lgc-robotics/end_effector_project/英红九号-郑晓鑫/工程图/新刀架2.tif

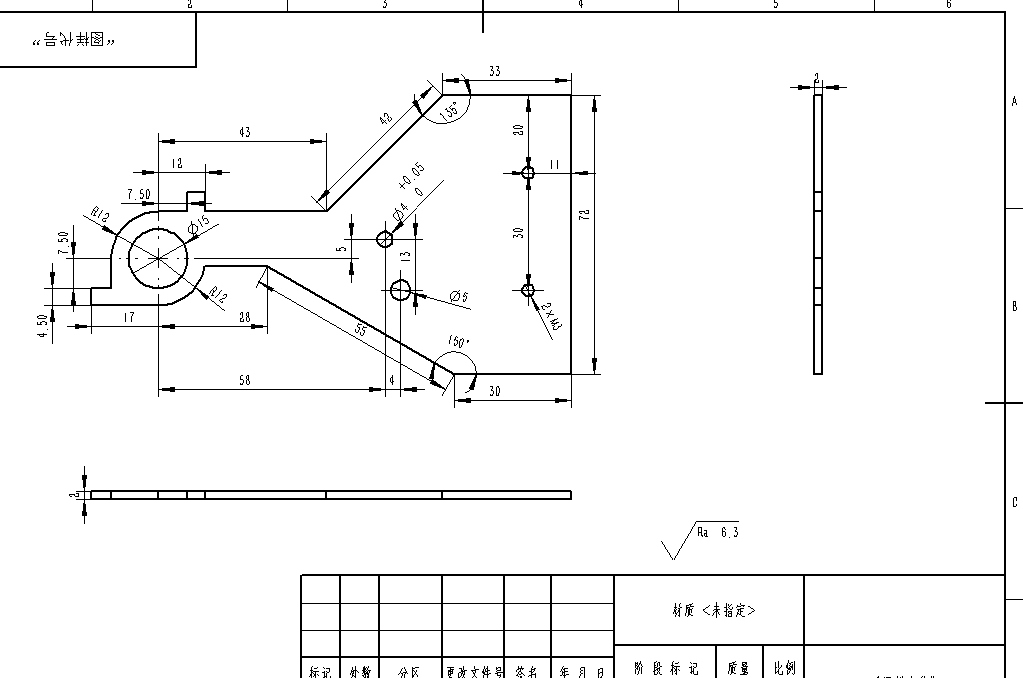
英红九号-郑晓鑫/工程图/新刀架2.tif
