lgc-robotics/end_effector_project/英红九号-郑晓鑫/末端装配6.16.SLDASM

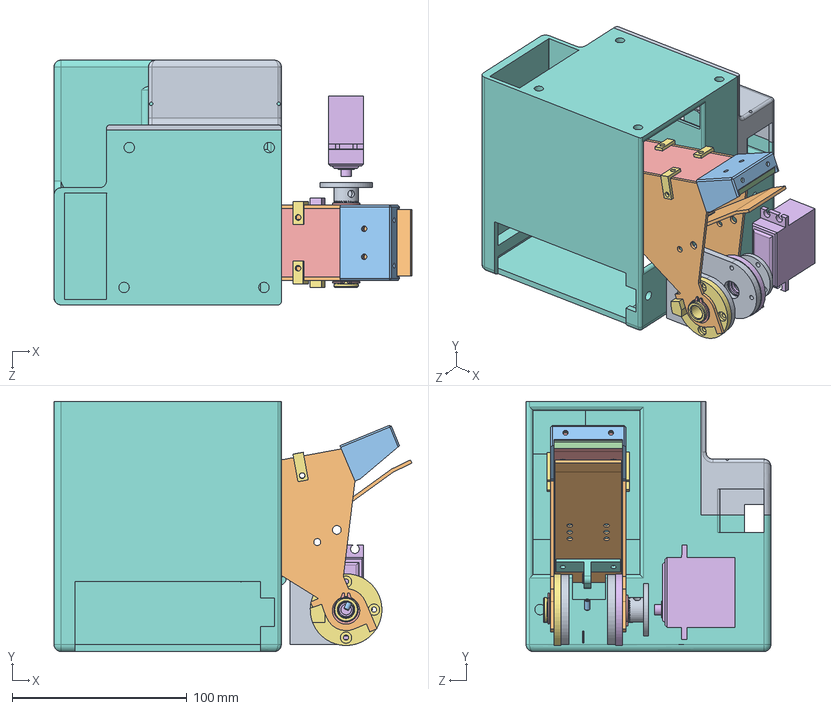
[picture p29: CAD file, 2026-08-05]
英红九号-郑晓鑫/末端装配6.16.SLDASM
204.7 x 143.1 x 140.0 mm
底座零件 x 2
T型块1
上刀轴套
上刀轴套右
卡簧 x 2
卡簧φ3 x 2
紧固螺钉m3-6
下刀板
轴盘
新刀架2 x 2
上刀座
上刀片
上刀架
舵机主体
上刀板L型块 x 4
零件3
封盖
