lgc-robotics/end_effector_project/夹剪复合末端执行器-谭键聪/图纸/链接板.SLDPRT.SLDPRT

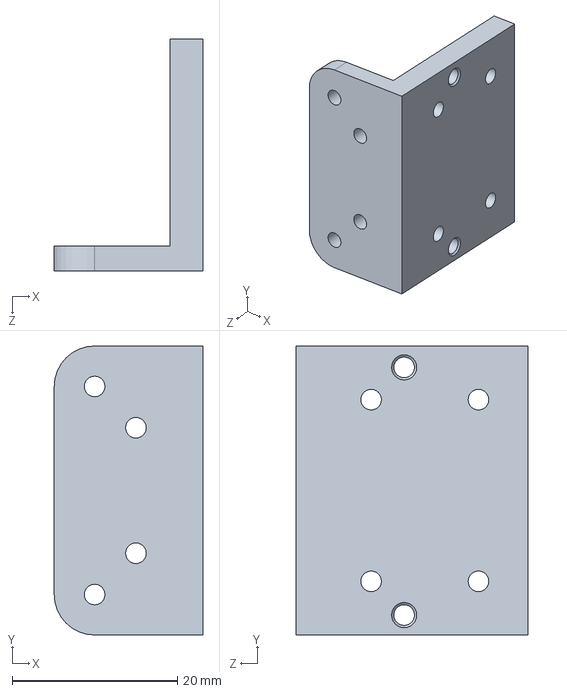
[picture p30: CAD file, 2026-08-05]
夹剪复合末端执行器-谭键聪/图纸/链接板.SLDPRT.SLDPRT
18.0 x 35.0 x 28.1 mm
