lgc-robotics/end_effector_project/夹剪复合末端执行器-谭键聪/装配体.STEP

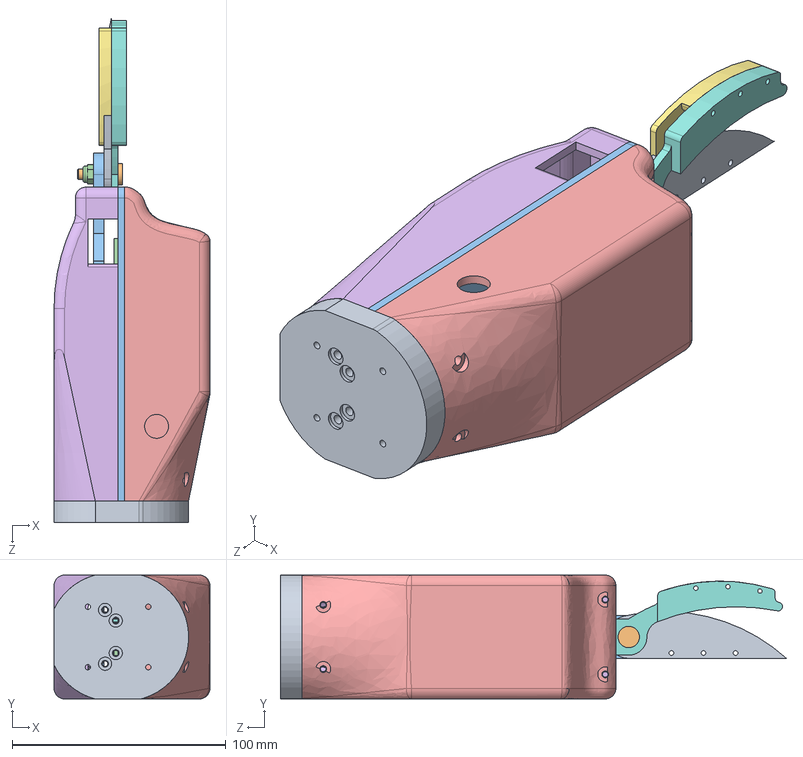
[picture p31: CAD file, 2026-08-05]
夹剪复合末端执行器-谭键聪/装配体.STEP
73.0 x 58.0 x 236.8 mm
后法兰
链接板
底板(5.29)
舵机
舵盘
主动齿轮_GB - Spur gear 0.8M 30T 20PA 5FW ---S30A75H50L6.0N
静刀上
静刀
20度刀
轴
从动齿轮
m5防松螺母
零件2_剪切部分装配体
零件4_剪切部分装配体
