lgc-robotics/end_effector_project/夹剪复合末端执行器-谭键聪/零件/step/零件3.STEP

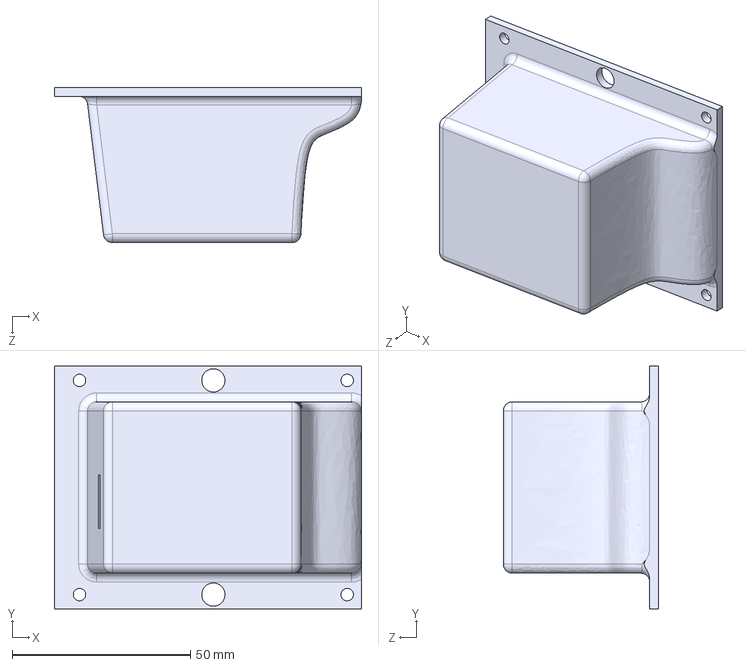
[picture p32: CAD file, 2026-08-05]
夹剪复合末端执行器-谭键聪/零件/step/零件3.STEP
86.0 x 68.0 x 43.5 mm
