lgc-robotics/end_effector_project/夹剪复合末端执行器-谭键聪/零件/静刀.SLDPRT

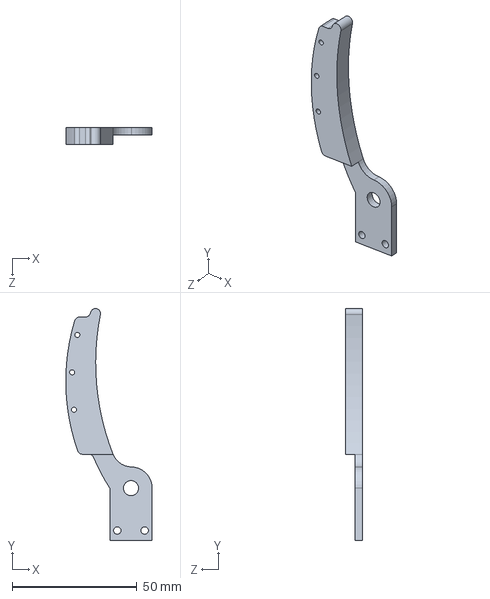
[picture p33: CAD file, 2026-08-05]
夹剪复合末端执行器-谭键聪/零件/静刀.SLDPRT
34.6 x 93.0 x 7.00 mm
