lgc-robotics/end_effector_project/潭江茶-谭键聪/第一代谭江茶/加工件/step/小轴长.STEP

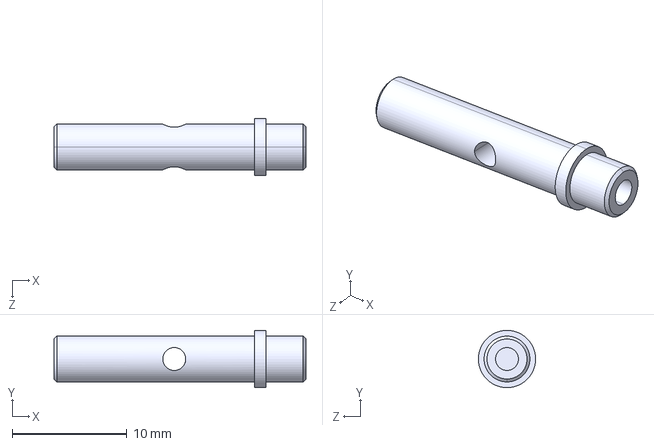
[picture p34: CAD file, 2026-08-05]
潭江茶-谭键聪/第一代谭江茶/加工件/step/小轴长.STEP
22.0 x 5.00 x 5.00 mm
