lgc-robotics/end_effector_project/潭江茶-谭键聪/第一代谭江茶/加工件/新收集盒1.step.SLDPRT

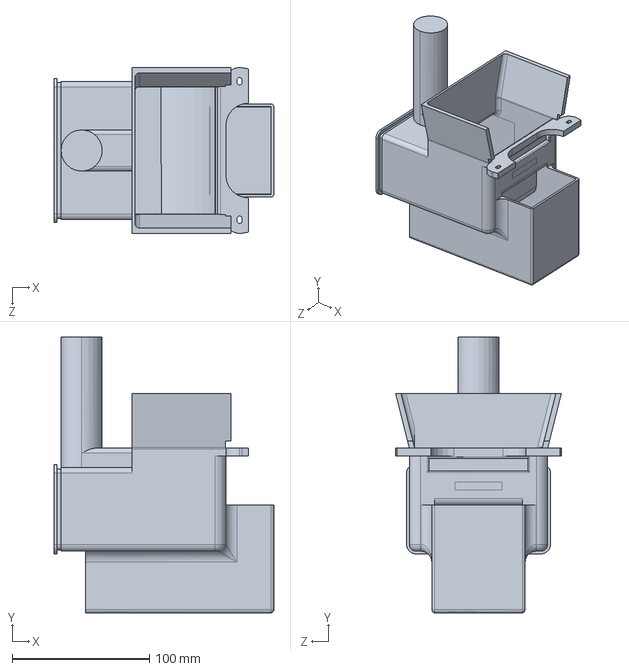
[picture p35: CAD file, 2026-08-05]
潭江茶-谭键聪/第一代谭江茶/加工件/新收集盒1.step.SLDPRT
160.0 x 201.0 x 120.8 mm
