lgc-robotics/end_effector_project/潭江茶-谭键聪/第一代谭江茶/打印件/上盖挡边2.SLDPRT

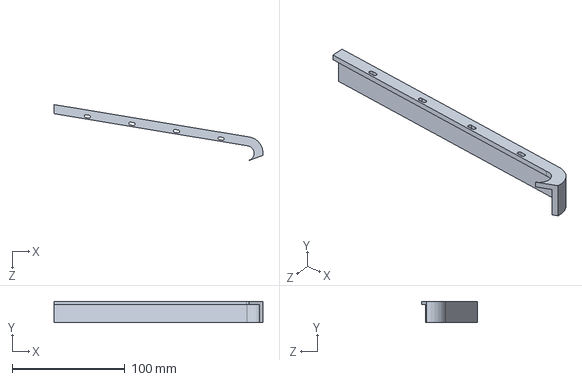
[picture p36: CAD file, 2026-08-05]
潭江茶-谭键聪/第一代谭江茶/打印件/上盖挡边2.SLDPRT
185.2 x 19.0 x 49.5 mm
