lgc-robotics/end_effector_project/潭江茶-谭键聪/第一代谭江茶/打印件/新建文件夹/盖板.STEP

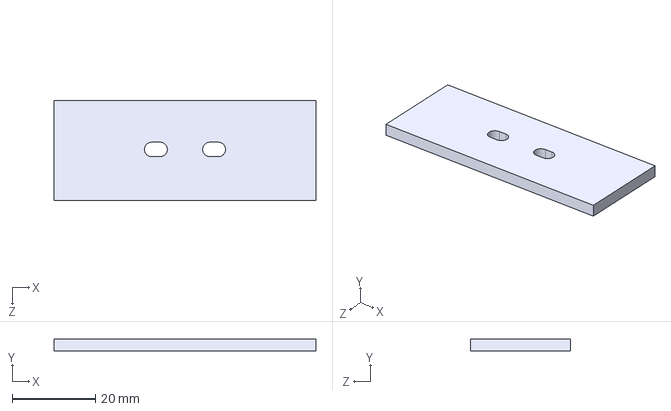
[picture p37: CAD file, 2026-08-05]
潭江茶-谭键聪/第一代谭江茶/打印件/新建文件夹/盖板.STEP
63.0 x 3.00 x 24.0 mm
