lgc-robotics/end_effector_project/潭江茶-谭键聪/第一代谭江茶/装配体1.STEP

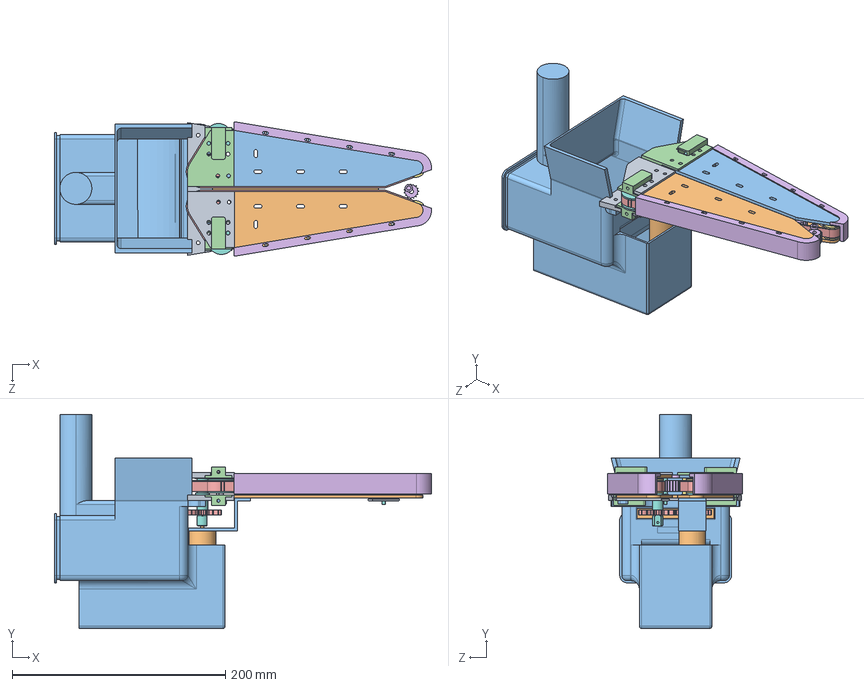
[picture p38: CAD file, 2026-08-05]
潭江茶-谭键聪/第一代谭江茶/装配体1.STEP
353.4 x 201.0 x 126.2 mm
底座后
底座前
电机架
大轴承 x 3
30齿 x 2
15齿无挡边 x 2
15齿有挡边 x 2
22齿有挡边 x 2
22齿轴 x 2
电机
滑块 x 4
滑块底座 x 4
皮带 x 2
小轴承 x 10
小轴短 x 3
主动轴 x 2
上盖1后
上盖1前
上盖2
上盖2后
spur gear_gb_GB - Spur gear 2M 16T 20PA 5FW ---S16A75H50L10.0N x 2
上盖挡边1
上盖挡边2
8mm轴承 x 2
小轴长改
刀片新
新收集盒1.step
