lgc-robotics/end_effector_project/潭江茶-谭键聪/第一代谭江茶/购买件/30齿.SLDPRT

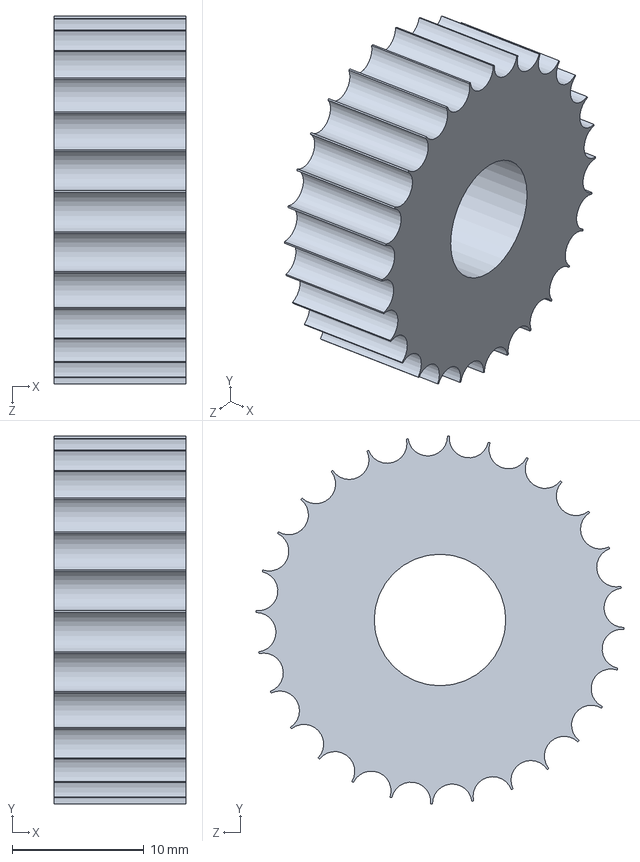
[picture p39: CAD file, 2026-08-05]
潭江茶-谭键聪/第一代谭江茶/购买件/30齿.SLDPRT
10.0 x 28.0 x 28.0 mm
