lgc-robotics/end_effector_project/潭江茶-谭键聪/第二代潭江茶/文件整合/step/上板右后.STEP

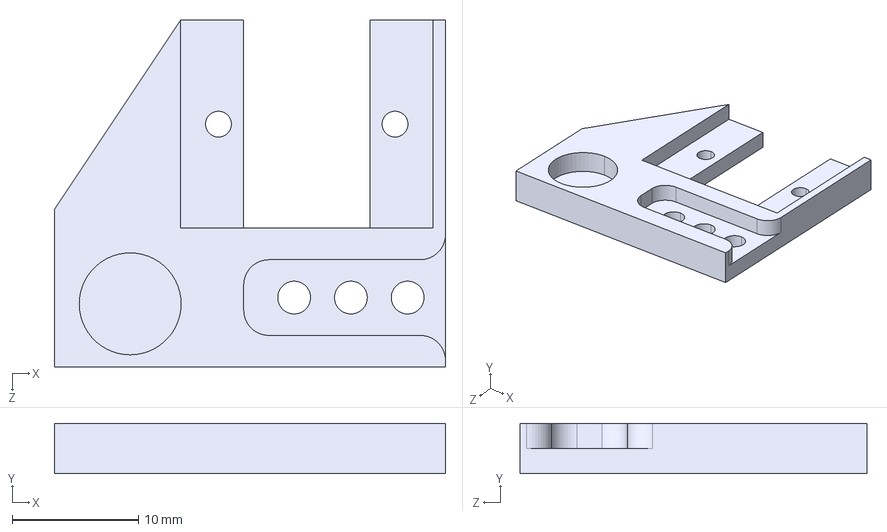
[picture p40: CAD file, 2026-08-05]
潭江茶-谭键聪/第二代潭江茶/文件整合/step/上板右后.STEP
31.0 x 4.00 x 27.5 mm
