lgc-robotics/end_effector_project/潭江茶-谭键聪/第二代潭江茶/文件整合/伞齿轮.SLDPRT

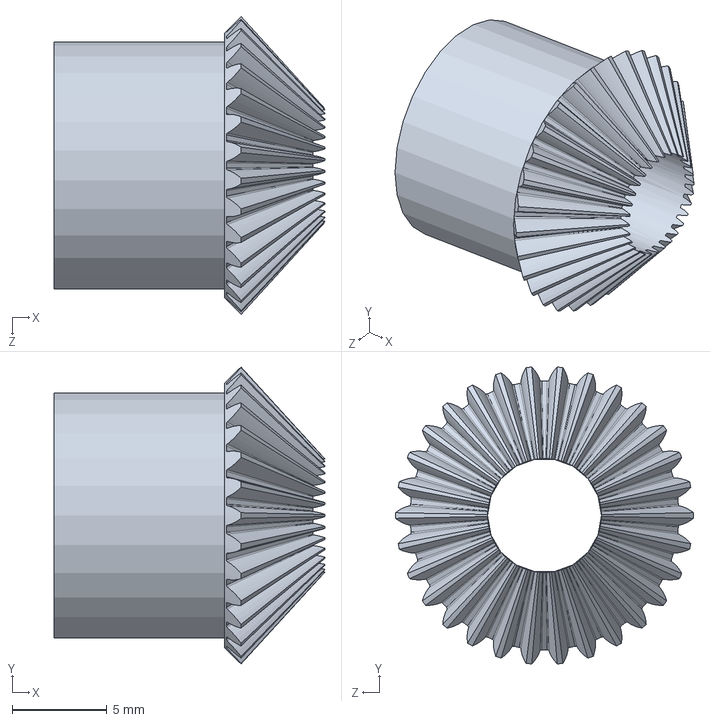
[picture p41: CAD file, 2026-08-05]
潭江茶-谭键聪/第二代潭江茶/文件整合/伞齿轮.SLDPRT
14.3 x 15.6 x 15.7 mm
