lgc-robotics/end_effector_project/潭江茶-谭键聪/第二代潭江茶/装配体.STEP

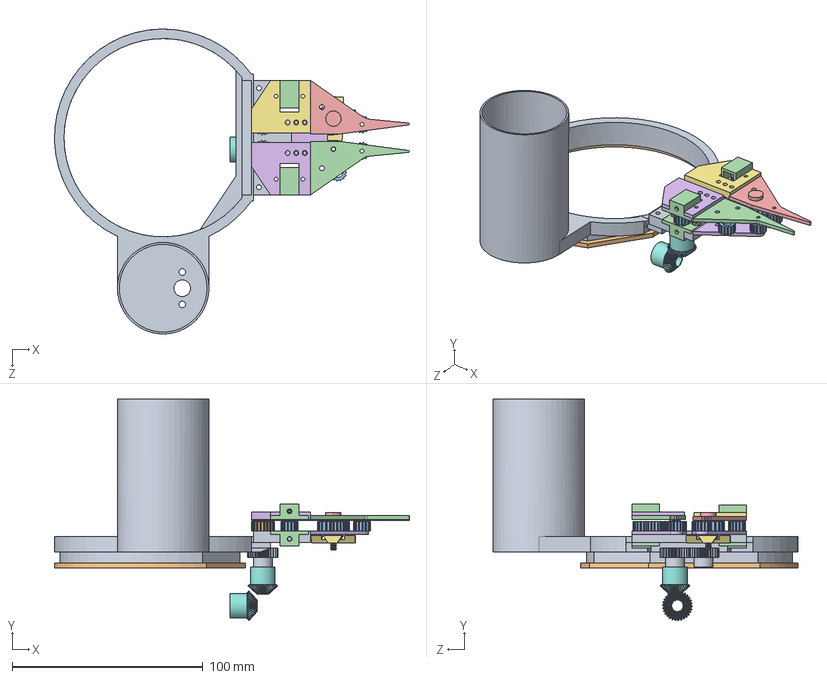
[picture p42: CAD file, 2026-08-05]
潭江茶-谭键聪/第二代潭江茶/装配体.STEP
186.2 x 116.2 x 159.9 mm
底板后
大带轮（20齿）22 x 2
带轮15齿.step x 5
滑块槽 x 4
绷紧块 x 4
上板右后
上板左后
轴
收集盒2
刀轮
上板右前1
上板左前1
底板前.step
刀片改
straight bevel pinion_gb_GB - Straight bevel pinion 0.5M30PT 30GT 20PA 12FW ---30O13H17MD6.0N x 2
spur gear_gb_GB - Spur gear 0.5M 30T 20PA 5FW ---S30B10H10L5.0N x 2
