lgc-robotics/end_effector_project/番石榴-丘圳中/番石榴装配体.STEP

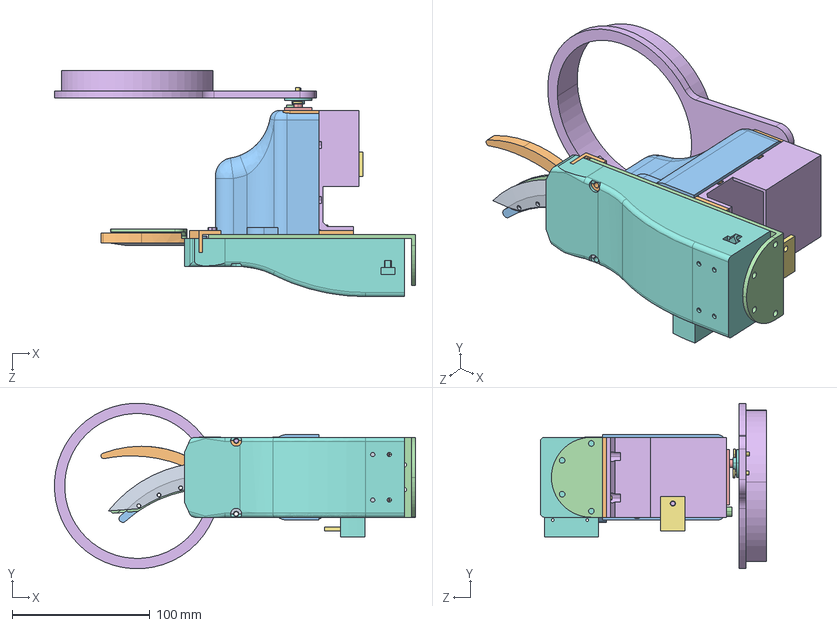
[picture p43: CAD file, 2026-08-05]
番石榴-丘圳中/番石榴装配体.STEP
261.7 x 119.8 x 164.0 mm
m5防松螺母
静刀5.10
轴
底板(5.29)
舵机 x 2
管口
M3螺斯 x 7
舵盘 x 2
电路板
L型连接板
下壳
螺丝 x 2
m4螺母 x 3
m3螺母 x 3
主动齿轮5.10_GB - Spur gear 0.8M 30T 20PA 5FW ---S30A75H50L6.0N
从动齿轮5.10_GB - Spur gear 0.8M 70T 20PA 5FW ---S70A75H50L6.0N
动刀5.10
挡板
泡棉挡块
泡棉挡块2
绝缘板
电池支架
电池锁定扣
外壳（6.30）(2)
