lgc-robotics/end_effector_project/番石榴_傅文平/末端执行器.STEP

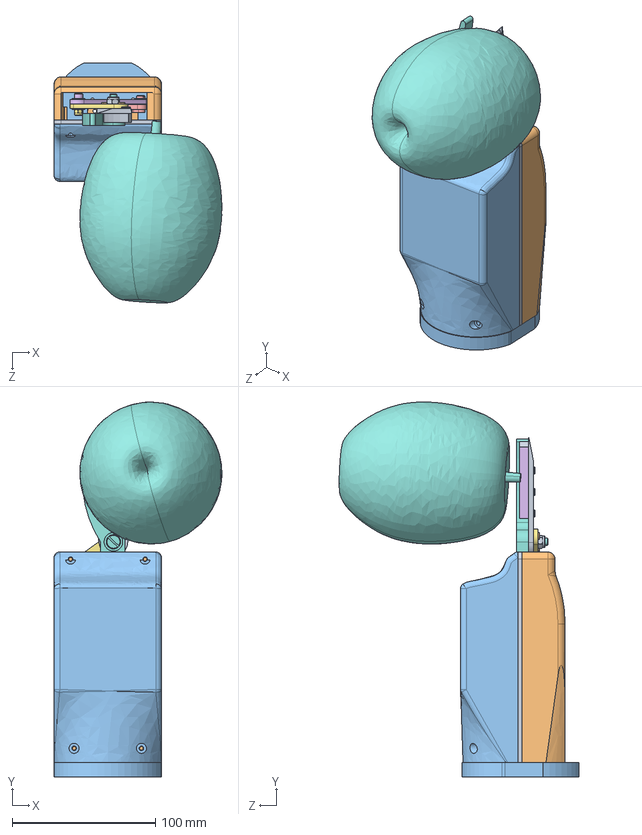
[picture p44: CAD file, 2026-08-05]
番石榴_傅文平/末端执行器.STEP
117.2 x 261.7 x 167.3 mm
底板5.25
lianijie
falan
舵机
LV-DUOBAN_1
连杆
摇杆
静刀
20度刀23
上
下
轴承 x 3
LC-TBH84-d4-L6
EMLC-S1-N-M3_EMLC-C2-N~EMLC-S1-N
EDDG-S3W-d6-L10
EMLC-S1-N-M5_EMLC-C2-N~EMLC-S1-N
ELSV-S1W-M3-L5-S5 x 2
GB╱T 29.1-2013[六角头带槽螺栓M3×10]_M3×10 x 2
GB╱T 29.2-1988[十字槽凹穴六角头螺栓M4×14]_M4×14 x 4
零件
复件 零件12^5.25
ELSV-S1W-M2-L8-S5 x 3
果实
零件1^5.25
