lgc-robotics/end_effector_project/英红九号-何子健/第二代末端执行器20261014/加工件/收集舵机固定架.SLDPRT

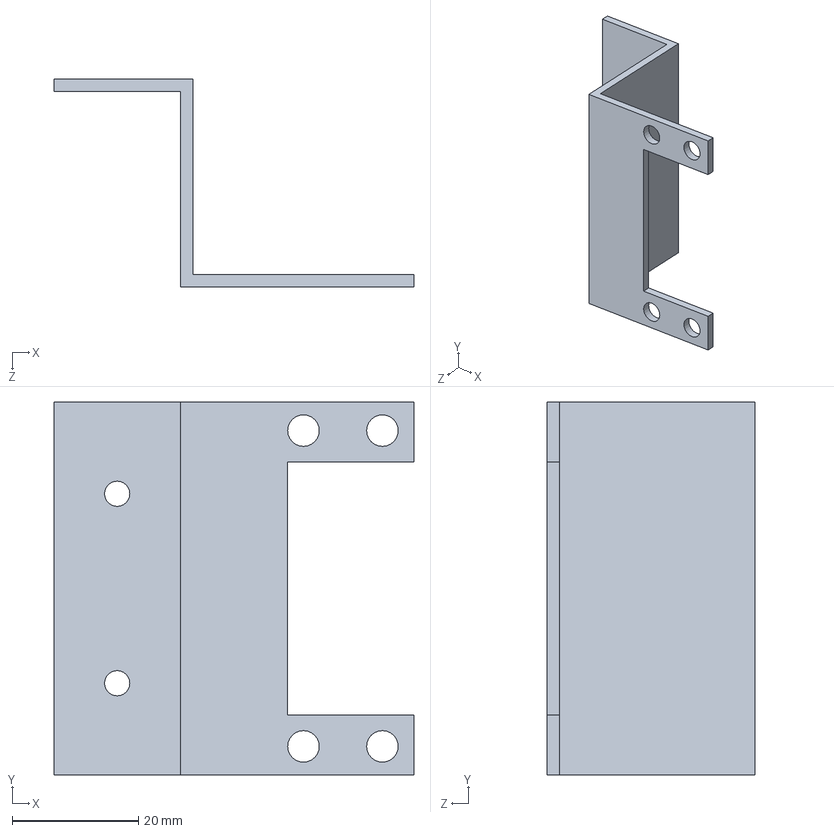
[picture p45: CAD file, 2026-10-14]
英红九号-何子健/第二代末端执行器20261014/加工件/收集舵机固定架.SLDPRT
57.0 x 59.0 x 33.0 mm
