lgc-robotics/end_effector_project/英红九号-何子健/第二代末端执行器20261014/打印件/收集轴盘.SLDPRT

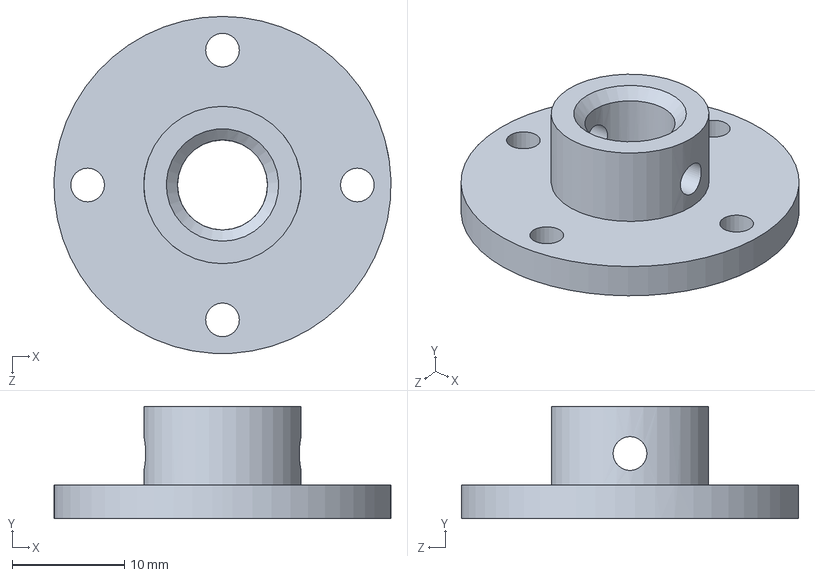
[picture p46: CAD file, 2026-10-14]
英红九号-何子健/第二代末端执行器20261014/打印件/收集轴盘.SLDPRT
30.0 x 10.0 x 30.0 mm
