lgc-robotics/end_effector_project/英红九号-何子健/第二代末端执行器20261014/提拉式末端执行器.STEP

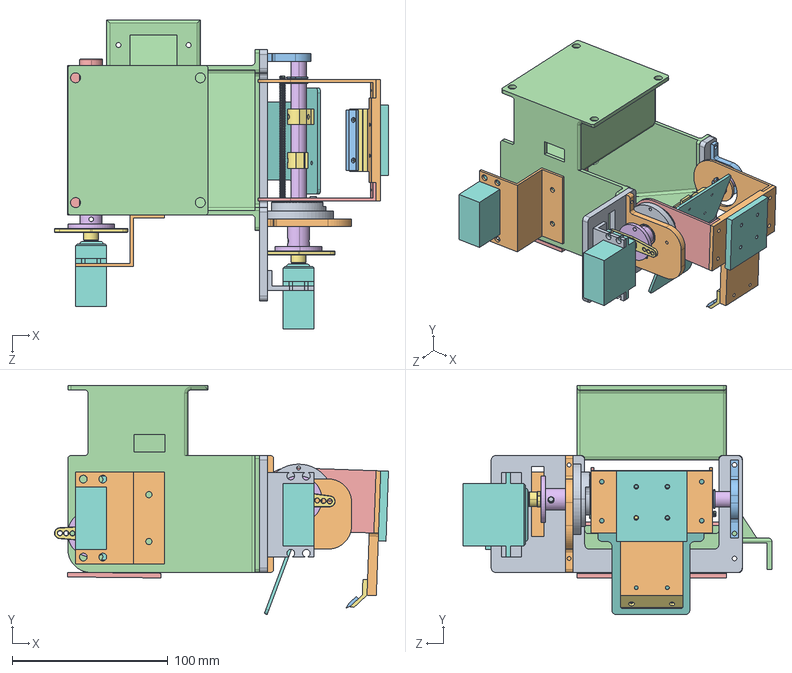
[picture p47: CAD file, 2026-10-14]
英红九号-何子健/第二代末端执行器20261014/提拉式末端执行器.STEP
214.2 x 147.0 x 198.0 mm
基准板
右轴承座
左轴承座
轴承（6x10x3）
轴承（8x16x4）
转轴
固定夹 x 2
下鄂
限位凸台
上颚
C型弹性挡圈-轴用 DQA[DQA-10] x 2
新m3-50
右侧板
轴盘
十字臂 x 2
舵机主体 x 2
新缓冲垫 x 2
左侧板
新刀片
外壳_hzj
收集下板
收集轴盘
刀片连接件
重物
执行舵机固定板
收集舵机固定架
