lgc-robotics/end_effector_project/英红九号-何子健/第二代末端执行器20261014/购买件/新缓冲垫.SLDPRT

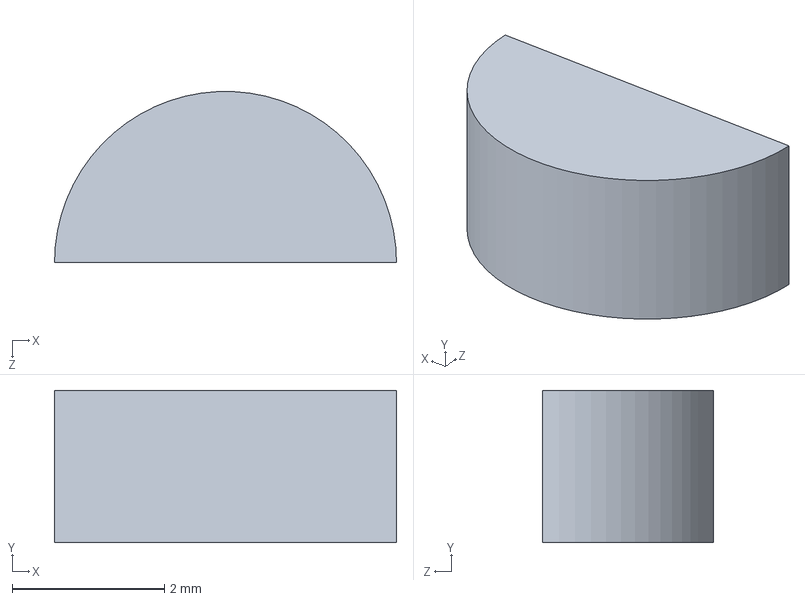
[picture p48: CAD file, 2026-10-14]
英红九号-何子健/第二代末端执行器20261014/购买件/新缓冲垫.SLDPRT
4.50 x 2.00 x 2.25 mm
