lgc-robotics/end_effector_project/英红九号-何子健/第二代末端执行器20261014/零件STEP/限位凸台.STEP

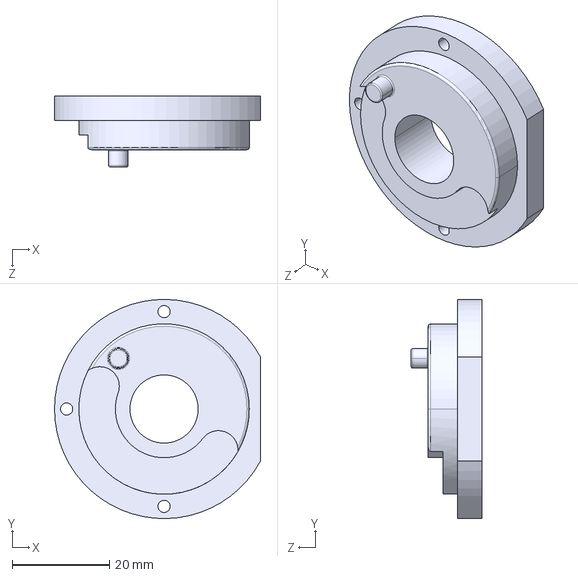
[picture p49: CAD file, 2026-10-14]
英红九号-何子健/第二代末端执行器20261014/零件STEP/限位凸台.STEP
42.3 x 45.0 x 14.5 mm
