lgc-robotics/end_effector_project/英红九号-郑晓鑫/step/45钢/主体轴.STEP

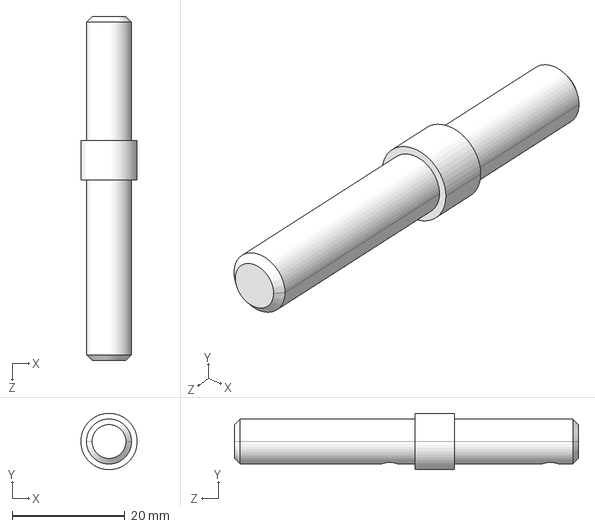
[picture p50: CAD file, 2026-08-05]
英红九号-郑晓鑫/step/45钢/主体轴.STEP
10.0 x 10.0 x 61.0 mm
