lgc-robotics/end_effector_project/英红九号-郑晓鑫/step/铝合金/新刀架2.STEP

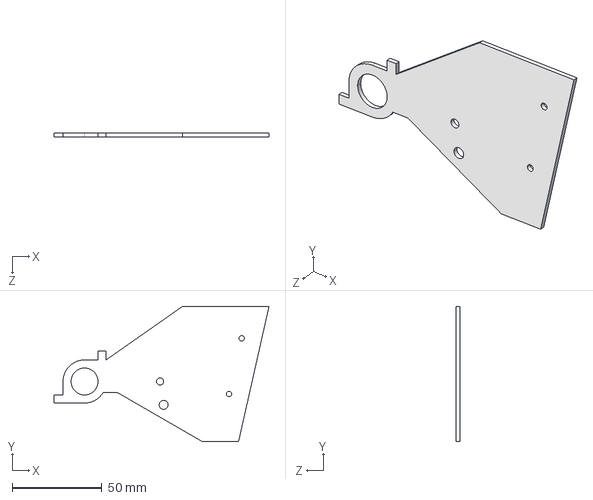
[picture p51: CAD file, 2026-08-05]
英红九号-郑晓鑫/step/铝合金/新刀架2.STEP
119.6 x 75.3 x 2.00 mm
