lgc-robotics/end_effector_project/英红九号-郑晓鑫/step/高速钢/上刀片.STEP

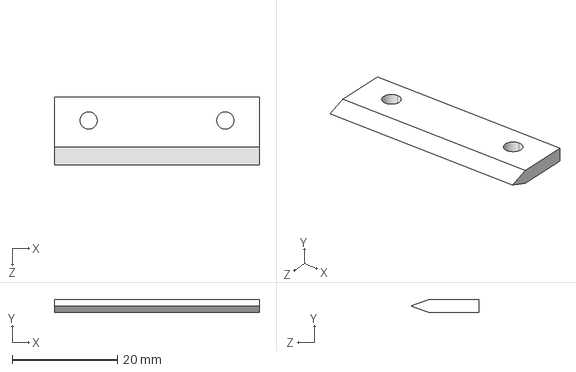
[picture p52: CAD file, 2026-08-05]
英红九号-郑晓鑫/step/高速钢/上刀片.STEP
39.0 x 2.50 x 13.0 mm
