lgc-robotics/end_effector_project/英红九号-郑晓鑫/底座零件.SLDPRT

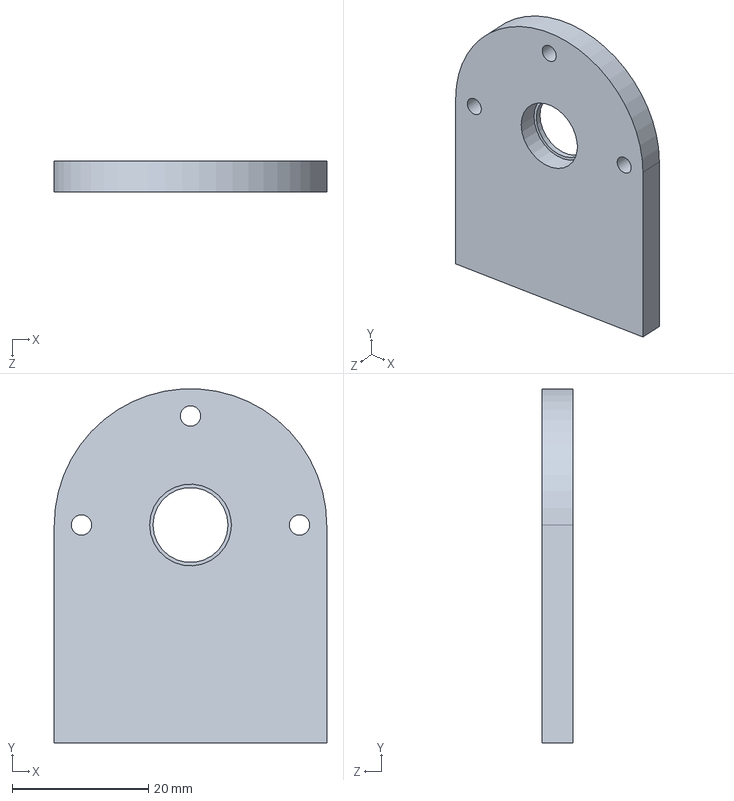
[picture p53: CAD file, 2026-08-05]
英红九号-郑晓鑫/底座零件.SLDPRT
40.0 x 52.0 x 4.50 mm
