lgc-robotics/end_effector_project/英红九号-郑晓鑫/打印/封盖.SLDPRT

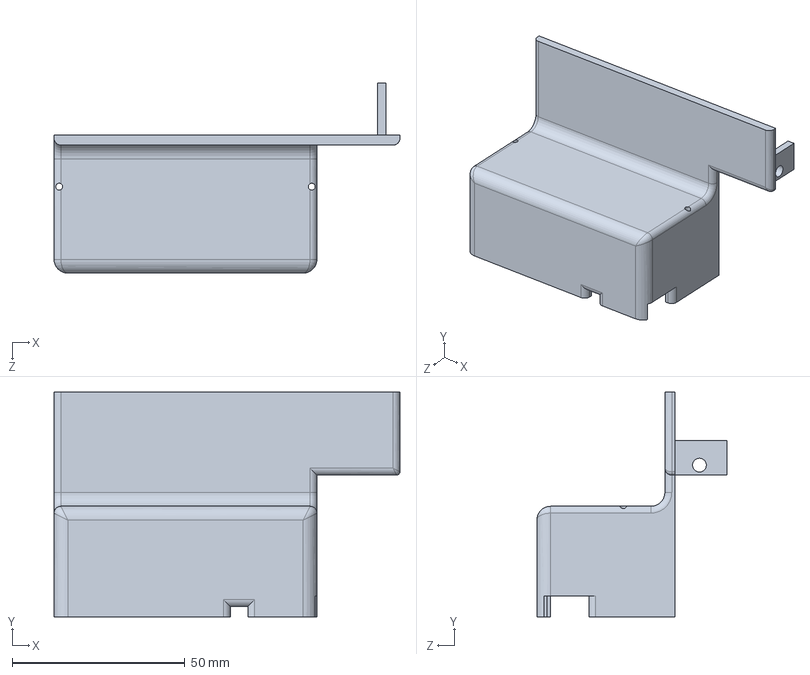
[picture p54: CAD file, 2026-08-05]
英红九号-郑晓鑫/打印/封盖.SLDPRT
100.0 x 65.0 x 55.0 mm
