lgc-robotics/end_effector_project/英红九号-郑晓鑫/打印/最新版/新抽屉.STL

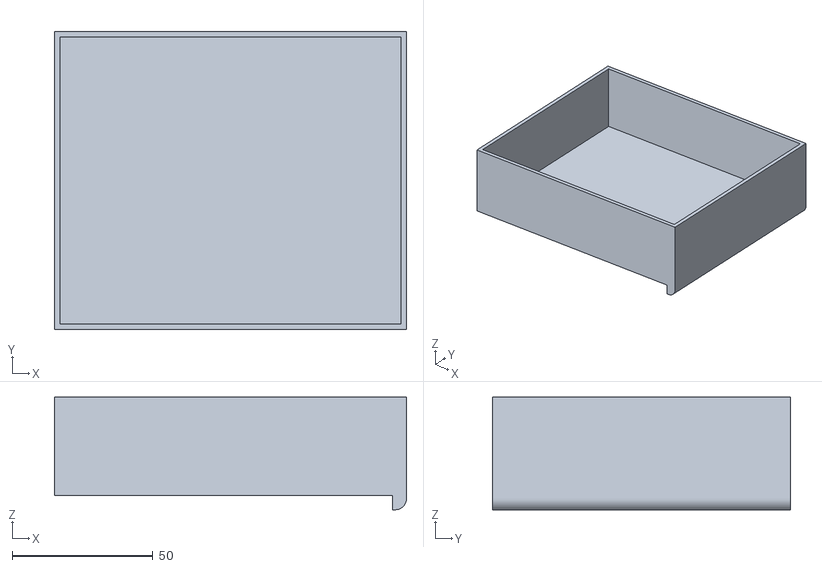
[picture p55: CAD file, 2026-08-05]
英红九号-郑晓鑫/打印/最新版/新抽屉.STL
125.0 x 105.8 x 40.0
