lgc-robotics/end_effector_project/英红九号-郑晓鑫/购买件/紧固螺钉m3-6.SLDPRT

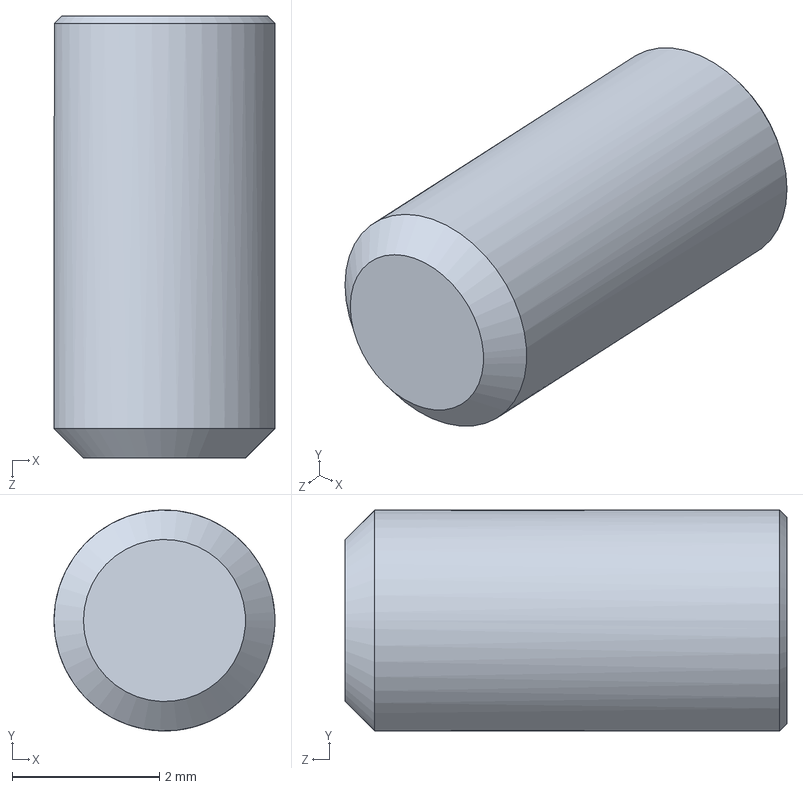
[picture p56: CAD file, 2026-08-05]
英红九号-郑晓鑫/购买件/紧固螺钉m3-6.SLDPRT
3.00 x 3.00 x 6.00 mm
