lgc-robotics/end_effector_project/蘑菇-姚上泉/蘑菇step格式.STEP

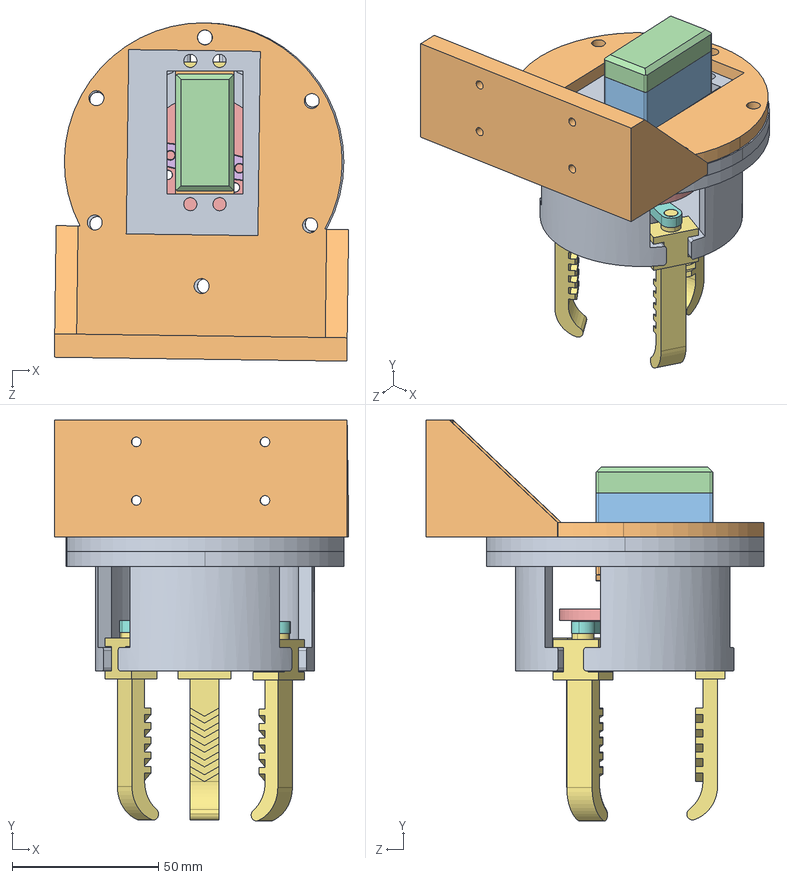
[picture p57: CAD file, 2026-08-05]
蘑菇-姚上泉/蘑菇step格式.STEP
100.6 x 137.1 x 115.7 mm
新蘑菇
舵机
舵机连接板
十字臂
零件2 x 3
零件4 x 3
零件1^蘑212
l型板
