lgc-robotics/end_effector_project/夹剪复合末端执行器-谭键聪/文件混合/底板(5.29).STEP

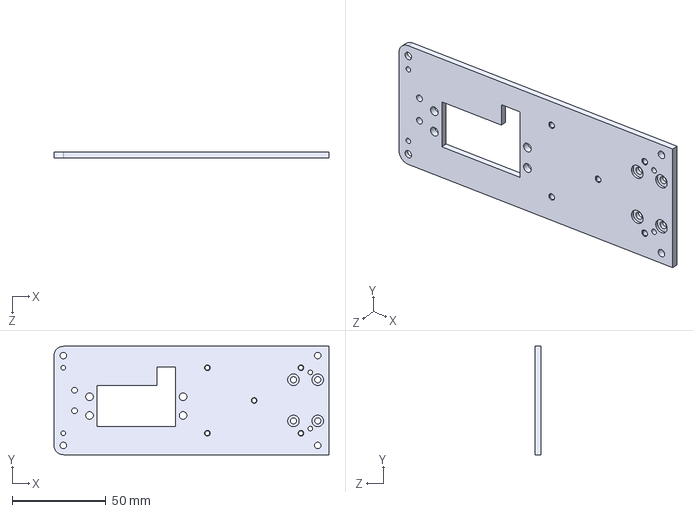
[picture p58: CAD file, 2026-08-05]
夹剪复合末端执行器-谭键聪/文件混合/底板(5.29).STEP
147.0 x 58.0 x 3.00 mm
