lgc-robotics/end_effector_project/夹剪复合末端执行器-谭键聪/零件/step/零件1.STEP

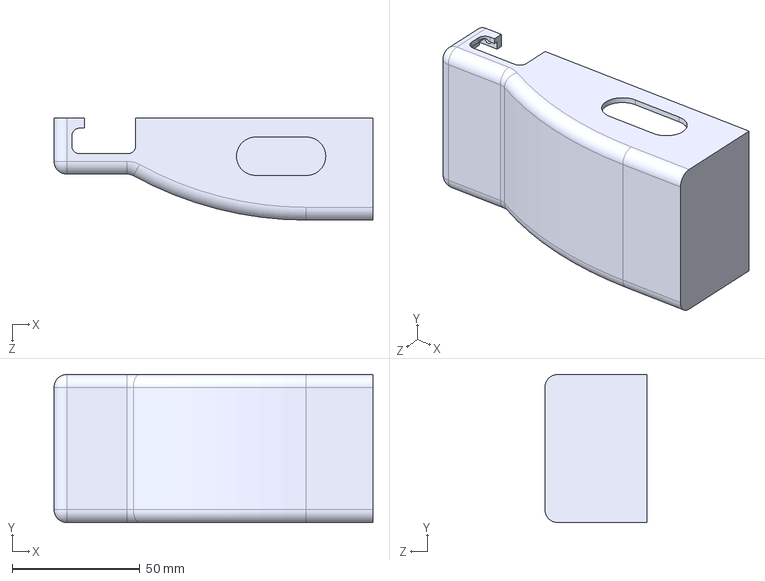
[picture p59: CAD file, 2026-08-05]
夹剪复合末端执行器-谭键聪/零件/step/零件1.STEP
125.0 x 58.0 x 40.0 mm
