lgc-robotics/end_effector_project/夹剪复合末端执行器-谭键聪/零件/静刀上.SLDPRT

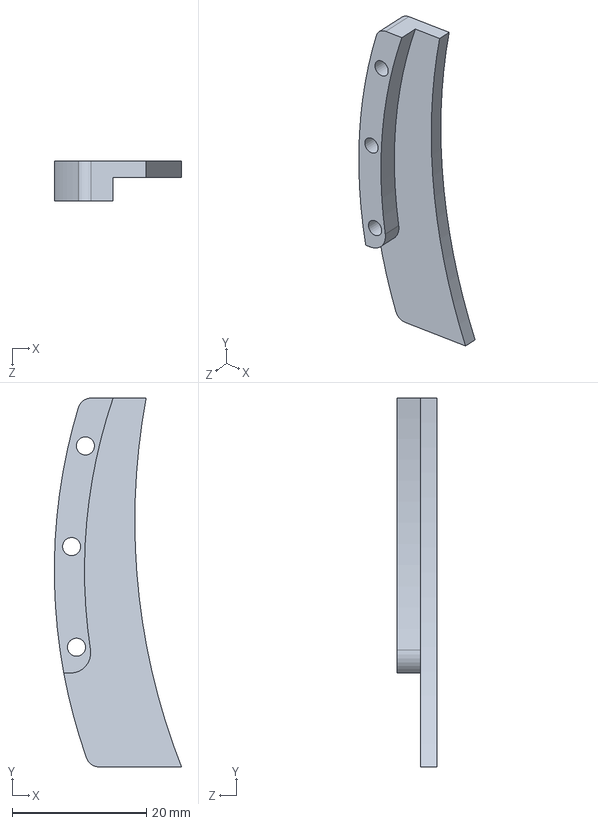
[picture p60: CAD file, 2026-08-05]
夹剪复合末端执行器-谭键聪/零件/静刀上.SLDPRT
19.0 x 55.0 x 6.00 mm
