lgc-robotics/end_effector_project/潭江茶-谭键聪/第一代谭江茶/加工件/step/上盖1后.STEP

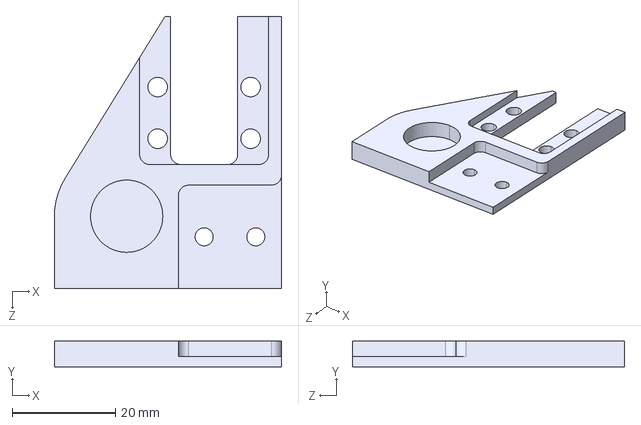
[picture p61: CAD file, 2026-08-05]
潭江茶-谭键聪/第一代谭江茶/加工件/step/上盖1后.STEP
44.0 x 5.00 x 52.7 mm
