lgc-robotics/end_effector_project/潭江茶-谭键聪/第一代谭江茶/购买件/15齿有挡边.SLDPRT

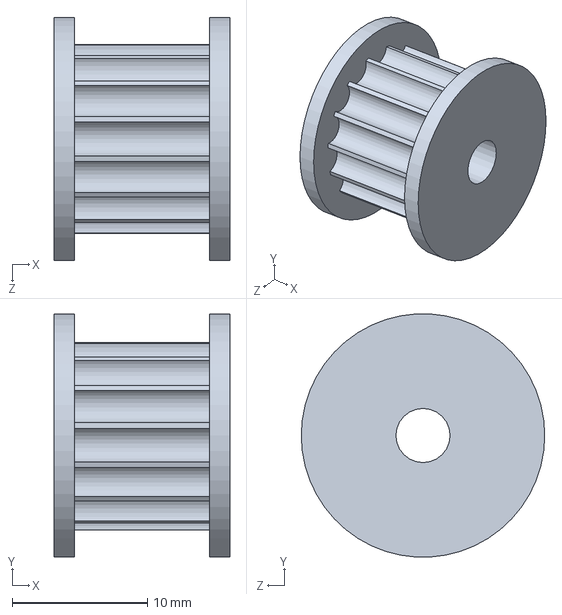
[picture p62: CAD file, 2026-08-05]
潭江茶-谭键聪/第一代谭江茶/购买件/15齿有挡边.SLDPRT
13.0 x 18.0 x 18.0 mm
