lgc-robotics/end_effector_project/潭江茶-谭键聪/第二代潭江茶/文件整合/step/上板左前1.STEP

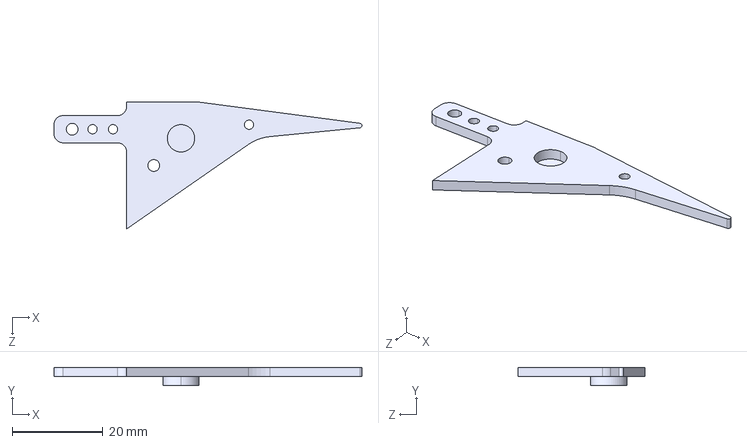
[picture p63: CAD file, 2026-08-05]
潭江茶-谭键聪/第二代潭江茶/文件整合/step/上板左前1.STEP
67.9 x 4.00 x 28.0 mm
