lgc-robotics/end_effector_project/潭江茶-谭键聪/第二代潭江茶/文件整合/皮带.STEP

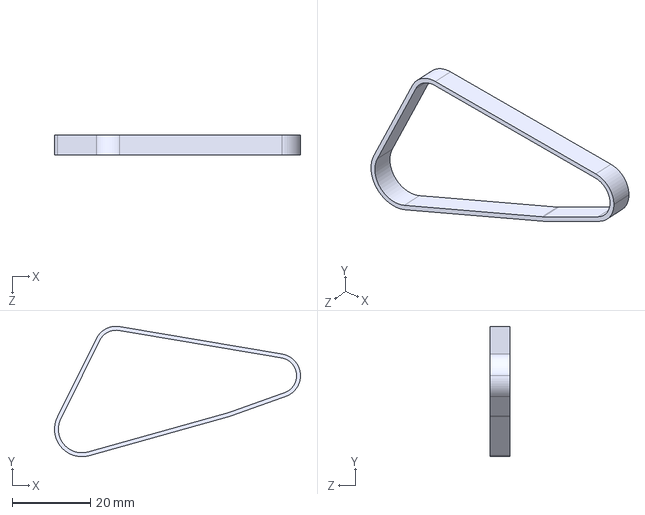
[picture p64: CAD file, 2026-08-05]
潭江茶-谭键聪/第二代潭江茶/文件整合/皮带.STEP
62.8 x 33.3 x 5.00 mm
