lgc-robotics/end_effector_project/英红九号-何子健/第二代末端执行器20261014/加工件/左侧板.SLDPRT

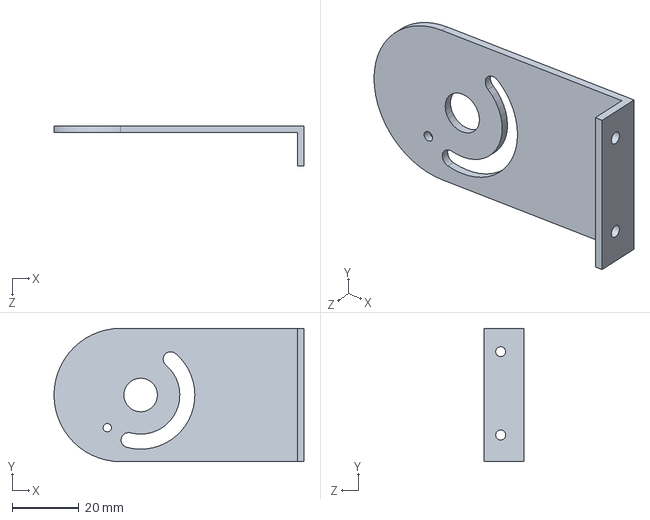
[picture p65: CAD file, 2026-10-14]
英红九号-何子健/第二代末端执行器20261014/加工件/左侧板.SLDPRT
75.0 x 40.0 x 12.0 mm
