lgc-robotics/end_effector_project/英红九号-何子健/第二代末端执行器20261014/打印件/刀片连接件.SLDPRT

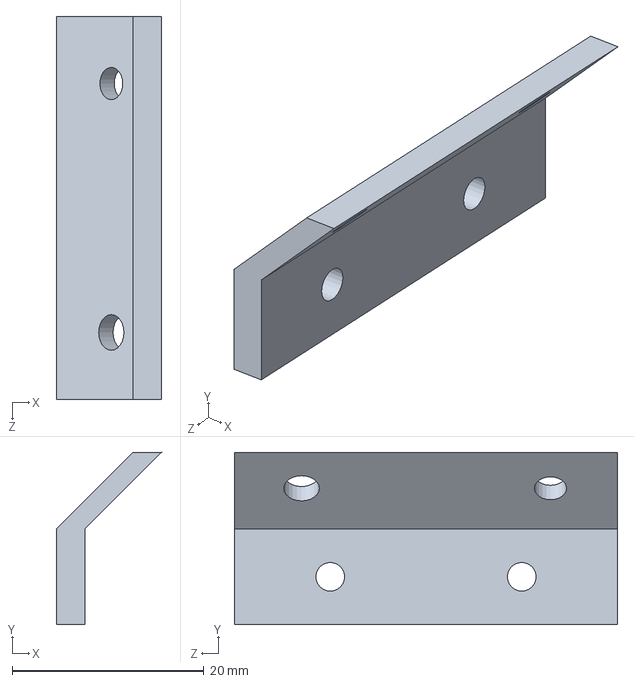
[picture p66: CAD file, 2026-10-14]
英红九号-何子健/第二代末端执行器20261014/打印件/刀片连接件.SLDPRT
11.0 x 18.0 x 40.0 mm
