lgc-robotics/end_effector_project/英红九号-何子健/第二代末端执行器20261014/购买件/新m3-50.SLDPRT

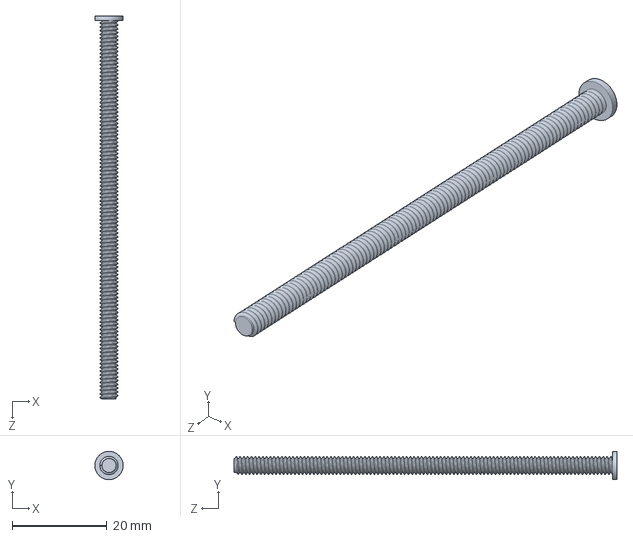
[picture p67: CAD file, 2026-10-14]
英红九号-何子健/第二代末端执行器20261014/购买件/新m3-50.SLDPRT
6.00 x 5.99 x 81.0 mm
