lgc-robotics/end_effector_project/英红九号-何子健/第二代末端执行器20261014/零件STEP/右轴承座.STEP

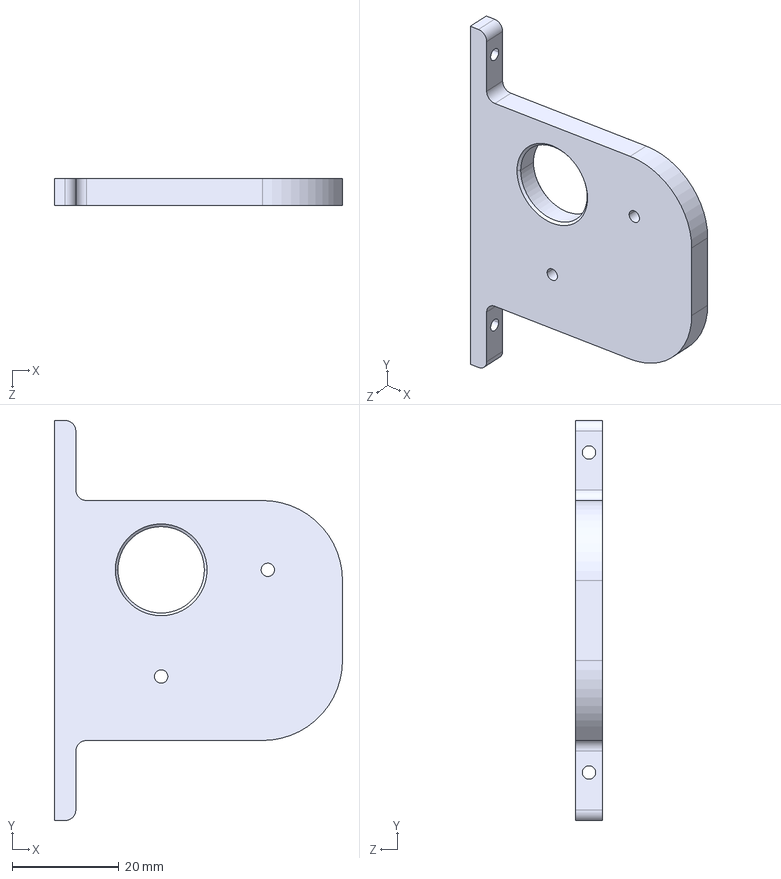
[picture p68: CAD file, 2026-10-14]
英红九号-何子健/第二代末端执行器20261014/零件STEP/右轴承座.STEP
54.0 x 75.0 x 5.00 mm
