lgc-robotics/end_effector_project/英红九号-郑晓鑫/step/铝合金/传动件1.STEP

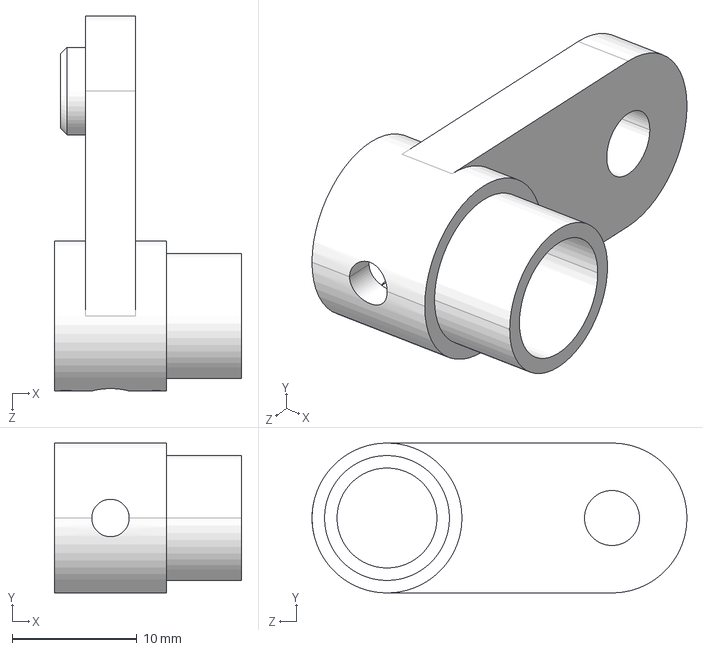
[picture p69: CAD file, 2026-08-05]
英红九号-郑晓鑫/step/铝合金/传动件1.STEP
15.0 x 12.0 x 30.0 mm
