lgc-robotics/end_effector_project/英红九号-郑晓鑫/T型块1.SLDPRT

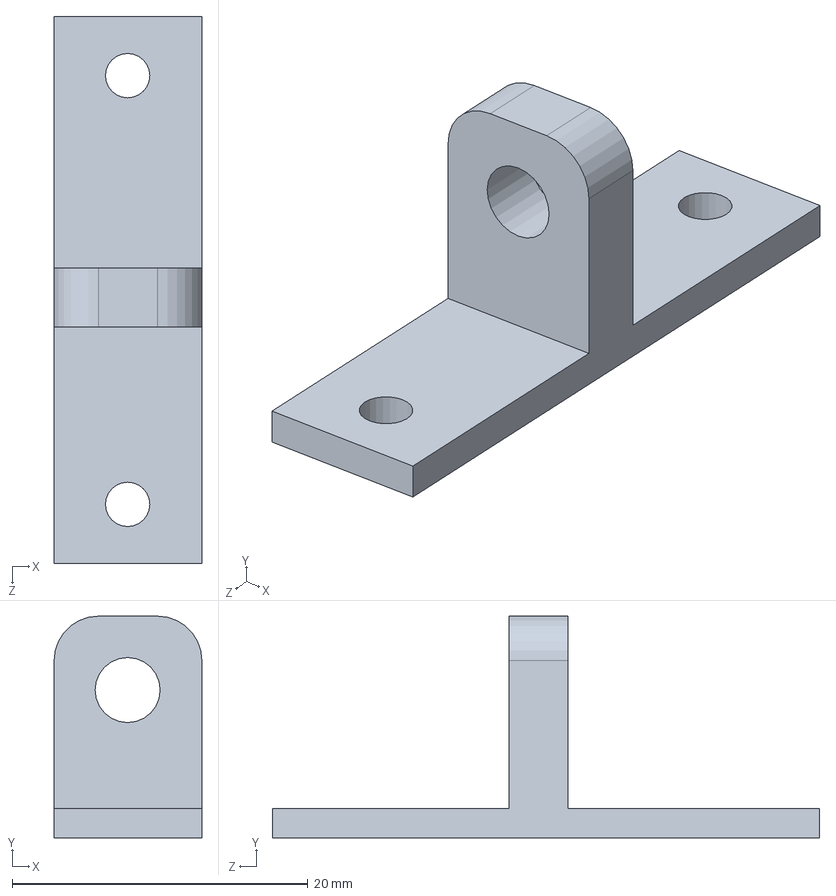
[picture p70: CAD file, 2026-08-05]
英红九号-郑晓鑫/T型块1.SLDPRT
10.0 x 15.0 x 37.0 mm
