lgc-robotics/end_effector_project/英红九号-郑晓鑫/打印/上刀轴套右.SLDPRT

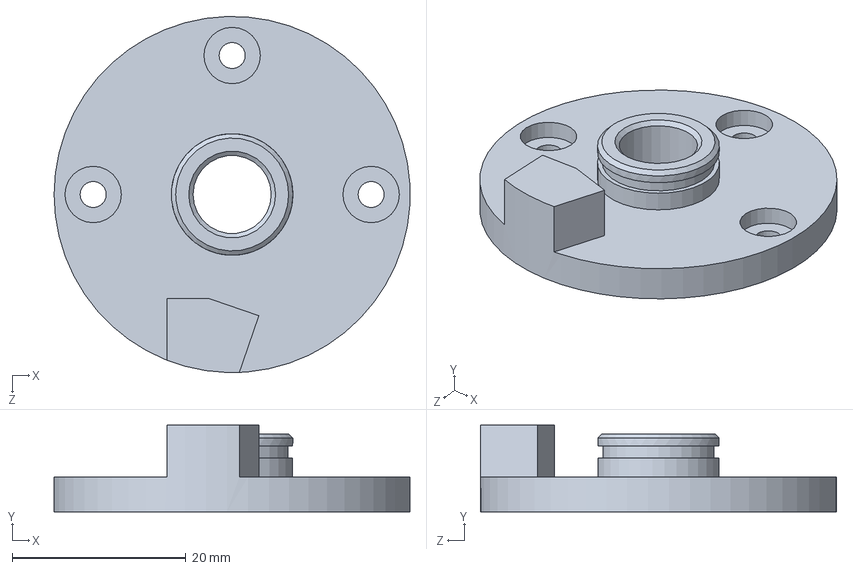
[picture p71: CAD file, 2026-08-05]
英红九号-郑晓鑫/打印/上刀轴套右.SLDPRT
41.0 x 10.0 x 41.0 mm
