lgc-robotics/end_effector_project/英红九号-郑晓鑫/打印/最新版/舵机封盖.STL

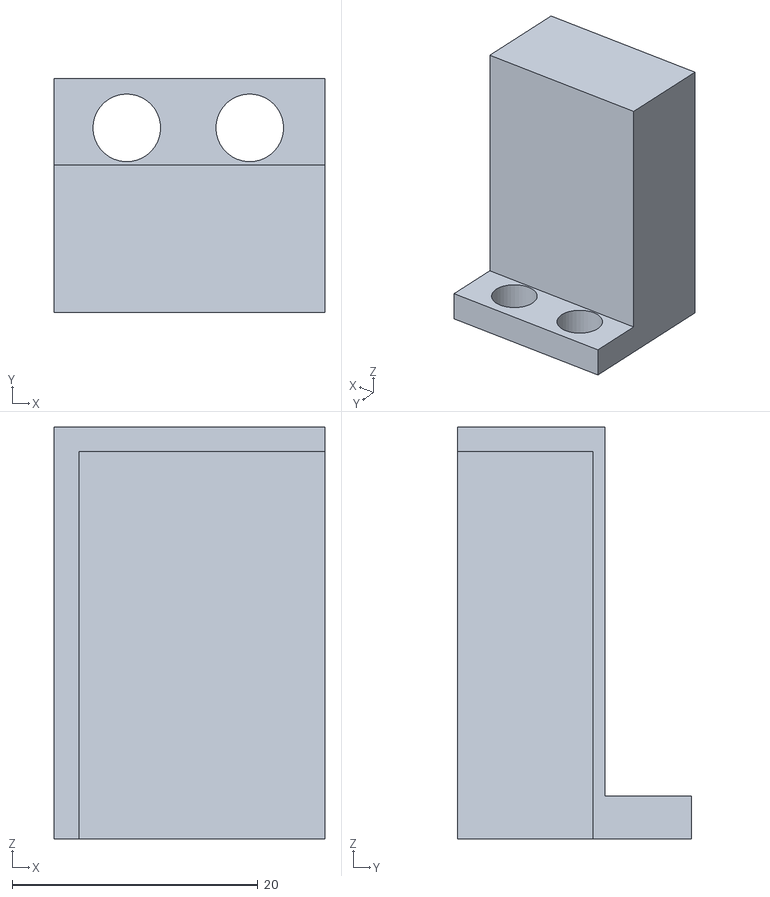
[picture p72: CAD file, 2026-08-05]
英红九号-郑晓鑫/打印/最新版/舵机封盖.STL
22.0 x 19.0 x 33.5
