lgc-robotics/end_effector_project/英红九号-郑晓鑫/购买件/卡簧φ3.SLDPRT

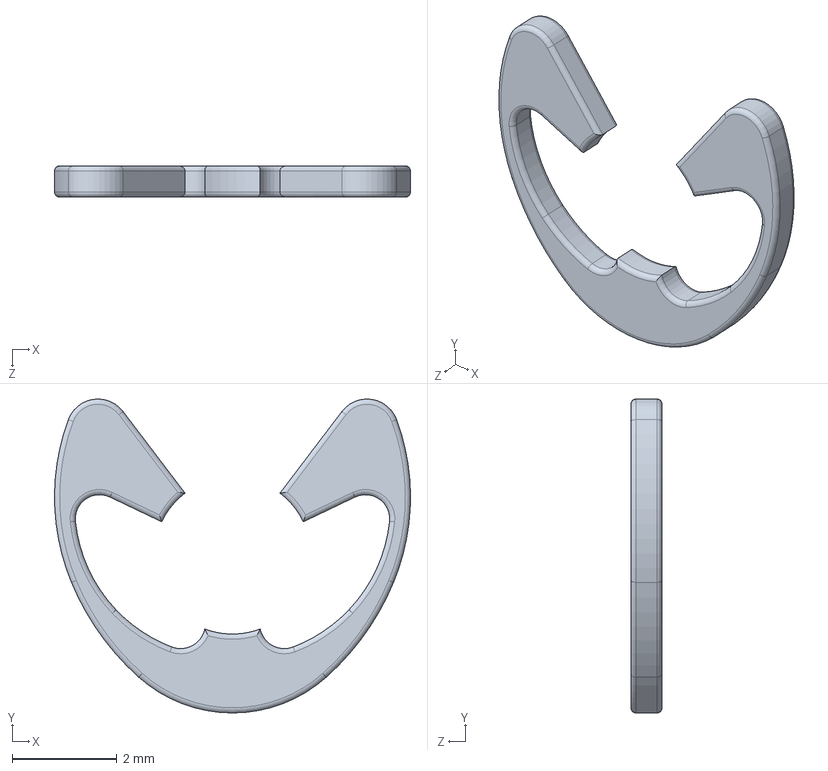
[picture p73: CAD file, 2026-08-05]
英红九号-郑晓鑫/购买件/卡簧φ3.SLDPRT
6.81 x 6.00 x 0.6 mm
