lgc-robotics/end_effector_project/夹剪复合末端执行器-谭键聪/文件混合/后法兰.STEP

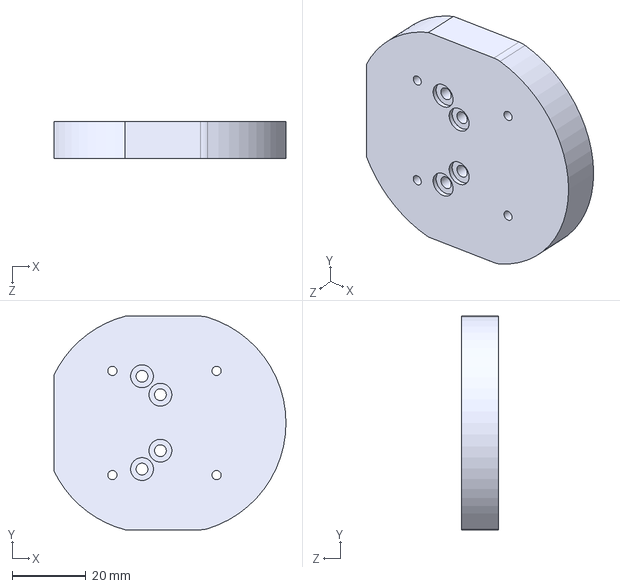
[picture p74: CAD file, 2026-08-05]
夹剪复合末端执行器-谭键聪/文件混合/后法兰.STEP
63.0 x 58.0 x 10.0 mm
