lgc-robotics/end_effector_project/潭江茶-谭键聪/第一代谭江茶/加工件/step/底座后.STEP

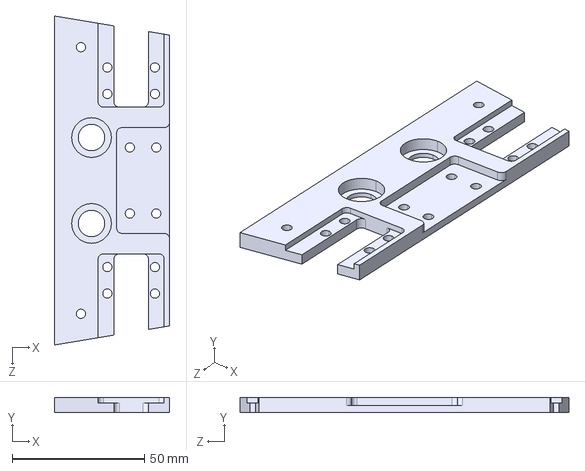
[picture p75: CAD file, 2026-08-05]
潭江茶-谭键聪/第一代谭江茶/加工件/step/底座后.STEP
43.5 x 5.50 x 124.4 mm
