lgc-robotics/end_effector_project/潭江茶-谭键聪/第一代谭江茶/购买件/刀片.SLDPRT

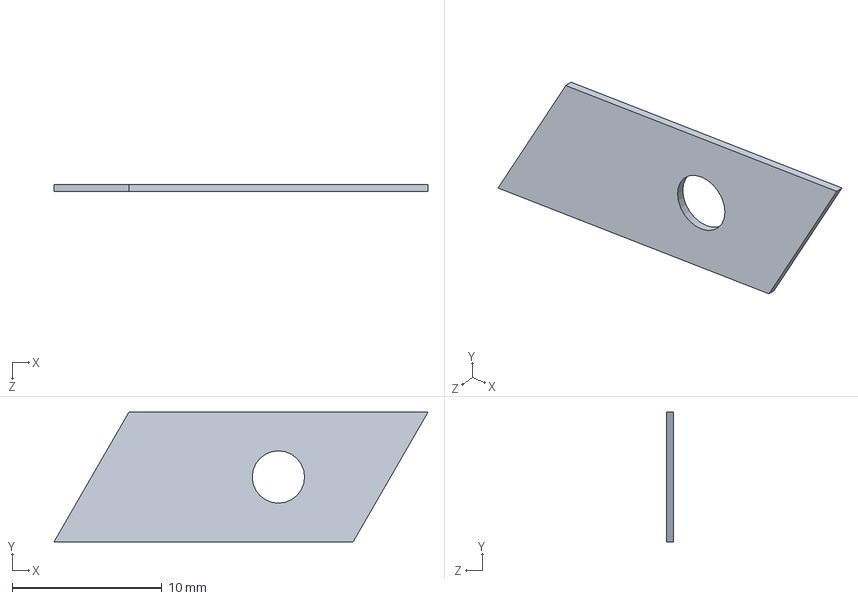
[picture p76: CAD file, 2026-08-05]
潭江茶-谭键聪/第一代谭江茶/购买件/刀片.SLDPRT
25.0 x 8.66 x 0.5 mm
