lgc-robotics/end_effector_project/潭江茶-谭键聪/第二代潭江茶/文件整合/step/滑块槽.STEP

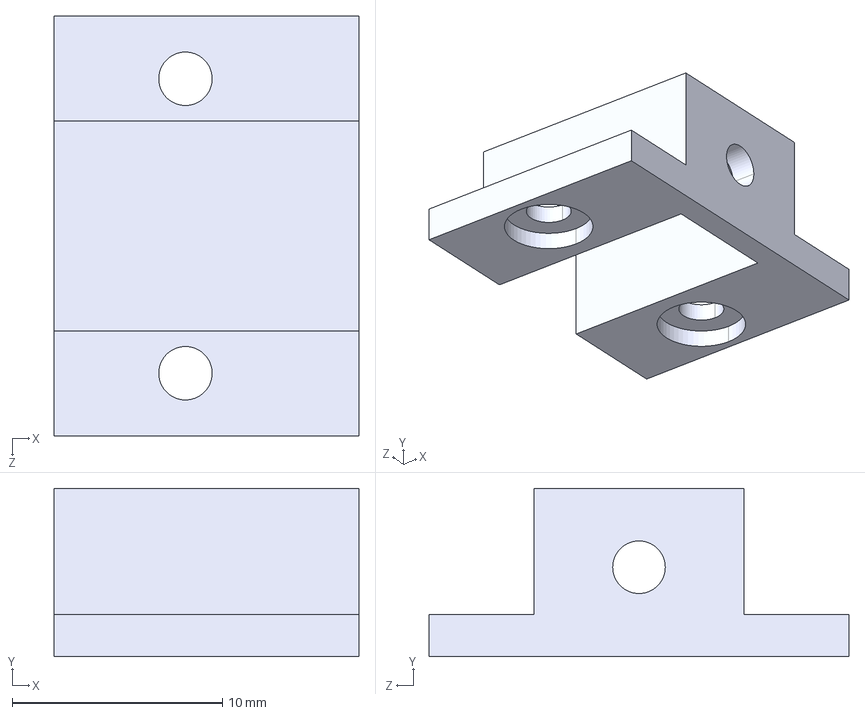
[picture p77: CAD file, 2026-08-05]
潭江茶-谭键聪/第二代潭江茶/文件整合/step/滑块槽.STEP
14.5 x 8.00 x 20.0 mm
