lgc-robotics/end_effector_project/潭江茶-谭键聪/第二代潭江茶/文件整合/大带轮（20齿）22.SLDPRT

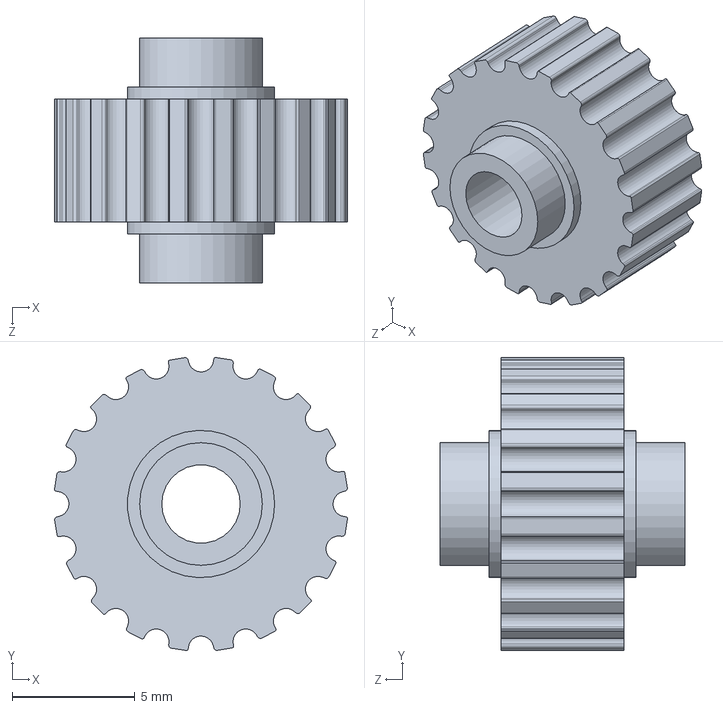
[picture p78: CAD file, 2026-08-05]
潭江茶-谭键聪/第二代潭江茶/文件整合/大带轮（20齿）22.SLDPRT
11.9 x 11.9 x 10.0 mm
