lgc-robotics/end_effector_project/英红九号-何子健/第二代末端执行器20261014/打印件/固定夹.SLDPRT

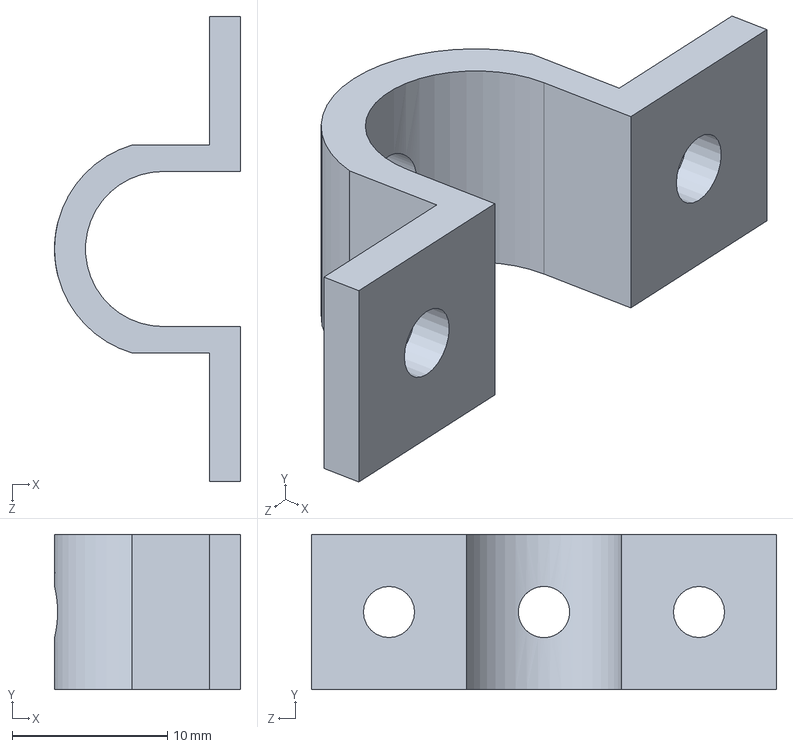
[picture p79: CAD file, 2026-10-14]
英红九号-何子健/第二代末端执行器20261014/打印件/固定夹.SLDPRT
12.0 x 10.0 x 30.0 mm
