lgc-robotics/end_effector_project/英红九号-何子健/第二代末端执行器20261014/购买件/C型弹性挡圈-轴用 DQA[DQA-10].STEP

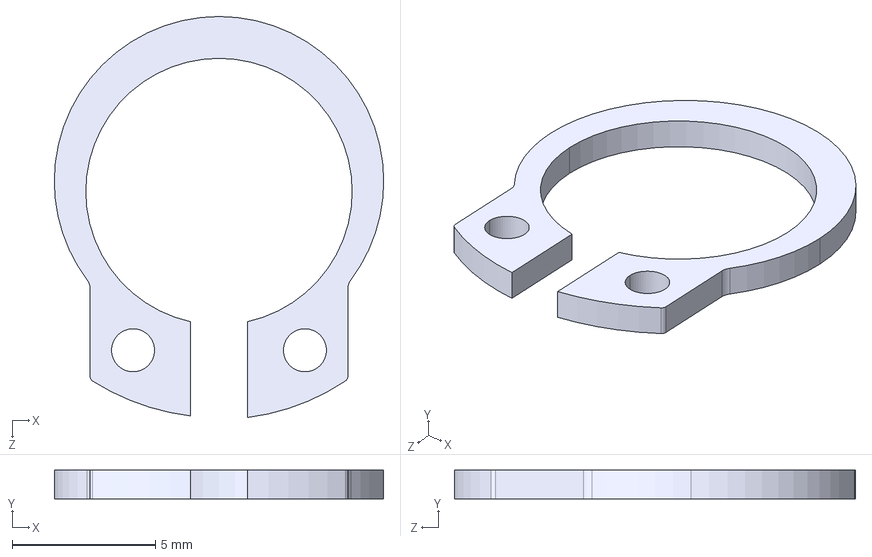
[picture p80: CAD file, 2026-10-14]
英红九号-何子健/第二代末端执行器20261014/购买件/C型弹性挡圈-轴用 DQA[DQA-10].STEP
11.5 x 1.00 x 14.0 mm
