lgc-robotics/end_effector_project/英红九号-何子健/第二代末端执行器20261014/零件STEP/轴承（8x16x4）.STEP

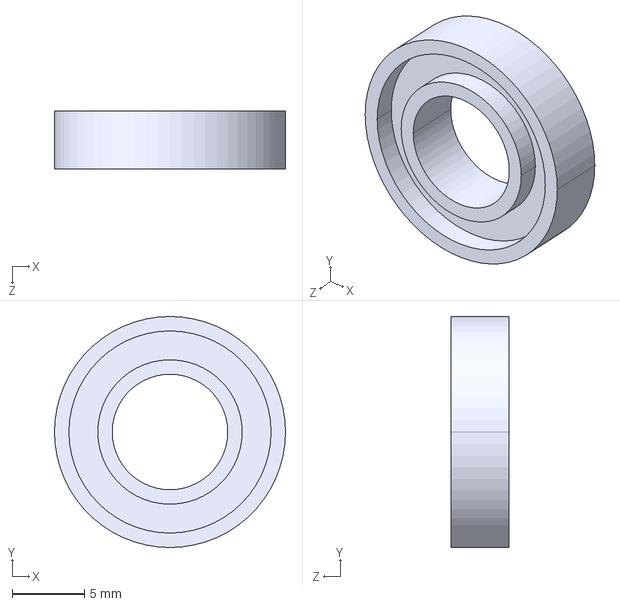
[picture p81: CAD file, 2026-10-14]
英红九号-何子健/第二代末端执行器20261014/零件STEP/轴承（8x16x4）.STEP
16.0 x 16.0 x 4.00 mm
