lgc-robotics/end_effector_project/英红九号-郑晓鑫/打印/最新版/外壳.STL

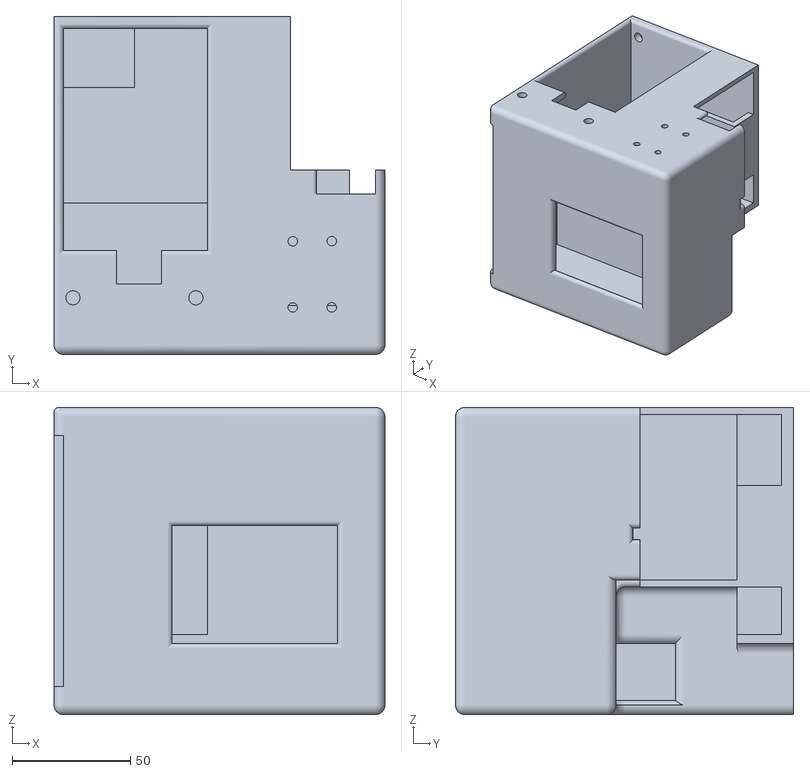
[picture p82: CAD file, 2026-08-05]
英红九号-郑晓鑫/打印/最新版/外壳.STL
140.0 x 143.0 x 130.0
