lgc-robotics/end_effector_project/夹剪复合末端执行器-谭键聪/零件/舵盘.SLDPRT

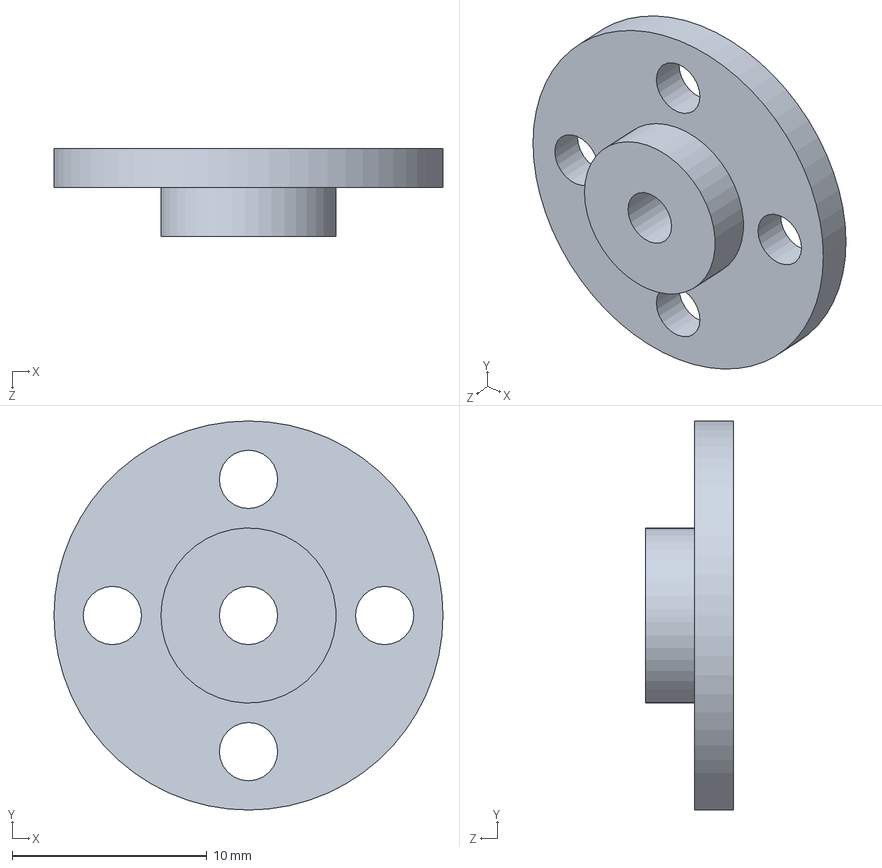
[picture p84: CAD file, 2026-08-05]
夹剪复合末端执行器-谭键聪/零件/舵盘.SLDPRT
20.0 x 20.0 x 4.50 mm
