lgc-robotics/end_effector_project/潭江茶-谭键聪/第一代谭江茶/加工件/step/滑块底座.STEP

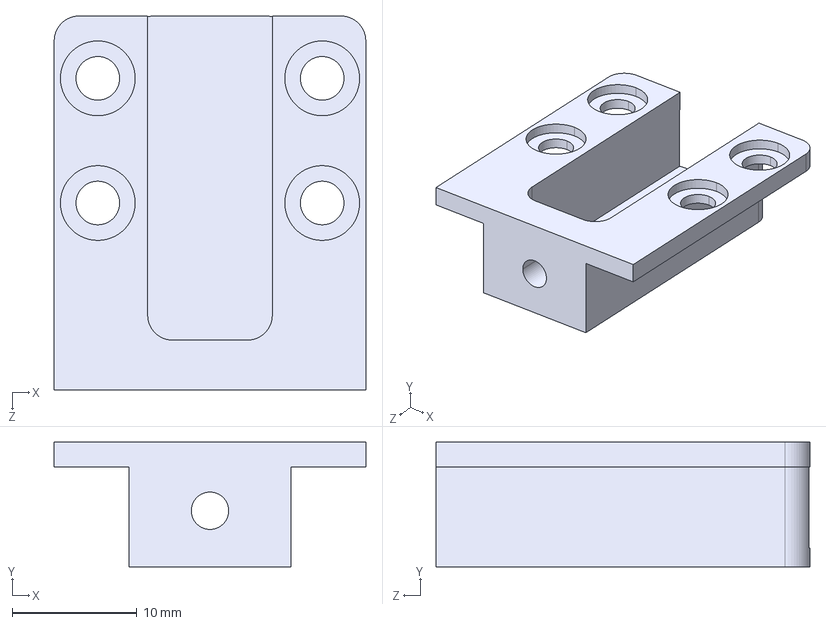
[picture p85: CAD file, 2026-08-05]
潭江茶-谭键聪/第一代谭江茶/加工件/step/滑块底座.STEP
25.0 x 10.0 x 30.0 mm
