lgc-robotics/end_effector_project/潭江茶-谭键聪/第一代谭江茶/打印件/收集盒1.SLDPRT

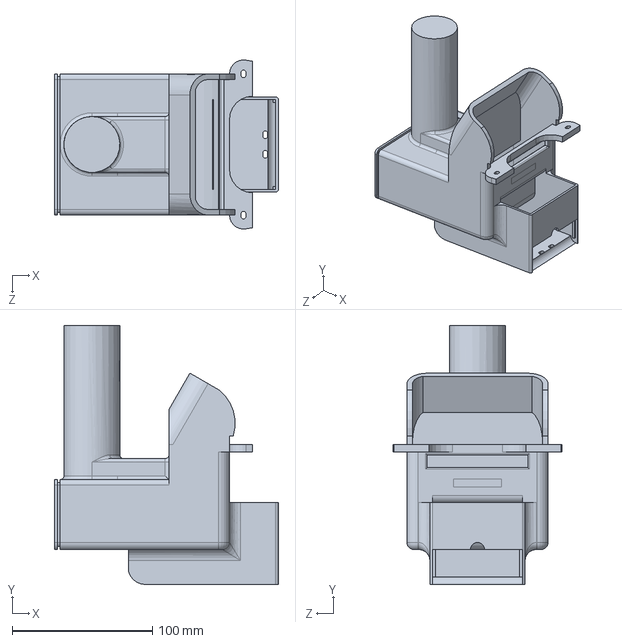
[picture p86: CAD file, 2026-08-05]
潭江茶-谭键聪/第一代谭江茶/打印件/收集盒1.SLDPRT
160.0 x 185.0 x 120.8 mm
