lgc-robotics/end_effector_project/潭江茶-谭键聪/第一代谭江茶/打印件/新建文件夹/收集盒1.STEP

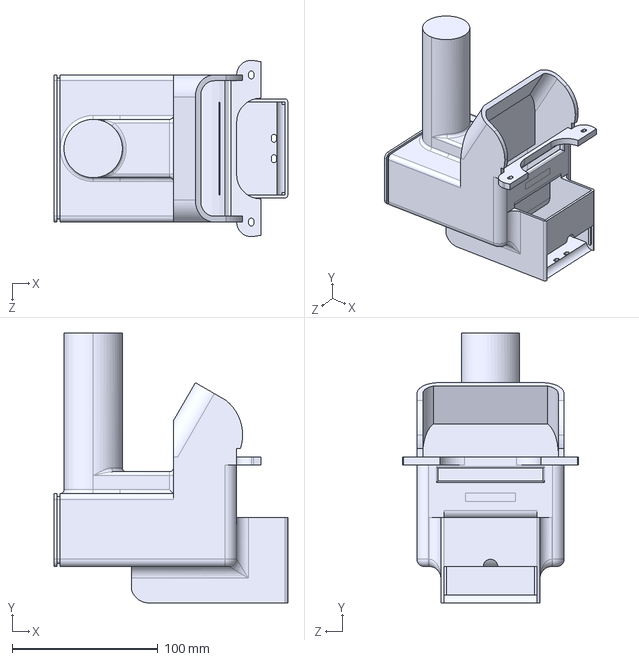
[picture p87: CAD file, 2026-08-05]
潭江茶-谭键聪/第一代谭江茶/打印件/新建文件夹/收集盒1.STEP
160.0 x 185.0 x 120.8 mm
