lgc-robotics/end_effector_project/潭江茶-谭键聪/第一代谭江茶/购买件/大轴承.SLDPRT

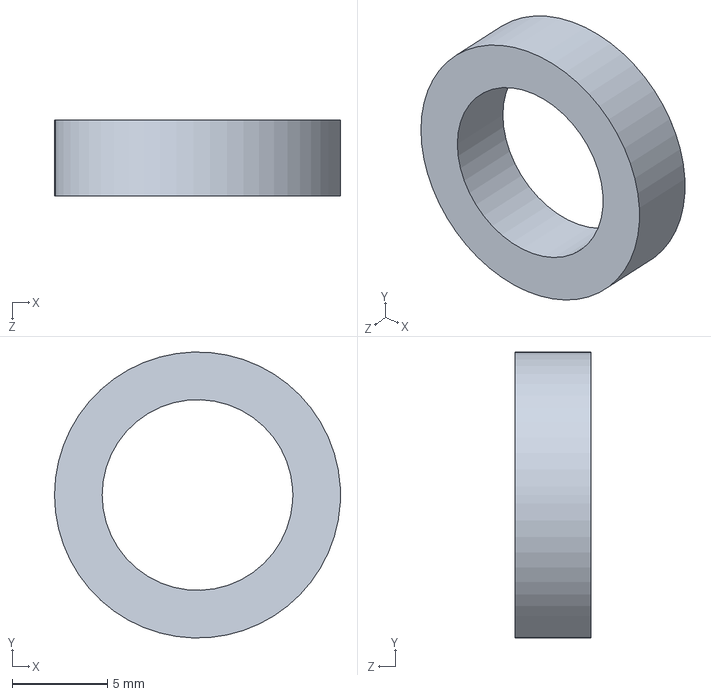
[picture p88: CAD file, 2026-08-05]
潭江茶-谭键聪/第一代谭江茶/购买件/大轴承.SLDPRT
15.0 x 15.0 x 4.00 mm
