lgc-robotics/end_effector_project/潭江茶-谭键聪/第二代潭江茶/文件整合/step/底板后.STEP

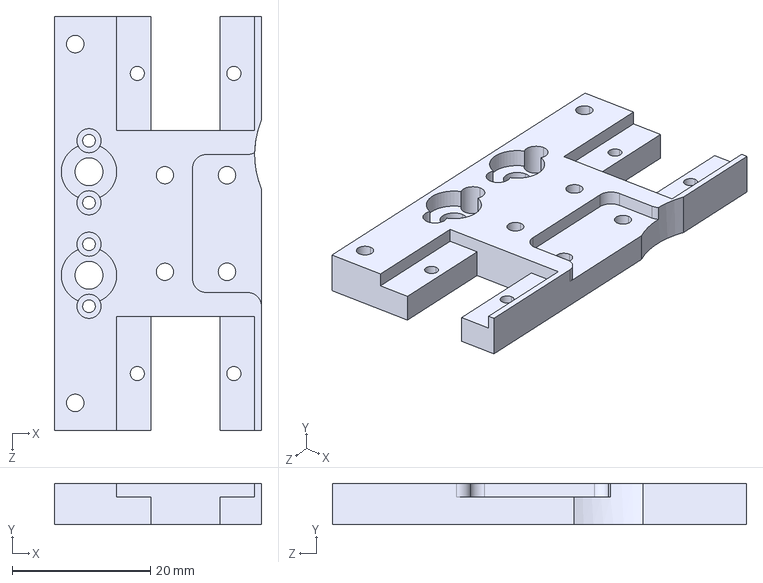
[picture p89: CAD file, 2026-08-05]
潭江茶-谭键聪/第二代潭江茶/文件整合/step/底板后.STEP
30.0 x 6.00 x 60.0 mm
