lgc-robotics/end_effector_project/潭江茶-谭键聪/第二代潭江茶/文件整合/齿轮.SLDPRT

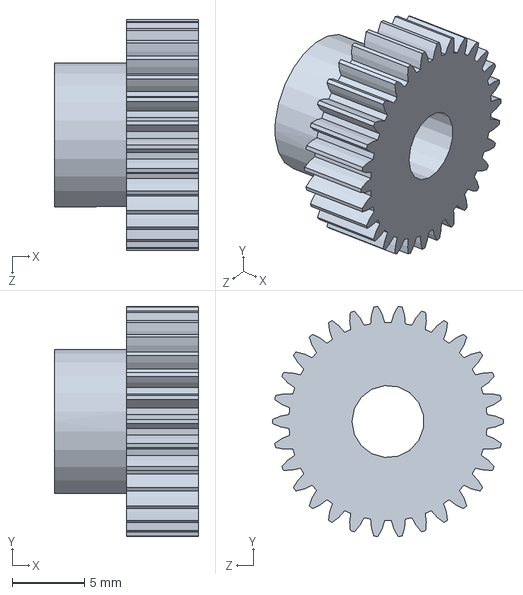
[picture p90: CAD file, 2026-08-05]
潭江茶-谭键聪/第二代潭江茶/文件整合/齿轮.SLDPRT
10.0 x 15.9 x 16.0 mm
