lgc-robotics/end_effector_project/英红九号-何子健/第二代末端执行器20261014/加工件/新刀片.SLDPRT

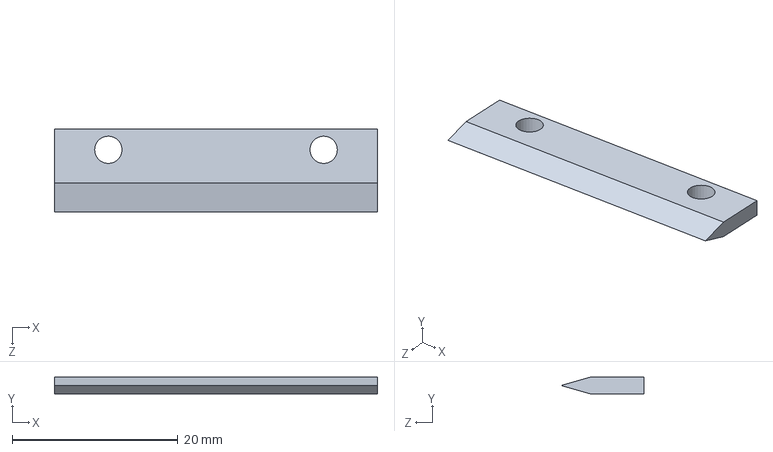
[picture p91: CAD file, 2026-10-14]
英红九号-何子健/第二代末端执行器20261014/加工件/新刀片.SLDPRT
39.0 x 2.00 x 10.0 mm
