lgc-robotics/end_effector_project/英红九号-何子健/第二代末端执行器20261014/打印件/轴盘.SLDPRT

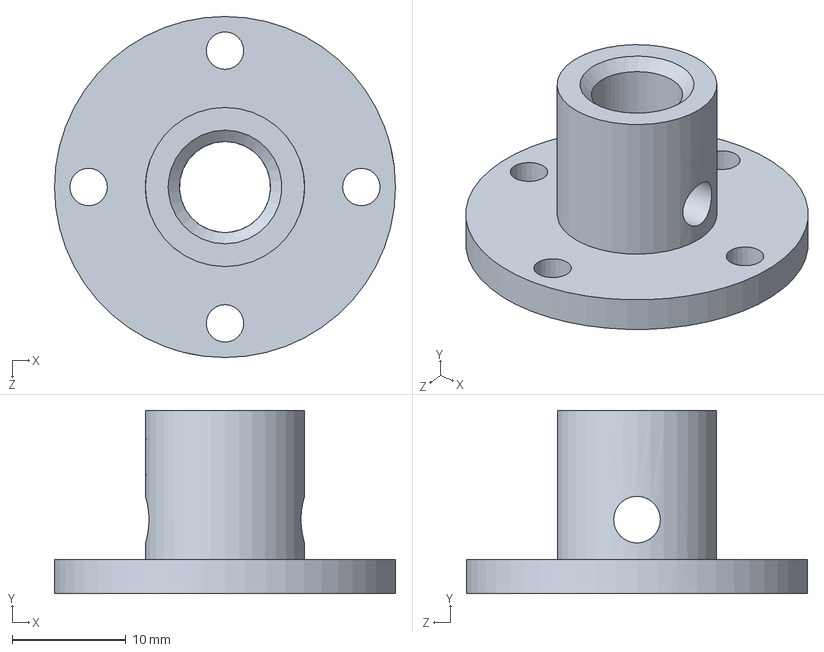
[picture p92: CAD file, 2026-10-14]
英红九号-何子健/第二代末端执行器20261014/打印件/轴盘.SLDPRT
30.0 x 16.1 x 30.0 mm
