lgc-robotics/end_effector_project/英红九号-郑晓鑫/step/铝合金/底座（T）.STEP

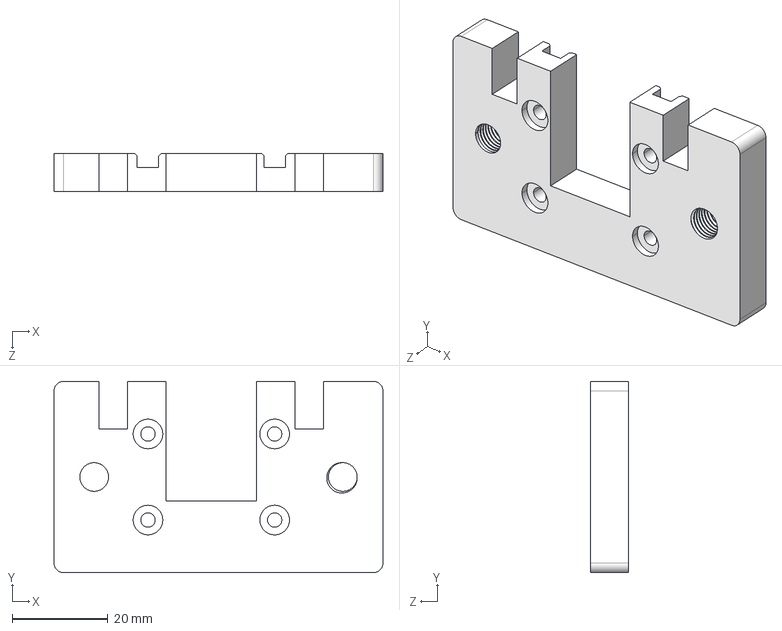
[picture p93: CAD file, 2026-08-05]
英红九号-郑晓鑫/step/铝合金/底座（T）.STEP
68.8 x 40.0 x 8.00 mm
