lgc-robotics/end_effector_project/英红九号-郑晓鑫/下刀板.SLDPRT

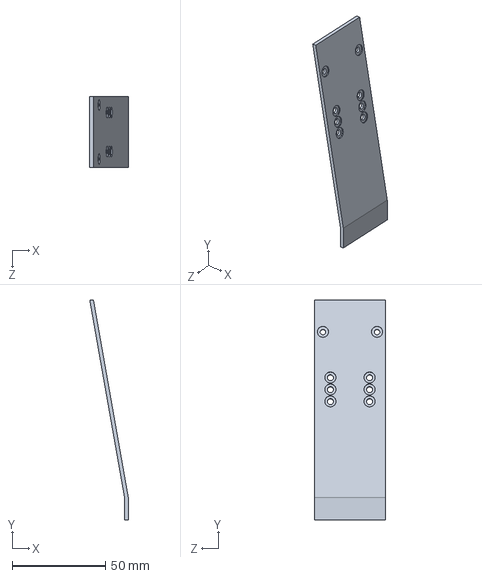
[picture p94: CAD file, 2026-08-05]
英红九号-郑晓鑫/下刀板.SLDPRT
20.7 x 117.9 x 38.0 mm
