lgc-robotics/end_effector_project/英红九号-郑晓鑫/购买件/卡簧.SLDPRT

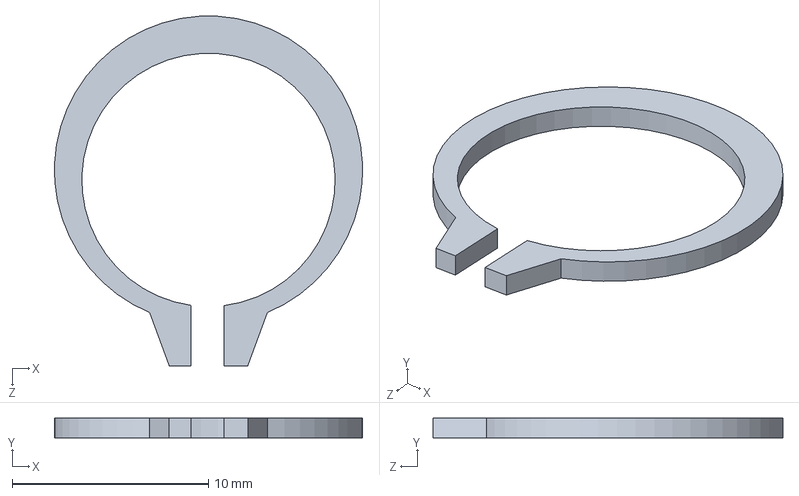
[picture p95: CAD file, 2026-08-05]
英红九号-郑晓鑫/购买件/卡簧.SLDPRT
15.7 x 1.00 x 17.8 mm
