lgc-robotics/end_effector_project/夹剪复合末端执行器-谭键聪/零件/舵机.SLDPRT

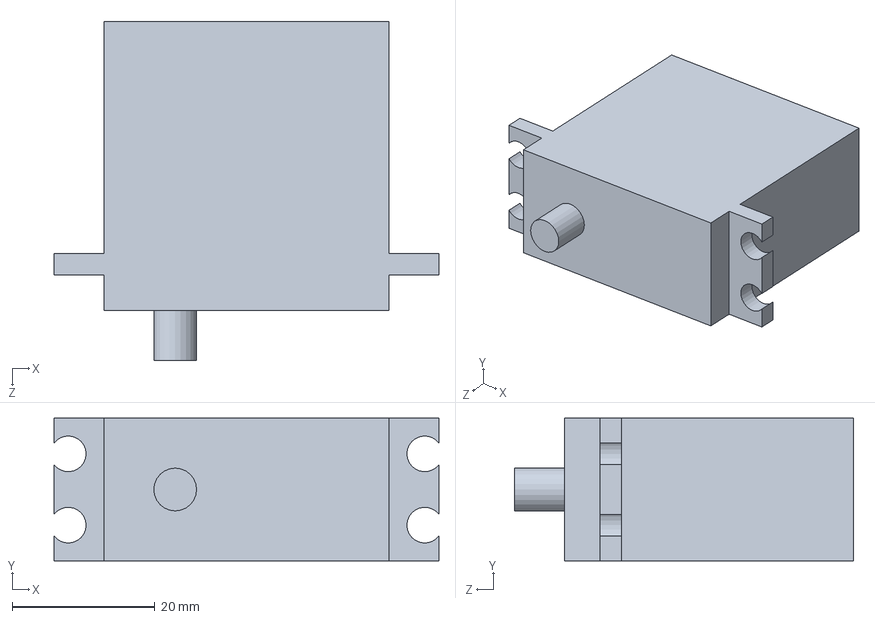
[picture p96: CAD file, 2026-08-05]
夹剪复合末端执行器-谭键聪/零件/舵机.SLDPRT
54.0 x 20.0 x 47.5 mm
