lgc-robotics/end_effector_project/潭江茶-谭键聪/第一代谭江茶/加工件/step/齿轮.STEP

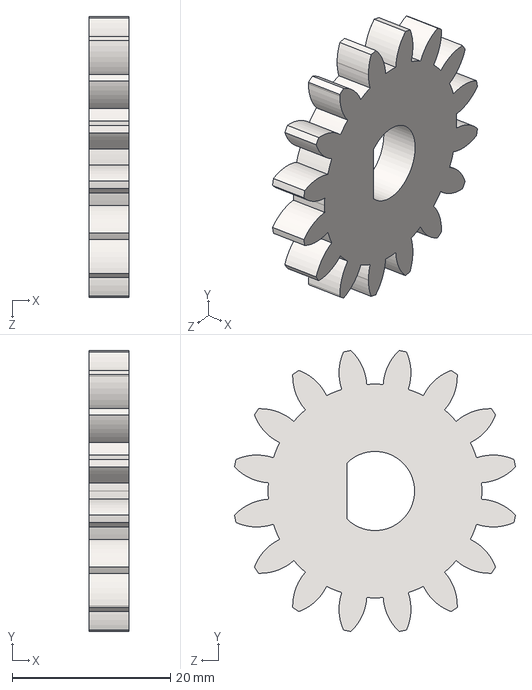
[picture p97: CAD file, 2026-08-05]
潭江茶-谭键聪/第一代谭江茶/加工件/step/齿轮.STEP
5.00 x 35.5 x 35.5 mm
