lgc-robotics/end_effector_project/潭江茶-谭键聪/第一代谭江茶/购买件/8mm轴承.SLDPRT

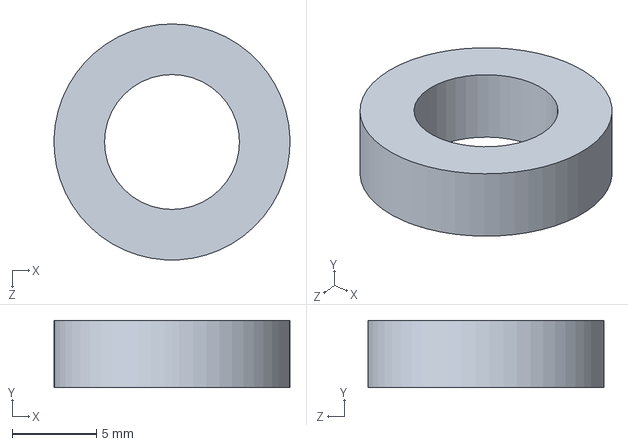
[picture p98: CAD file, 2026-08-05]
潭江茶-谭键聪/第一代谭江茶/购买件/8mm轴承.SLDPRT
14.0 x 4.00 x 14.0 mm
