lgc-robotics/end_effector_project/潭江茶-谭键聪/第二代潭江茶/文件整合/刀轮.SLDPRT

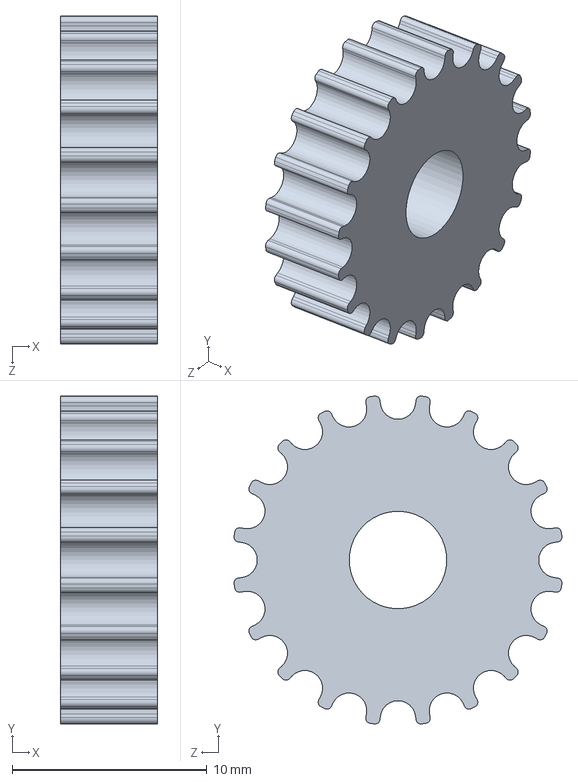
[picture p99: CAD file, 2026-08-05]
潭江茶-谭键聪/第二代潭江茶/文件整合/刀轮.SLDPRT
5.00 x 16.8 x 16.8 mm
