lgc-robotics/end_effector_project/英红九号-何子健/第二代末端执行器20261014/加工件/下鄂.SLDPRT

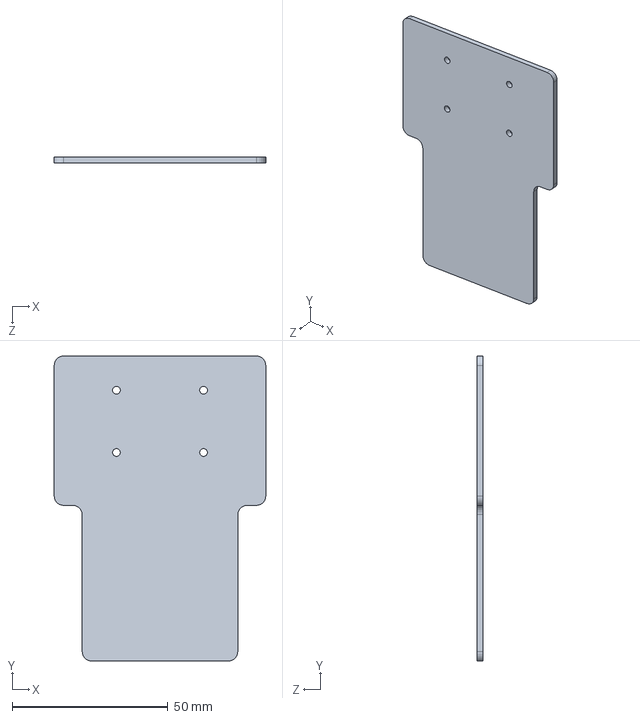
[picture p100: CAD file, 2026-10-14]
英红九号-何子健/第二代末端执行器20261014/加工件/下鄂.SLDPRT
68.0 x 98.0 x 2.00 mm
