lgc-robotics/end_effector_project/英红九号-何子健/第二代末端执行器20261014/打印件/收集下板.SLDPRT

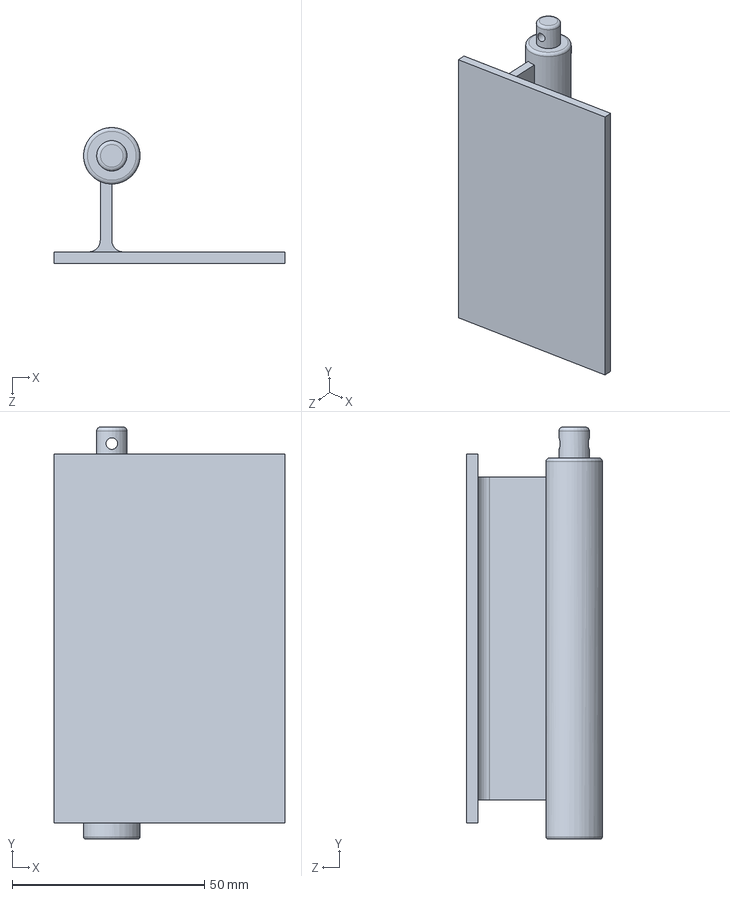
[picture p101: CAD file, 2026-10-14]
英红九号-何子健/第二代末端执行器20261014/打印件/收集下板.SLDPRT
60.0 x 107.1 x 35.3 mm
