lgc-robotics/end_effector_project/英红九号-何子健/第二代末端执行器20261014/购买件/轴承（6x10x3）.SLDPRT

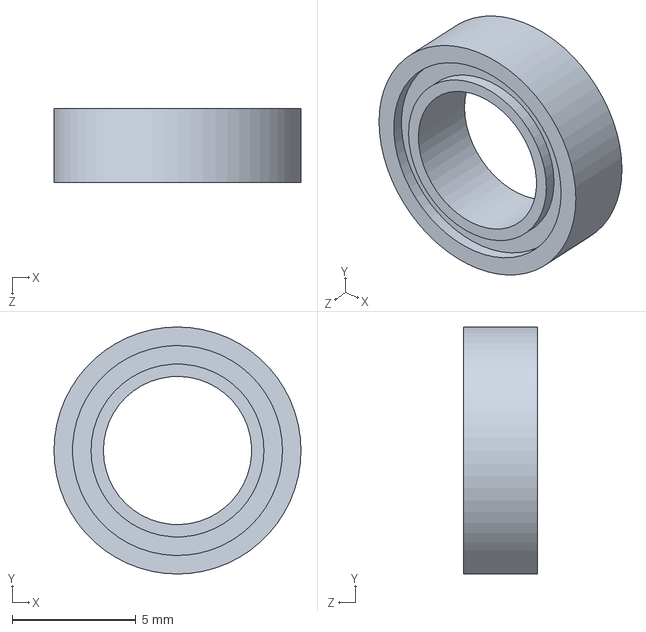
[picture p102: CAD file, 2026-10-14]
英红九号-何子健/第二代末端执行器20261014/购买件/轴承（6x10x3）.SLDPRT
10.0 x 10.0 x 3.00 mm
