lgc-robotics/end_effector_project/英红九号-何子健/第二代末端执行器20261014/零件STEP/舵机主体.STEP

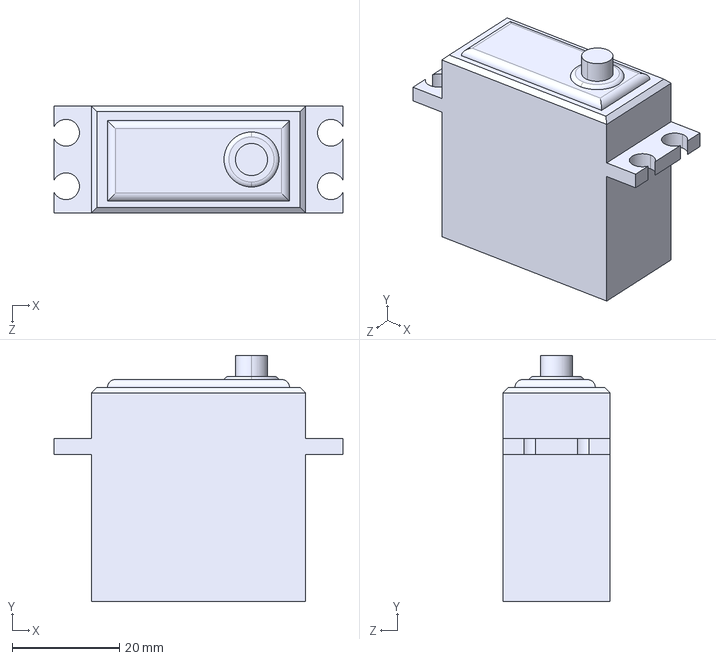
[picture p103: CAD file, 2026-10-14]
英红九号-何子健/第二代末端执行器20261014/零件STEP/舵机主体.STEP
54.0 x 46.0 x 20.0 mm
