lgc-robotics/end_effector_project/英红九号-郑晓鑫/step/铝合金/挡杆.STEP

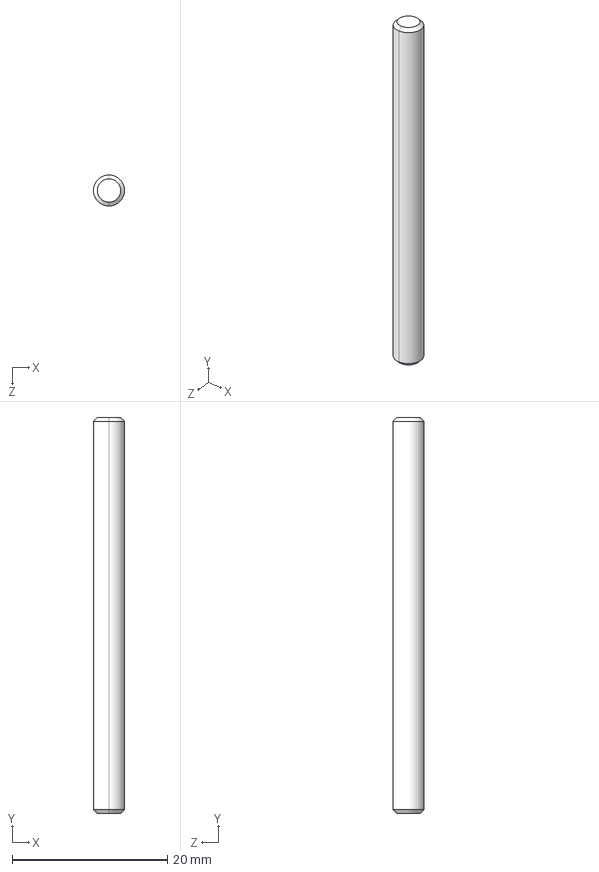
[picture p104: CAD file, 2026-08-05]
英红九号-郑晓鑫/step/铝合金/挡杆.STEP
4.00 x 51.0 x 4.00 mm
