lgc-robotics/end_effector_project/英红九号-郑晓鑫/打印/上刀座.SLDPRT

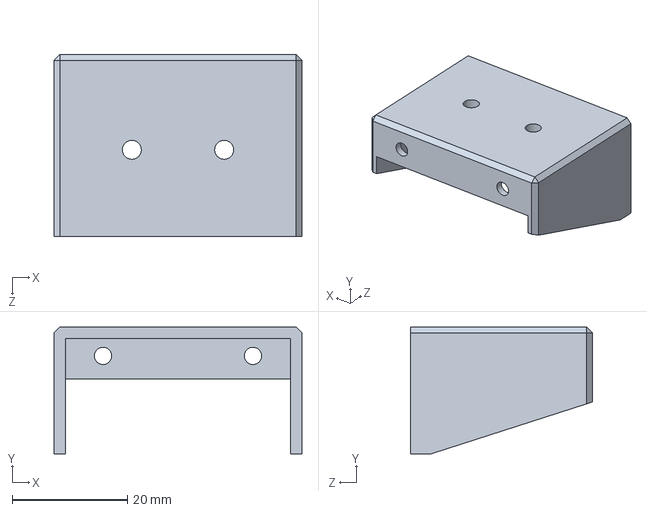
[picture p105: CAD file, 2026-08-05]
英红九号-郑晓鑫/打印/上刀座.SLDPRT
43.0 x 22.0 x 31.5 mm
