lgc-robotics/end_effector_project/夹剪复合末端执行器-谭键聪/零件/m5防松螺母.SLDPRT

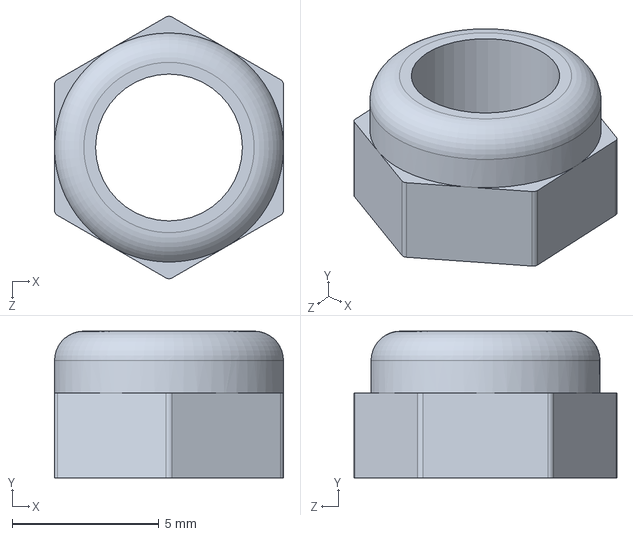
[picture p106: CAD file, 2026-08-05]
夹剪复合末端执行器-谭键聪/零件/m5防松螺母.SLDPRT
7.80 x 5.00 x 8.94 mm
