lgc-robotics/end_effector_project/夹剪复合末端执行器-谭键聪/零件/step/零件4^剪切部分装配体.STEP

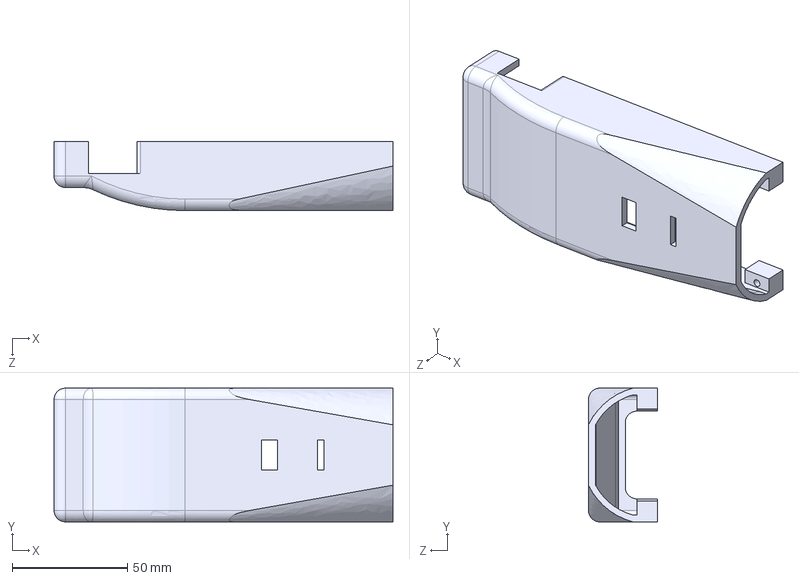
[picture p107: CAD file, 2026-08-05]
夹剪复合末端执行器-谭键聪/零件/step/零件4^剪切部分装配体.STEP
147.0 x 58.0 x 30.0 mm
