lgc-robotics/end_effector_project/潭江茶-谭键聪/第一代谭江茶/加工件/step/22齿轴.STEP

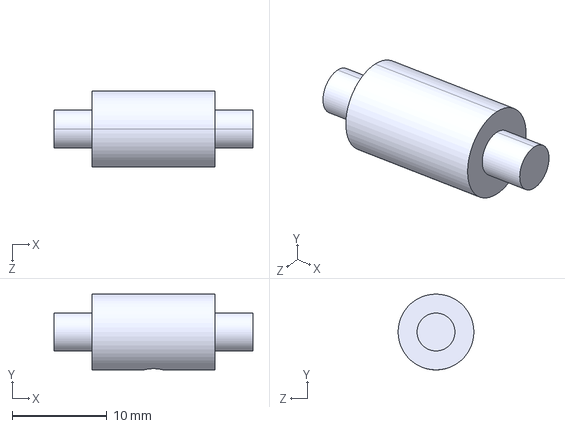
[picture p108: CAD file, 2026-08-05]
潭江茶-谭键聪/第一代谭江茶/加工件/step/22齿轴.STEP
21.0 x 8.00 x 8.00 mm
