lgc-robotics/end_effector_project/潭江茶-谭键聪/第一代谭江茶/购买件/皮带.SLDPRT

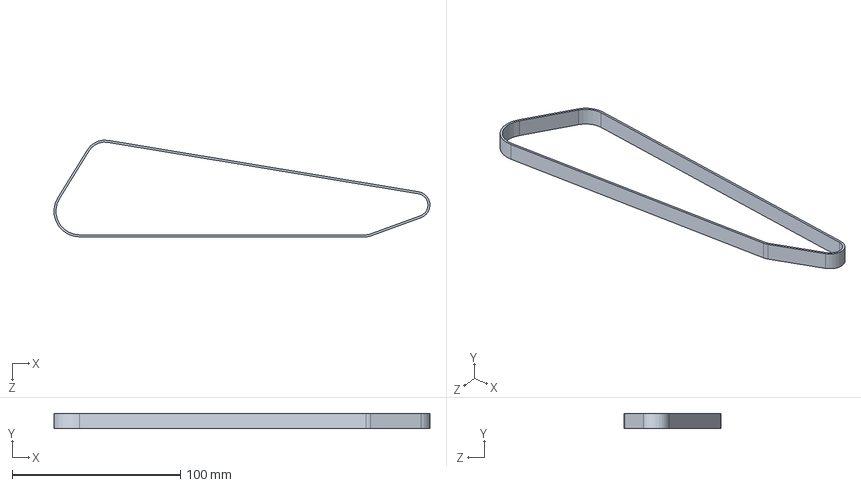
[picture p109: CAD file, 2026-08-05]
潭江茶-谭键聪/第一代谭江茶/购买件/皮带.SLDPRT
223.2 x 9.00 x 57.4 mm
