lgc-robotics/end_effector_project/潭江茶-谭键聪/第二代潭江茶/文件整合/step/刀片改.STEP

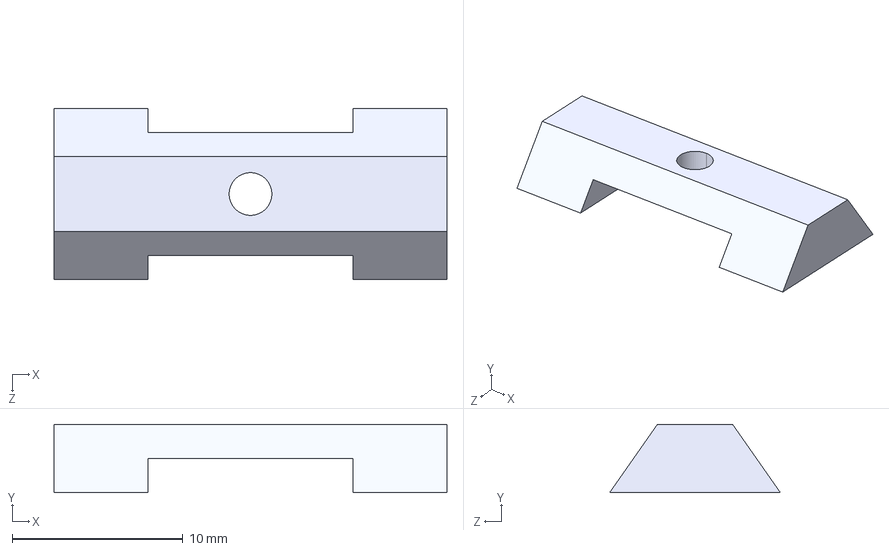
[picture p110: CAD file, 2026-08-05]
潭江茶-谭键聪/第二代潭江茶/文件整合/step/刀片改.STEP
23.0 x 4.00 x 10.0 mm
