lgc-robotics/end_effector_project/英红九号-何子健/第二代末端执行器20261014/加工件/执行舵机固定板.SLDPRT

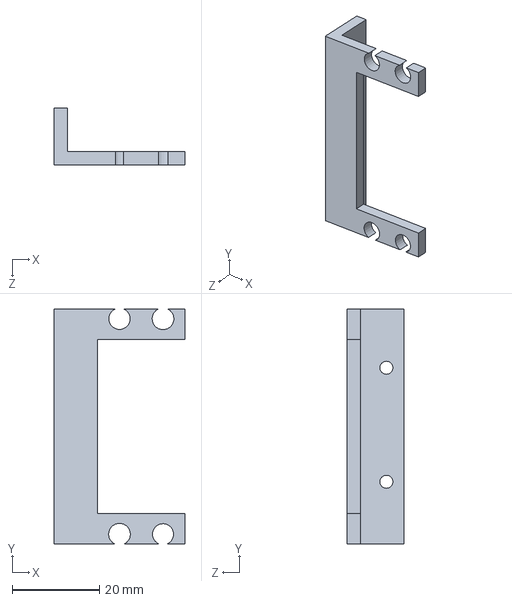
[picture p111: CAD file, 2026-10-14]
英红九号-何子健/第二代末端执行器20261014/加工件/执行舵机固定板.SLDPRT
30.0 x 54.0 x 13.0 mm
