lgc-robotics/end_effector_project/英红九号-何子健/第二代末端执行器20261014/打印件/外壳_hzj.SLDPRT

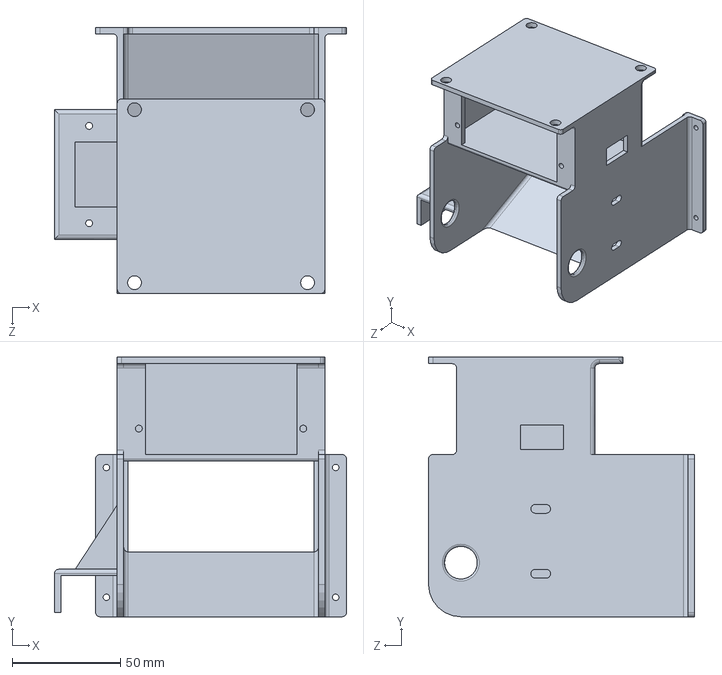
[picture p112: CAD file, 2026-10-14]
英红九号-何子健/第二代末端执行器20261014/打印件/外壳_hzj.SLDPRT
135.0 x 120.0 x 123.0 mm
