lgc-robotics/end_effector_project/英红九号-何子健/第二代末端执行器20261014/零件STEP/左轴承座.STEP

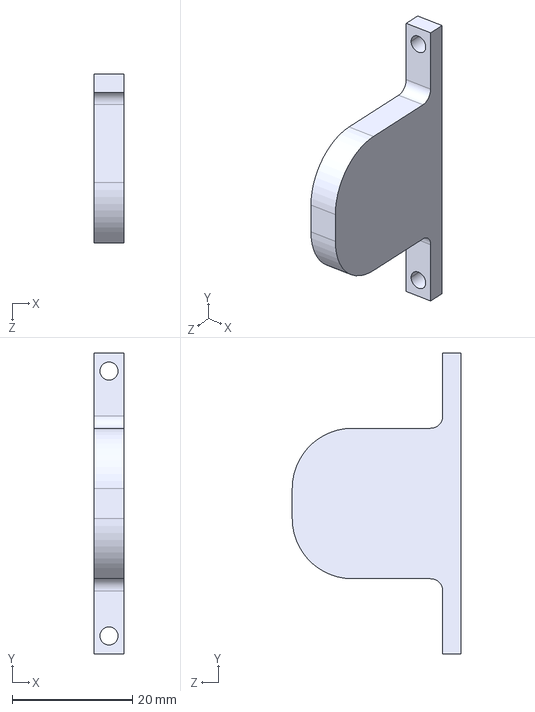
[picture p113: CAD file, 2026-10-14]
英红九号-何子健/第二代末端执行器20261014/零件STEP/左轴承座.STEP
5.00 x 50.0 x 28.0 mm
