lgc-robotics/end_effector_project/英红九号-郑晓鑫/step/铝合金/下刀板L型.STEP

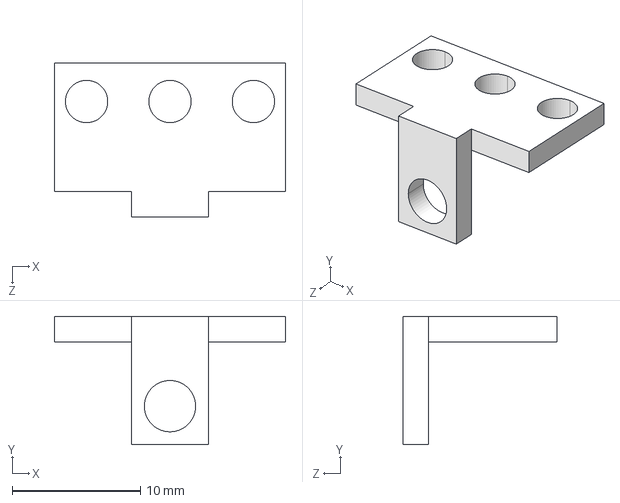
[picture p114: CAD file, 2026-08-05]
英红九号-郑晓鑫/step/铝合金/下刀板L型.STEP
18.0 x 10.0 x 12.0 mm
