lgc-robotics/end_effector_project/英红九号-郑晓鑫/购买件/十字臂.SLDPRT

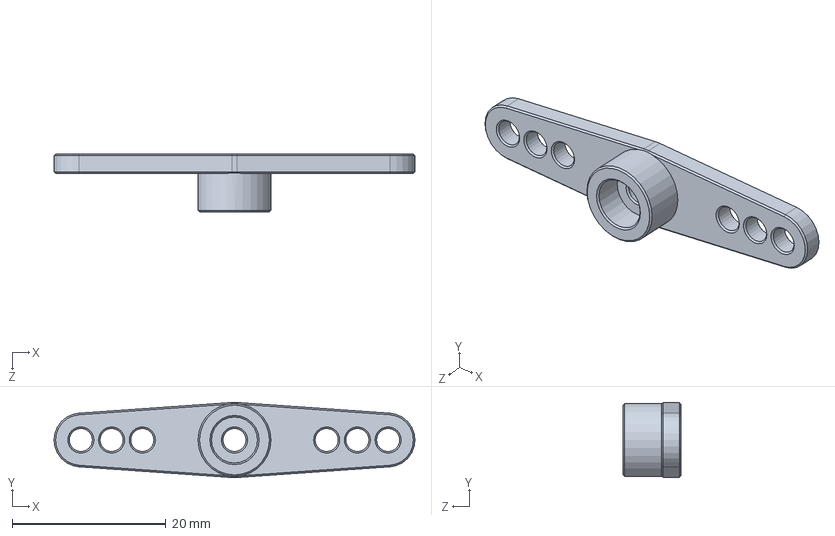
[picture p115: CAD file, 2026-08-05]
英红九号-郑晓鑫/购买件/十字臂.SLDPRT
47.0 x 9.78 x 7.50 mm
