lgc-robotics/end_effector_project/夹剪复合末端执行器-谭键聪/零件/step/20度刀.STEP

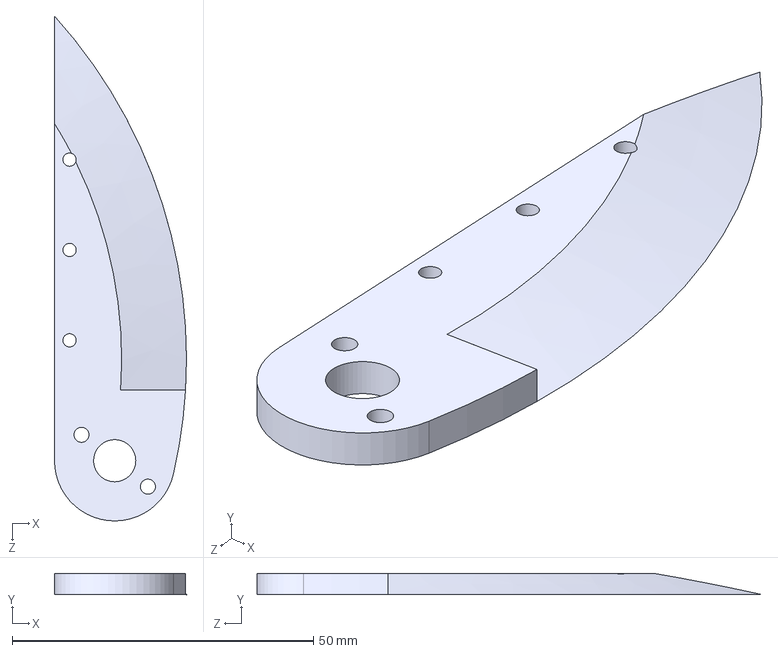
[picture p116: CAD file, 2026-08-05]
夹剪复合末端执行器-谭键聪/零件/step/20度刀.STEP
21.9 x 3.50 x 83.8 mm
