lgc-robotics/end_effector_project/夹剪复合末端执行器-谭键聪/零件/主动齿轮.SLDPRT

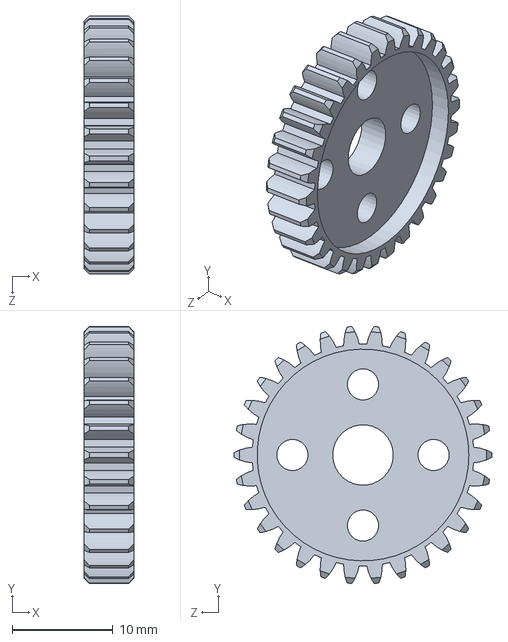
[picture p117: CAD file, 2026-08-05]
夹剪复合末端执行器-谭键聪/零件/主动齿轮.SLDPRT
5.00 x 25.5 x 25.6 mm
