lgc-robotics/end_effector_project/潭江茶-谭键聪/第一代谭江茶/购买件/15齿无挡边.SLDPRT

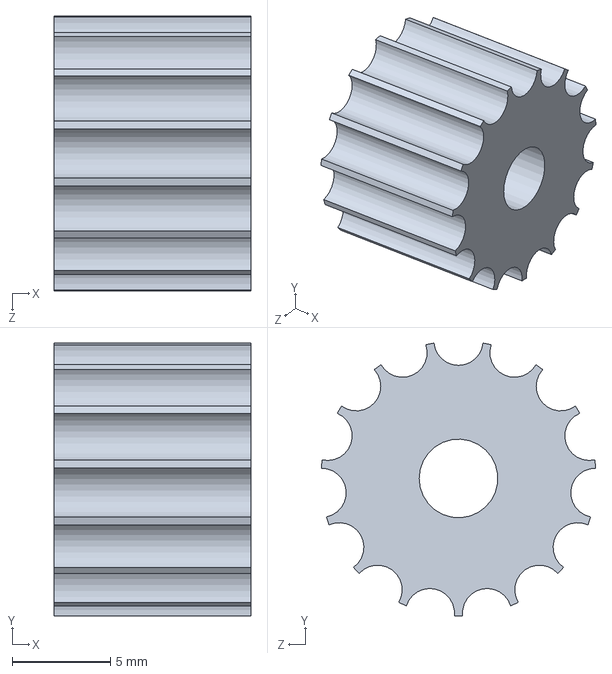
[picture p118: CAD file, 2026-08-05]
潭江茶-谭键聪/第一代谭江茶/购买件/15齿无挡边.SLDPRT
10.0 x 13.9 x 14.0 mm
