lgc-robotics/end_effector_project/英红九号-郑晓鑫/step/铝合金/刀架盖.STEP

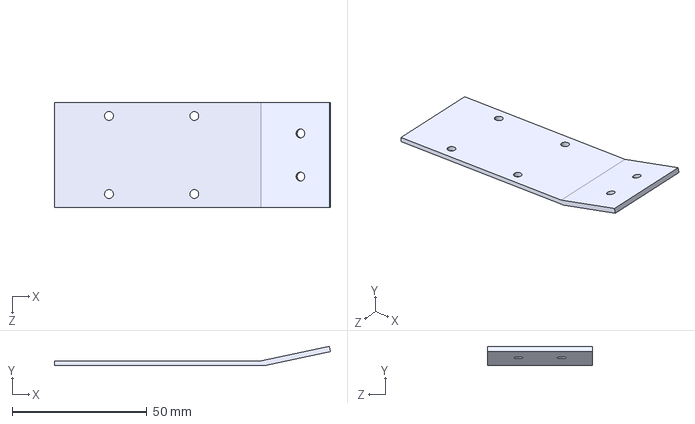
[picture p120: CAD file, 2026-08-05]
英红九号-郑晓鑫/step/铝合金/刀架盖.STEP
102.5 x 7.19 x 39.0 mm
