lgc-robotics/end_effector_project/英红九号-郑晓鑫/购买件/销钉φ4-9.SLDPRT

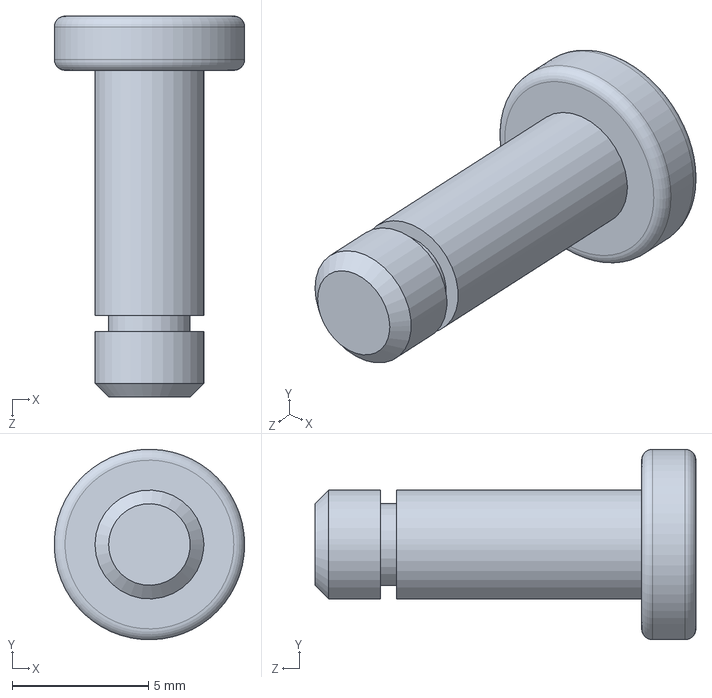
[picture p121: CAD file, 2026-08-05]
英红九号-郑晓鑫/购买件/销钉φ4-9.SLDPRT
6.99 x 7.00 x 14.0 mm
