lgc-robotics/end_effector_project/夹剪复合末端执行器-谭键聪/零件/从动齿轮.SLDPRT

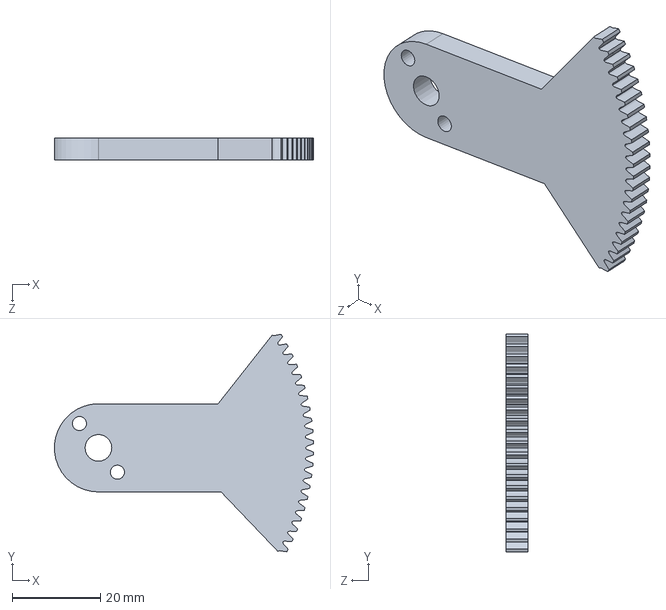
[picture p122: CAD file, 2026-08-05]
夹剪复合末端执行器-谭键聪/零件/从动齿轮.SLDPRT
58.8 x 49.3 x 5.00 mm
