lgc-robotics/end_effector_project/潭江茶-谭键聪/第一代谭江茶/加工件/step/主动轴.STEP

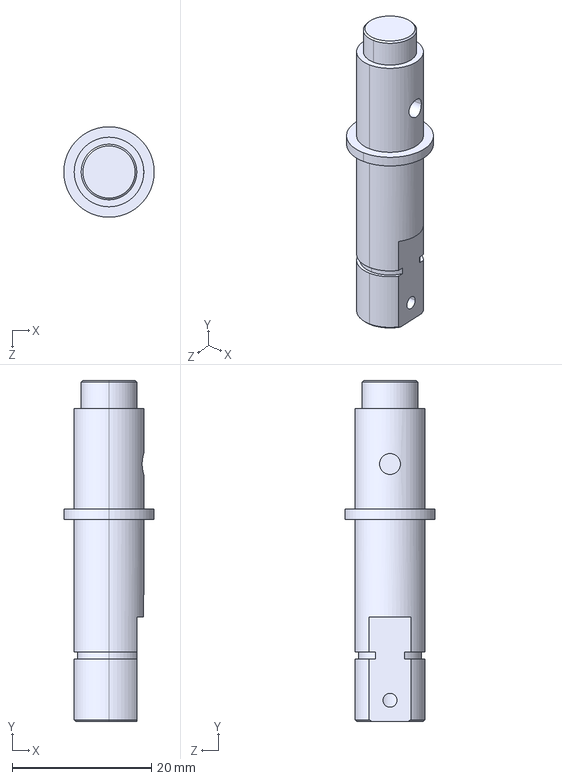
[picture p123: CAD file, 2026-08-05]
潭江茶-谭键聪/第一代谭江茶/加工件/step/主动轴.STEP
13.0 x 49.0 x 13.0 mm
