lgc-robotics/end_effector_project/潭江茶-谭键聪/第一代谭江茶/购买件/电机.SLDPRT

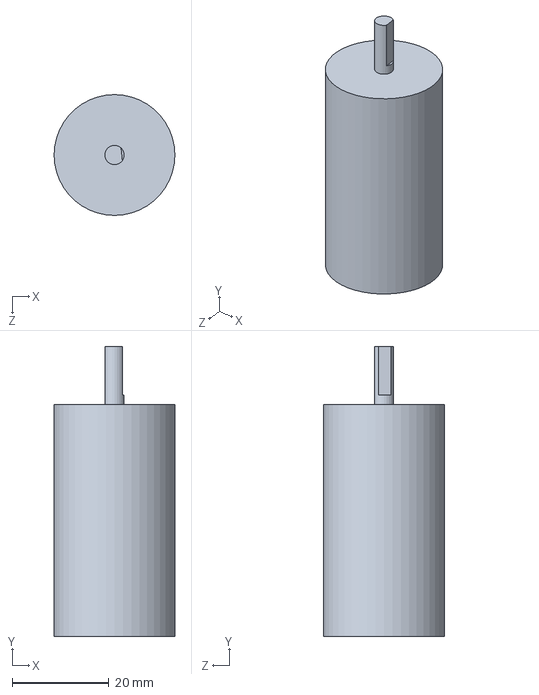
[picture p124: CAD file, 2026-08-05]
潭江茶-谭键聪/第一代谭江茶/购买件/电机.SLDPRT
25.0 x 60.0 x 25.0 mm
