lgc-robotics/end_effector_project/潭江茶-谭键聪/第二代潭江茶/文件整合/step/底板前.STEP

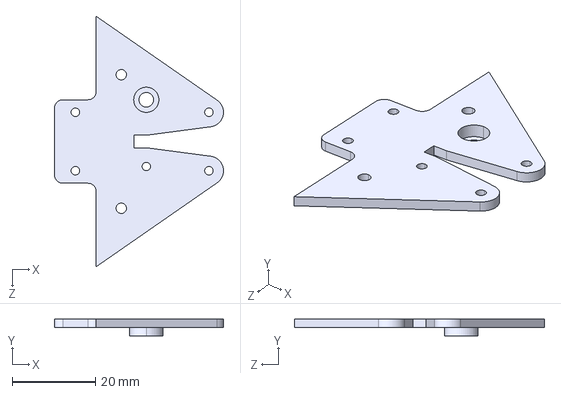
[picture p125: CAD file, 2026-08-05]
潭江茶-谭键聪/第二代潭江茶/文件整合/step/底板前.STEP
40.5 x 4.00 x 60.0 mm
