lgc-robotics/end_effector_project/英红九号-郑晓鑫/购买件/φ3-5-m2.5.SLDPRT

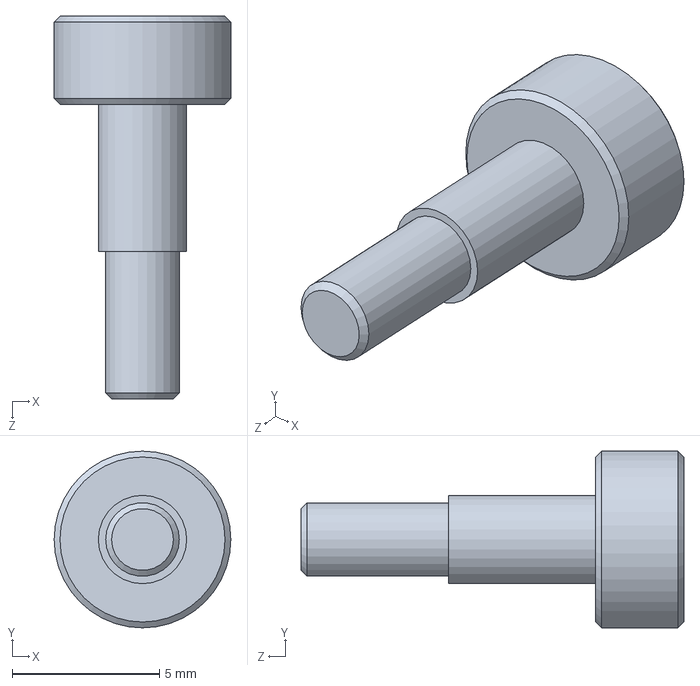
[picture p126: CAD file, 2026-08-05]
英红九号-郑晓鑫/购买件/φ3-5-m2.5.SLDPRT
6.00 x 6.00 x 13.0 mm
