lgc-robotics/end_effector_project/夹剪复合末端执行器-谭键聪/零件/轴.SLDPRT

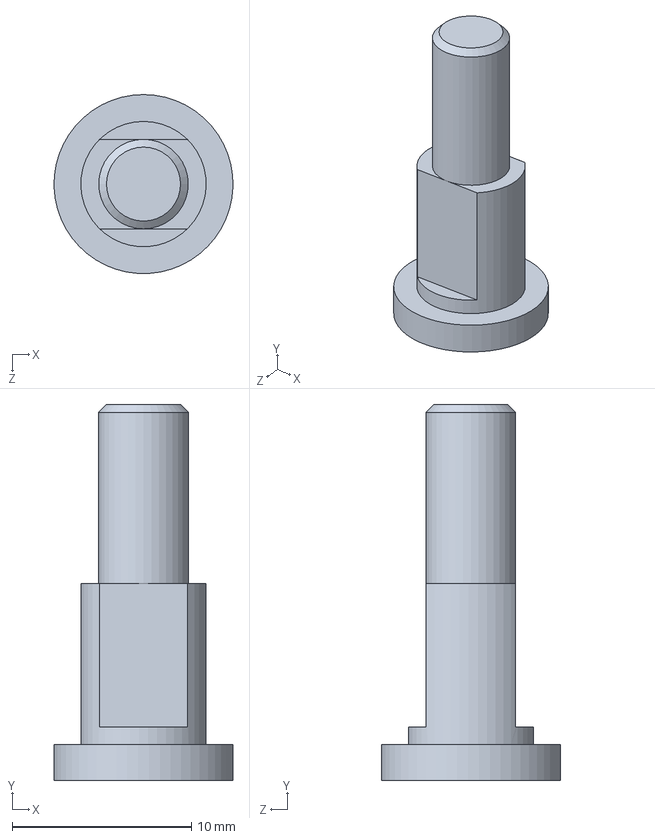
[picture p127: CAD file, 2026-08-05]
夹剪复合末端执行器-谭键聪/零件/轴.SLDPRT
10.00 x 21.0 x 9.99 mm
