lgc-robotics/end_effector_project/潭江茶-谭键聪/第一代谭江茶/加工件/step/底座前.STEP

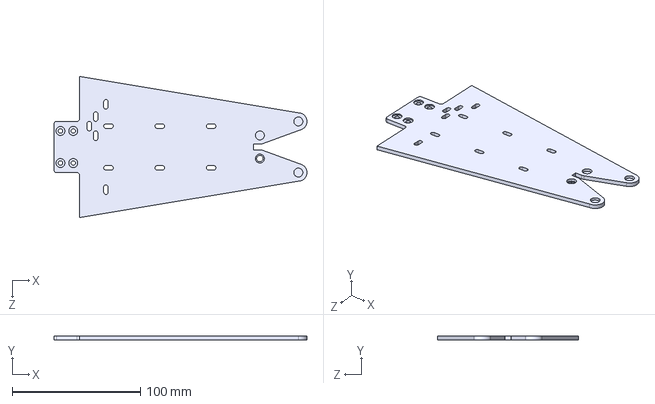
[picture p128: CAD file, 2026-08-05]
潭江茶-谭键聪/第一代谭江茶/加工件/step/底座前.STEP
197.2 x 3.00 x 110.0 mm
