lgc-robotics/end_effector_project/潭江茶-谭键聪/第一代谭江茶/购买件/小轴承.SLDPRT

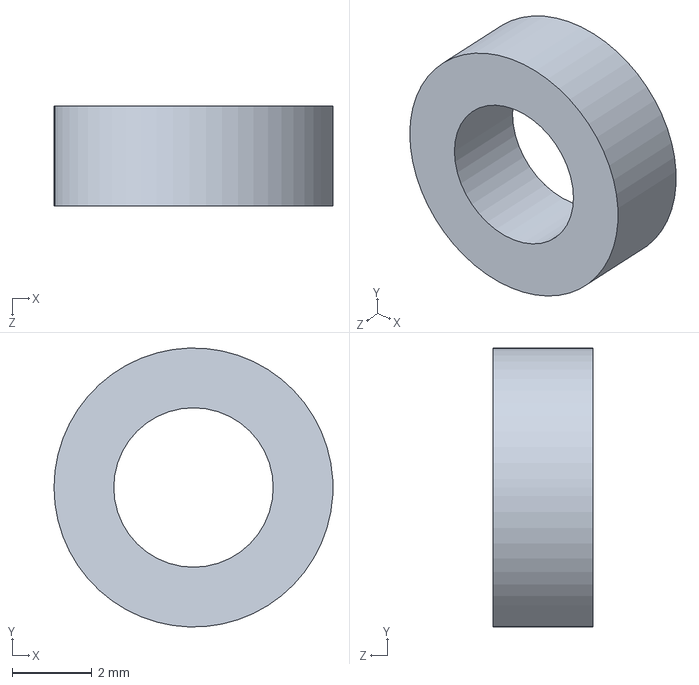
[picture p129: CAD file, 2026-08-05]
潭江茶-谭键聪/第一代谭江茶/购买件/小轴承.SLDPRT
7.00 x 7.00 x 2.50 mm
