lgc-robotics/end_effector_project/潭江茶-谭键聪/第二代潭江茶/文件整合/箱体.stp.SLDPRT

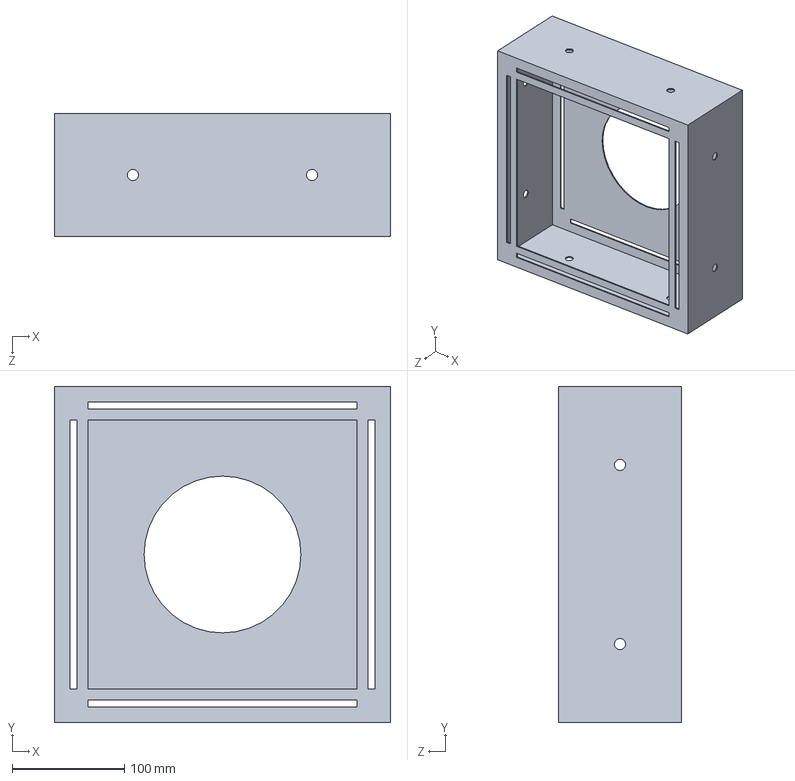
[picture p130: CAD file, 2026-08-05]
潭江茶-谭键聪/第二代潭江茶/文件整合/箱体.stp.SLDPRT
300.0 x 300.0 x 110.0 mm
