lgc-robotics/end_effector_project/英红九号-何子健/第二代末端执行器20261014/加工件/重物.SLDPRT

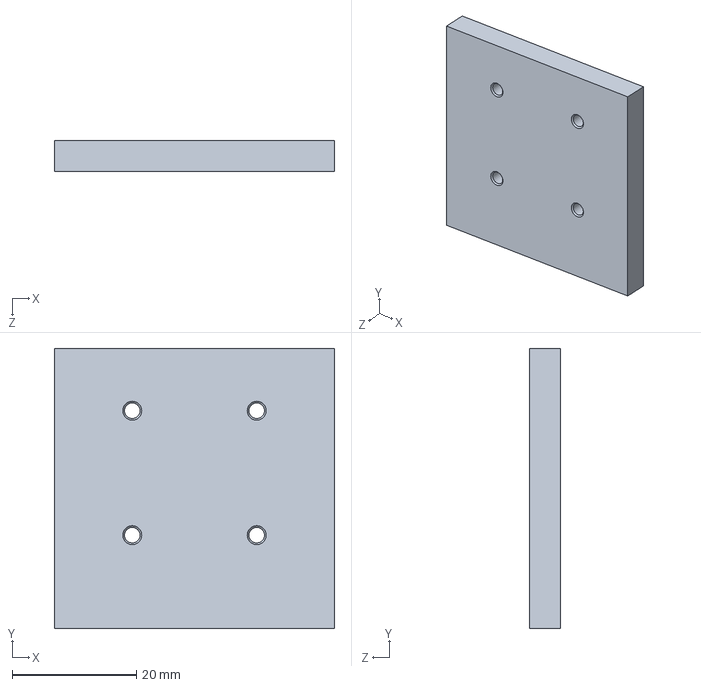
[picture p131: CAD file, 2026-10-14]
英红九号-何子健/第二代末端执行器20261014/加工件/重物.SLDPRT
45.0 x 45.0 x 5.00 mm
