lgc-robotics/end_effector_project/潭江茶-谭键聪/第二代潭江茶/文件整合/装配体.SLDASM

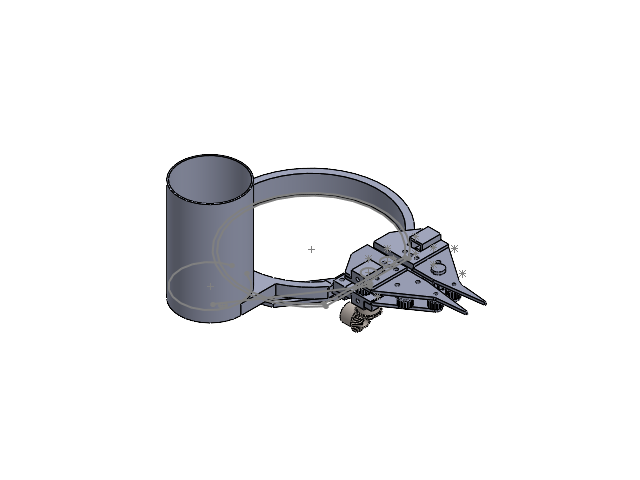
[picture p132: CAD file, 2026-08-05]
潭江茶-谭键聪/第二代潭江茶/文件整合/装配体.SLDASM
底板后
大带轮（20齿）22 x 2
带轮15齿.step x 5
滑块槽 x 4
绷紧块 x 4
上板右后
上板左后
轴
收集盒2
刀轮
上板右前1
上板左前1
底板前.step
刀片改
straight bevel pinion_gb x 2
spur gear_gb x 2
