lgc-robotics/end_effector_project/(list of files, cad)

Other CAD files:
夹剪复合末端执行器-谭键聪/文件混合/链接板.STEP
潭江茶-谭键聪/第一代谭江茶/打印件/上盖挡边1.SLDPRT
潭江茶-谭键聪/第一代谭江茶/打印件/新建文件夹/上盖挡边2.STEP
潭江茶-谭键聪/第一代谭江茶/装配体.IGS
蘑菇-姚上泉/蘑菇igs格式装配图.IGS
夹剪复合末端执行器-谭键聪/零件/装配体.STEP
潭江茶-谭键聪/第一代谭江茶/打印件/新建文件夹/上盖挡边1.STEP
潭江茶-谭键聪/第一代谭江茶/打印件/盖板.SLDPRT
英红九号-何子健/第二代末端执行器20261014/加工件/限位凸台.SLDPRT
英红九号-郑晓鑫/打印/上刀轴套.SLDPRT
英红九号-郑晓鑫/零件3.SLDPRT
英红九号-何子健/第二代末端执行器20261014/购买件/轴承（8x16x4）.SLDPRT
英红九号-何子健/第二代末端执行器20261014/零件STEP/收集舵机固定架.STEP
英红九号-郑晓鑫/打印/最新版/右.STL
英红九号-郑晓鑫/打印/零件3.SLDPRT
夹剪复合末端执行器-谭键聪/零件/step/链接板.STEP
潭江茶-谭键聪/第一代谭江茶/打印件/新收集盒1.STEP
潭江茶-谭键聪/第二代潭江茶/文件整合/step/上板左后.STEP
英红九号-郑晓鑫/上刀片.SLDPRT
英红九号-郑晓鑫/打印/最新版/左.STL
英红九号-郑晓鑫/购买件/舵机主体.SLDPRT
夹剪复合末端执行器-谭键聪/文件混合/装配体.STEP
英红九号-何子健/第二代末端执行器20261014/购买件/舵机主体.SLDPRT
英红九号-郑晓鑫/下刀板L型.SLDPRT
英红九号-郑晓鑫/打印/新抽屉.SLDPRT
英红九号-郑晓鑫/打印/最新版/封盖.STL
潭江茶-谭键聪/第一代谭江茶/加工件/step/上盖2后.STEP
潭江茶-谭键聪/第二代潭江茶/文件整合/皮带.step.SLDPRT
英红九号-何子健/第二代末端执行器20261014/加工件/右侧板.SLDPRT
英红九号-何子健/第二代末端执行器20261014/购买件/十字臂.SLDPRT
英红九号-何子健/第二代末端执行器20261014/零件STEP/新m3-50.STEP
英红九号-郑晓鑫/上刀架.SLDPRT
潭江茶-谭键聪/第二代潭江茶/文件整合/底板前.step.SLDPRT
英红九号-何子健/第二代末端执行器20261014/加工件/右轴承座.SLDPRT
英红九号-何子健/第二代末端执行器20261014/零件STEP/执行舵机固定板.STEP
英红九号-郑晓鑫/step/铝合金/T型块1.STEP
英红九号-郑晓鑫/轴盘.SLDPRT
夹剪复合末端执行器-谭键聪/图纸/后法兰.SLDDRW
夹剪复合末端执行器-谭键聪/图纸/底板(5.29).SLDDRW
夹剪复合末端执行器-谭键聪/图纸/链接板.SLDDRW
夹剪复合末端执行器-谭键聪/文件混合/20度刀.SLDPRT
夹剪复合末端执行器-谭键聪/文件混合/后法兰.SLDPRT
夹剪复合末端执行器-谭键聪/文件混合/图纸/后法兰.SLDDRW
夹剪复合末端执行器-谭键聪/文件混合/图纸/底板(5.29).SLDDRW
夹剪复合末端执行器-谭键聪/文件混合/图纸/链接板.SLDDRW
夹剪复合末端执行器-谭键聪/文件混合/底板(5.29).SLDPRT
夹剪复合末端执行器-谭键聪/文件混合/装配体.SLDASM
夹剪复合末端执行器-谭键聪/文件混合/轴.SLDPRT
夹剪复合末端执行器-谭键聪/文件混合/链接板.SLDPRT
夹剪复合末端执行器-谭键聪/文件混合/零件2_剪切部分装配体.3MF
夹剪复合末端执行器-谭键聪/文件混合/零件2_剪切部分装配体.SLDPRT
夹剪复合末端执行器-谭键聪/文件混合/零件3.SLDPRT
夹剪复合末端执行器-谭键聪/文件混合/零件4_剪切部分装配体.SLDPRT
夹剪复合末端执行器-谭键聪/装配体.IGS
夹剪复合末端执行器-谭键聪/装配体.SLDASM
夹剪复合末端执行器-谭键聪/零件/20度刀.SLDPRT
夹剪复合末端执行器-谭键聪/零件/后法兰.SLDPRT
夹剪复合末端执行器-谭键聪/零件/底板(5.29).SLDPRT
夹剪复合末端执行器-谭键聪/零件/装配体.SLDASM
夹剪复合末端执行器-谭键聪/零件/链接板.SLDPRT
夹剪复合末端执行器-谭键聪/零件/零件2_剪切部分装配体.SLDPRT
夹剪复合末端执行器-谭键聪/零件/零件3.SLDPRT
夹剪复合末端执行器-谭键聪/零件/零件4_剪切部分装配体.SLDPRT
潭江茶-谭键聪/第一代谭江茶/加工件/22齿轴.SLDPRT
潭江茶-谭键聪/第一代谭江茶/加工件/step/上盖1前.STEP
潭江茶-谭键聪/第一代谭江茶/加工件/step/上盖2.STEP
潭江茶-谭键聪/第一代谭江茶/加工件/step/刀片新.STEP
潭江茶-谭键聪/第一代谭江茶/加工件/step/小轴短.STEP
潭江茶-谭键聪/第一代谭江茶/加工件/step/小轴长改.STEP
潭江茶-谭键聪/第一代谭江茶/加工件/step/滑块.STEP
潭江茶-谭键聪/第一代谭江茶/加工件/step/电机架.STEP
潭江茶-谭键聪/第一代谭江茶/加工件/上盖1前.SLDPRT
潭江茶-谭键聪/第一代谭江茶/加工件/上盖1后.SLDPRT
潭江茶-谭键聪/第一代谭江茶/加工件/上盖2.SLDPRT
潭江茶-谭键聪/第一代谭江茶/加工件/上盖2后.SLDPRT
潭江茶-谭键聪/第一代谭江茶/加工件/主动轴.SLDPRT
潭江茶-谭键聪/第一代谭江茶/加工件/刀片新.SLDPRT
潭江茶-谭键聪/第一代谭江茶/加工件/小轴短.SLDPRT
潭江茶-谭键聪/第一代谭江茶/加工件/小轴长.SLDPRT
潭江茶-谭键聪/第一代谭江茶/加工件/小轴长改.SLDPRT
潭江茶-谭键聪/第一代谭江茶/加工件/工程图/22齿轴x2.SLDDRW
潭江茶-谭键聪/第一代谭江茶/加工件/工程图/上盖1前.SLDDRW
潭江茶-谭键聪/第一代谭江茶/加工件/工程图/上盖1后.SLDDRW
潭江茶-谭键聪/第一代谭江茶/加工件/工程图/上盖2前.SLDDRW
潭江茶-谭键聪/第一代谭江茶/加工件/工程图/上盖2后.SLDDRW
潭江茶-谭键聪/第一代谭江茶/加工件/工程图/主动轴x2.SLDDRW
潭江茶-谭键聪/第一代谭江茶/加工件/工程图/刀片新.SLDDRW
潭江茶-谭键聪/第一代谭江茶/加工件/工程图/小轴短x3.SLDDRW
潭江茶-谭键聪/第一代谭江茶/加工件/工程图/小轴长.SLDDRW
潭江茶-谭键聪/第一代谭江茶/加工件/工程图/小轴长改.SLDDRW
潭江茶-谭键聪/第一代谭江茶/加工件/工程图/底座前.SLDDRW
潭江茶-谭键聪/第一代谭江茶/加工件/工程图/底座后.SLDDRW
潭江茶-谭键聪/第一代谭江茶/加工件/工程图/滑块x4.SLDDRW
潭江茶-谭键聪/第一代谭江茶/加工件/工程图/滑块底座x4.SLDDRW
潭江茶-谭键聪/第一代谭江茶/加工件/工程图/电机架.SLDDRW
潭江茶-谭键聪/第一代谭江茶/加工件/工程图/齿轮x2.SLDDRW
潭江茶-谭键聪/第一代谭江茶/加工件/底座前.SLDPRT
潭江茶-谭键聪/第一代谭江茶/加工件/底座后.SLDPRT
潭江茶-谭键聪/第一代谭江茶/加工件/滑块.SLDPRT
潭江茶-谭键聪/第一代谭江茶/加工件/滑块底座.SLDPRT
潭江茶-谭键聪/第一代谭江茶/加工件/电机架.SLDPRT
潭江茶-谭键聪/第一代谭江茶/加工件/齿轮.SLDPRT
潭江茶-谭键聪/第一代谭江茶/打印件/上盖挡边1.STL
潭江茶-谭键聪/第一代谭江茶/打印件/上盖挡边2.STL
潭江茶-谭键聪/第一代谭江茶/打印件/收集盒1.STL
潭江茶-谭键聪/第一代谭江茶/打印件/盖板.STL
潭江茶-谭键聪/第一代谭江茶/装配体1.IGS
潭江茶-谭键聪/第一代谭江茶/装配体1.SLDASM
潭江茶-谭键聪/第一代谭江茶/购买件/22齿有挡边.SLDPRT
潭江茶-谭键聪/第二代潭江茶/图纸/上板右前1.SLDDRW
潭江茶-谭键聪/第二代潭江茶/图纸/上板右后.SLDDRW
潭江茶-谭键聪/第二代潭江茶/图纸/上板左前1.SLDDRW
潭江茶-谭键聪/第二代潭江茶/图纸/上板左后.SLDDRW
潭江茶-谭键聪/第二代潭江茶/图纸/底板前.step.SLDDRW
潭江茶-谭键聪/第二代潭江茶/图纸/底板后.SLDDRW
潭江茶-谭键聪/第二代潭江茶/图纸/滑块槽.SLDDRW
潭江茶-谭键聪/第二代潭江茶/图纸/轴.SLDDRW
潭江茶-谭键聪/第二代潭江茶/文件整合/上板右前1.SLDPRT
潭江茶-谭键聪/第二代潭江茶/文件整合/上板右前1.STEP
潭江茶-谭键聪/第二代潭江茶/文件整合/上板右后.SLDPRT
潭江茶-谭键聪/第二代潭江茶/文件整合/上板左前1.SLDDRW
潭江茶-谭键聪/第二代潭江茶/文件整合/上板左前1.SLDPRT
潭江茶-谭键聪/第二代潭江茶/文件整合/上板左前1.STEP
潭江茶-谭键聪/第二代潭江茶/文件整合/上板左后.SLDPRT
潭江茶-谭键聪/第二代潭江茶/文件整合/刀片改.SLDPRT
潭江茶-谭键聪/第二代潭江茶/文件整合/图纸/上板右前1.SLDDRW
潭江茶-谭键聪/第二代潭江茶/文件整合/图纸/上板右后.SLDDRW
潭江茶-谭键聪/第二代潭江茶/文件整合/图纸/上板左前1.SLDDRW
潭江茶-谭键聪/第二代潭江茶/文件整合/图纸/上板左后.SLDDRW
潭江茶-谭键聪/第二代潭江茶/文件整合/图纸/底板前.step.SLDDRW
潭江茶-谭键聪/第二代潭江茶/文件整合/图纸/底板后.SLDDRW
潭江茶-谭键聪/第二代潭江茶/文件整合/图纸/滑块槽.SLDDRW
潭江茶-谭键聪/第二代潭江茶/文件整合/图纸/轴.SLDDRW
潭江茶-谭键聪/第二代潭江茶/文件整合/底板前.STEP
潭江茶-谭键聪/第二代潭江茶/文件整合/底板后.SLDPRT
潭江茶-谭键聪/第二代潭江茶/文件整合/滑块槽.SLDDRW
潭江茶-谭键聪/第二代潭江茶/文件整合/滑块槽.SLDPRT
潭江茶-谭键聪/第二代潭江茶/文件整合/轴.SLDDRW
潭江茶-谭键聪/第二代潭江茶/文件整合/轴.SLDPRT
潭江茶-谭键聪/第二代潭江茶/装配体.IGS
潭江茶-谭键聪/第二代潭江茶/装配体.SLDASM
番石榴-丘圳中/番石榴装配体.IGS
番石榴_傅文平/末端执行器.IGS
英红九号-何子健/第二代末端执行器20261014/加工件/上颚.SLDPRT
英红九号-何子健/第二代末端执行器20261014/加工件/基准板.SLDPRT
英红九号-何子健/第二代末端执行器20261014/加工件/左轴承座.SLDPRT
英红九号-何子健/第二代末端执行器20261014/加工件/转轴.SLDPRT
英红九号-何子健/第二代末端执行器20261014/提拉式末端执行器.IGS
英红九号-何子健/第二代末端执行器20261014/提拉式末端执行器.SLDASM
英红九号-何子健/第二代末端执行器20261014/购买件/C型弹性挡圈-轴用 DQA[DQA-10].SLDPRT
英红九号-何子健/第二代末端执行器20261014/零件STEP/C型弹性挡圈-轴用 DQA[DQA-10].STEP
英红九号-何子健/第二代末端执行器20261014/零件STEP/上颚.STEP
英红九号-何子健/第二代末端执行器20261014/零件STEP/下鄂.STEP
英红九号-何子健/第二代末端执行器20261014/零件STEP/刀片连接件.STEP
英红九号-何子健/第二代末端执行器20261014/零件STEP/十字臂.STEP
英红九号-何子健/第二代末端执行器20261014/零件STEP/右侧板.STEP
英红九号-何子健/第二代末端执行器20261014/零件STEP/固定夹.STEP
英红九号-何子健/第二代末端执行器20261014/零件STEP/基准板.STEP
英红九号-何子健/第二代末端执行器20261014/零件STEP/外壳_hzj.STEP
英红九号-何子健/第二代末端执行器20261014/零件STEP/左侧板.STEP
英红九号-何子健/第二代末端执行器20261014/零件STEP/收集下板.STEP
英红九号-何子健/第二代末端执行器20261014/零件STEP/收集轴盘.STEP
英红九号-何子健/第二代末端执行器20261014/零件STEP/新刀片.STEP
英红九号-何子健/第二代末端执行器20261014/零件STEP/新缓冲垫.STEP
英红九号-何子健/第二代末端执行器20261014/零件STEP/转轴.STEP
英红九号-何子健/第二代末端执行器20261014/零件STEP/轴承（6x10x3）.STEP
英红九号-何子健/第二代末端执行器20261014/零件STEP/轴盘.STEP
英红九号-何子健/第二代末端执行器20261014/零件STEP/重物.STEP
英红九号-郑晓鑫/step/铝合金/下刀板.STEP
英红九号-郑晓鑫/step/铝合金/传动件2.STEP
英红九号-郑晓鑫/step/铝合金/底座零件.STEP
英红九号-郑晓鑫/step/铝合金/舵机支架.STEP
英红九号-郑晓鑫/step/铝合金/轴盘.STEP
英红九号-郑晓鑫/上刀板L型块.SLDPRT
英红九号-郑晓鑫/主体轴.SLDPRT
英红九号-郑晓鑫/传动件1.SLDPRT
英红九号-郑晓鑫/传动件2.SLDPRT
英红九号-郑晓鑫/刀架盖.SLDPRT
英红九号-郑晓鑫/工程图/T型块1.SLDDRW
英红九号-郑晓鑫/工程图/上刀板L型块.SLDDRW
英红九号-郑晓鑫/工程图/上刀片.SLDDRW
英红九号-郑晓鑫/工程图/下刀板.SLDDRW
英红九号-郑晓鑫/工程图/下刀板L型.SLDDRW
英红九号-郑晓鑫/工程图/主体轴.SLDDRW
英红九号-郑晓鑫/工程图/传动件1.SLDDRW
英红九号-郑晓鑫/工程图/传动件2.SLDDRW
英红九号-郑晓鑫/工程图/刀架盖.SLDDRW
英红九号-郑晓鑫/工程图/底座零件.SLDDRW
英红九号-郑晓鑫/工程图/底座（T）.SLDDRW
英红九号-郑晓鑫/工程图/挡杆.SLDDRW
英红九号-郑晓鑫/工程图/舵机支架.SLDDRW
英红九号-郑晓鑫/工程图/轴盘.SLDDRW
英红九号-郑晓鑫/底座（T）.SLDPRT
英红九号-郑晓鑫/打印/上刀轴套右.STL
英红九号-郑晓鑫/挡杆.SLDPRT
英红九号-郑晓鑫/新刀架2.SLDPRT
英红九号-郑晓鑫/末端装配6.16.IGS
英红九号-郑晓鑫/舵机支架.SLDPRT
英红九号-郑晓鑫/购买件/m3-10.SLDPRT
英红九号-郑晓鑫/购买件/m3-4.SLDPRT
英红九号-郑晓鑫/购买件/m4螺母.SLDPRT
英红九号-郑晓鑫/购买件/轴承1(1)(1).SLDPRT
