lgc-robotics/end_effector_project/番石榴-丘圳中/工程图/L型连接板.pdf

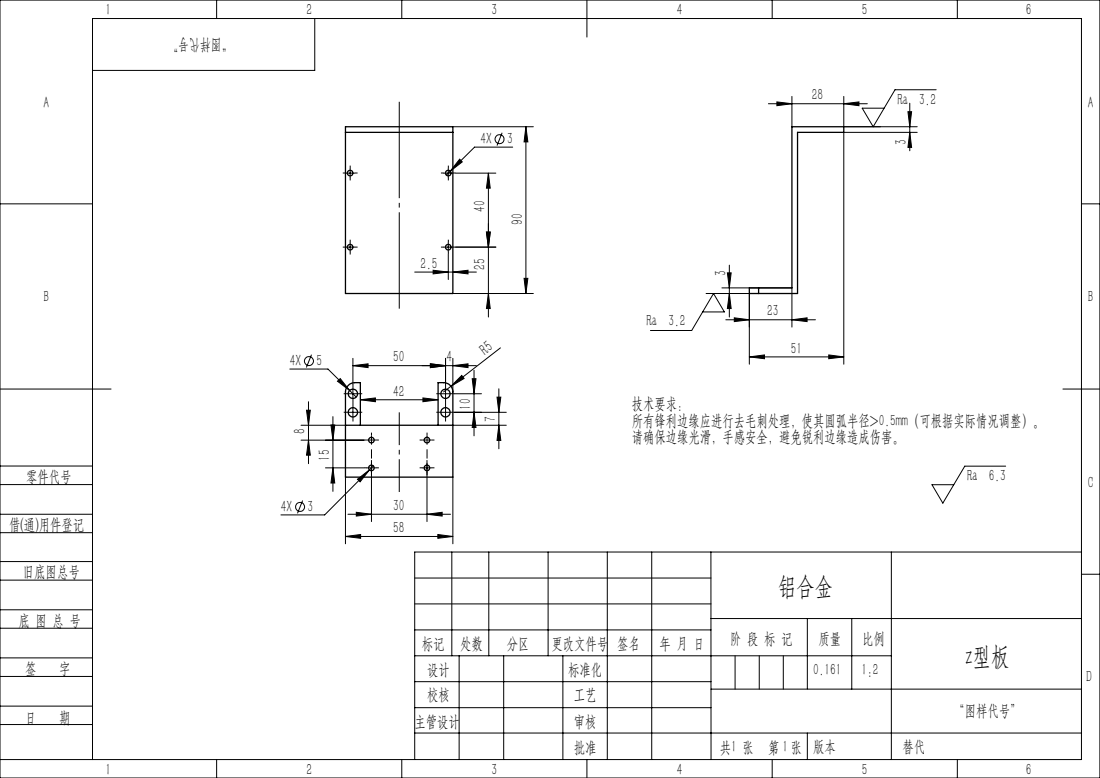
[picture p133: page 1]

技术要求：
所有锋利边缘应进行去毛刺处理，使其圆弧半径>0.5mm（可根据实际情况调整）。
请确保边缘光滑，手感安全，避免锐利边缘造成伤害。

铝合金

阶 段 标 记 | 质量 | 比例 | z型板 0.161

标记 | 处数 | 分区 | 更改文件号 | 签名 | 年 月 日

“图样代号”
