lgc-robotics/end_effector_project/番石榴-丘圳中/工程图/底板工程图.pdf

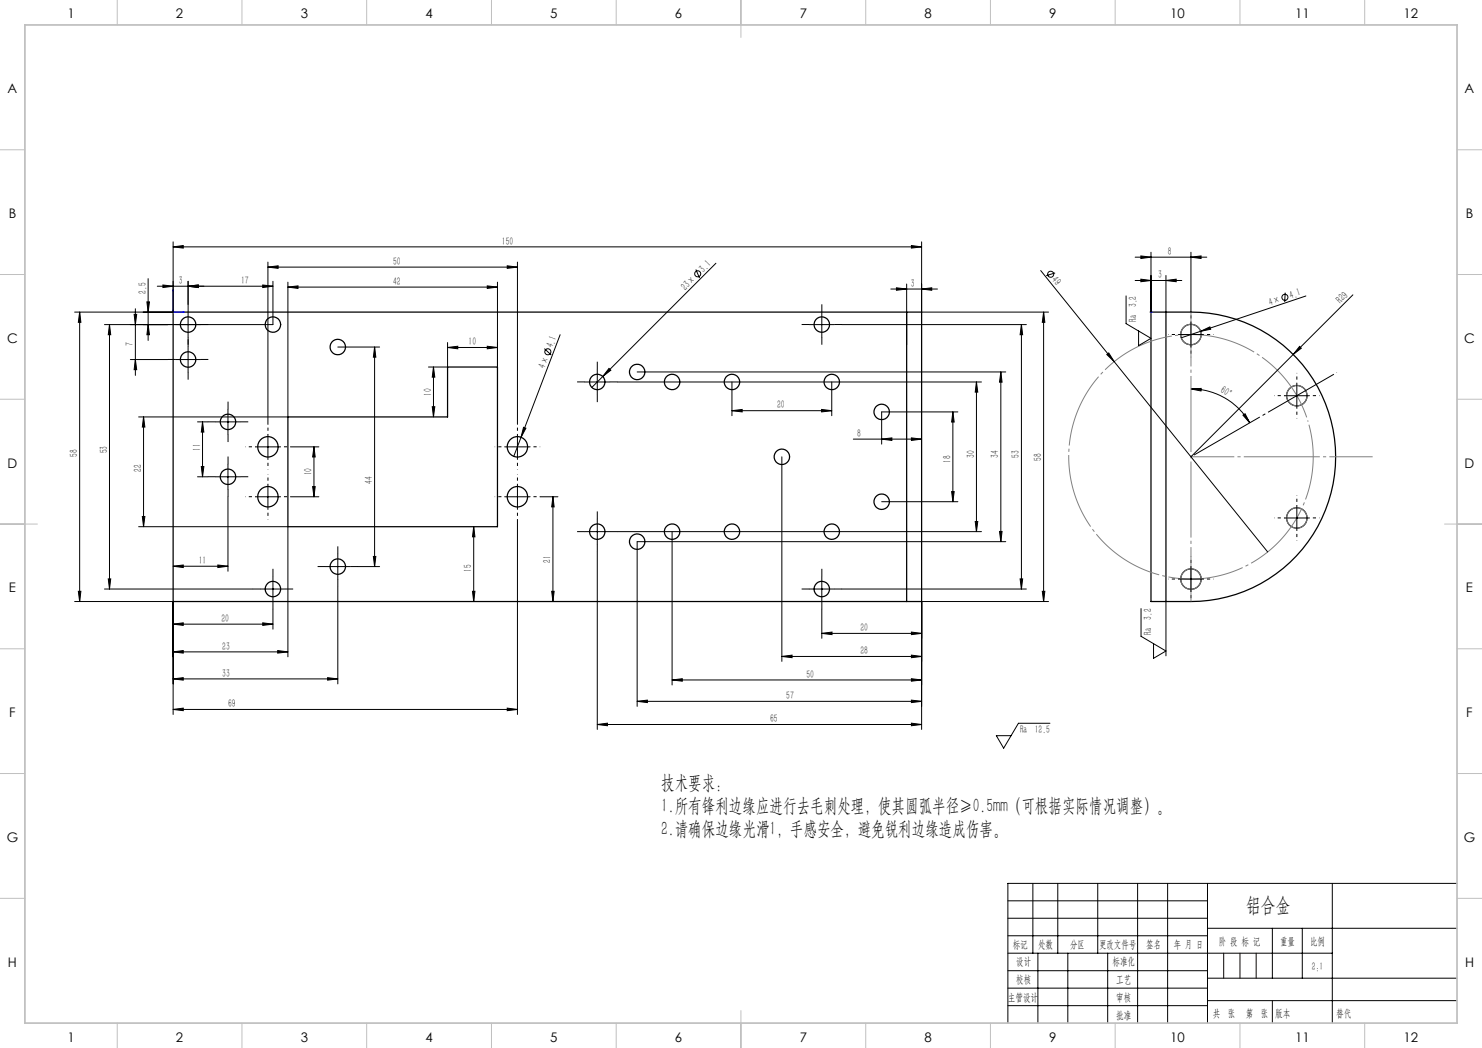
[picture p134: page 1]

技术要求：
1.所有锋利边缘应进行去毛刺处理，使其圆弧半径≥0.5mm（可根据实际情况调整）。
2.请确保边缘光滑1，手感安全，避免锐利边缘造成伤害。

铝合金

标记 | 处数 | 分区 | 更改文件号 | 签名 | 年 月 日
设计 | | | 标准化 | | | 2:1
校核 | | | 工艺
主管设计 | | | 审核
