lgc-robotics/end_effector_project/夹剪复合末端执行器-谭键聪/图纸/后法兰.pdf

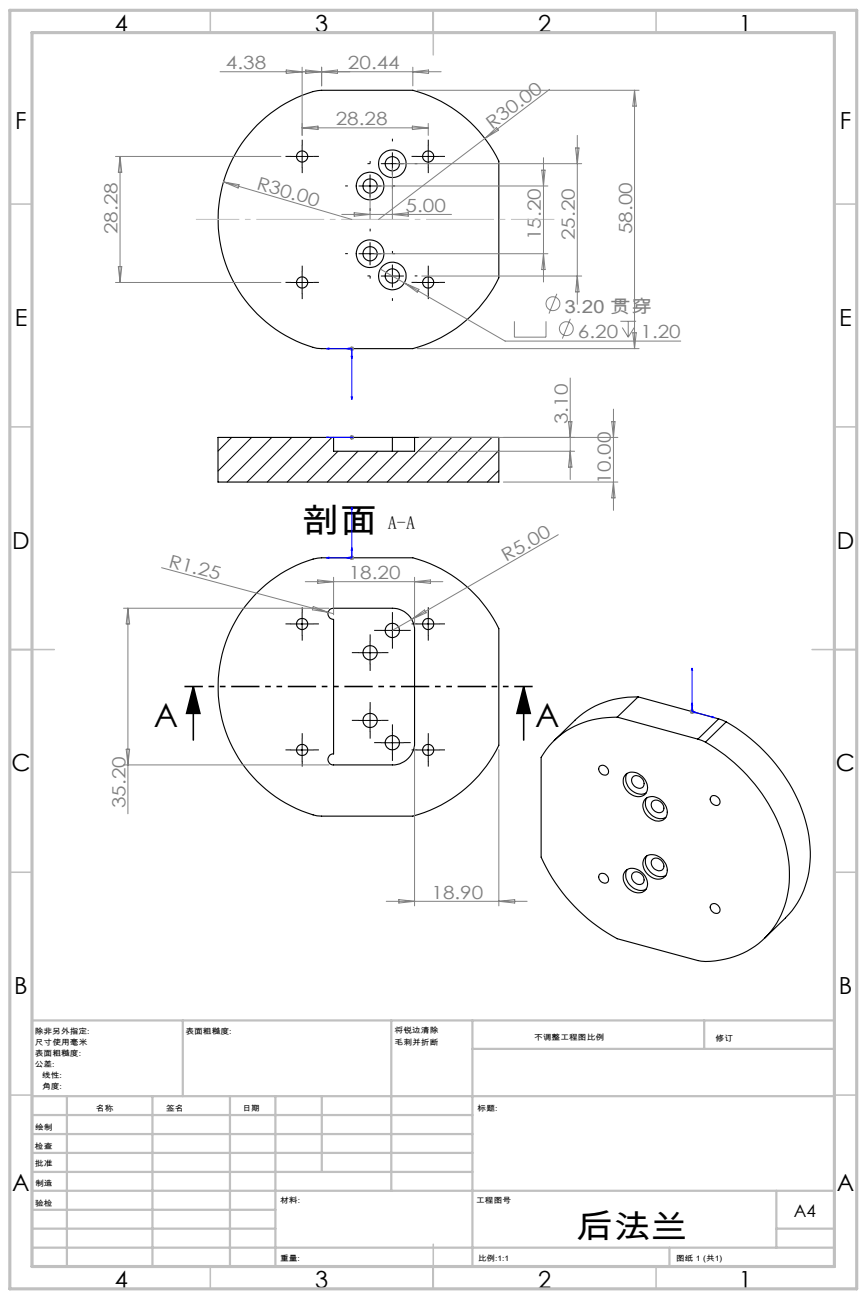
[picture p135: page 1]

绘制
检查
批准
制造
验检 | | | | 材料: | 工程图号 后法兰 | A4
