lgc-robotics/end_effector_project/夹剪复合末端执行器-谭键聪/图纸/底板(5.29).pdf

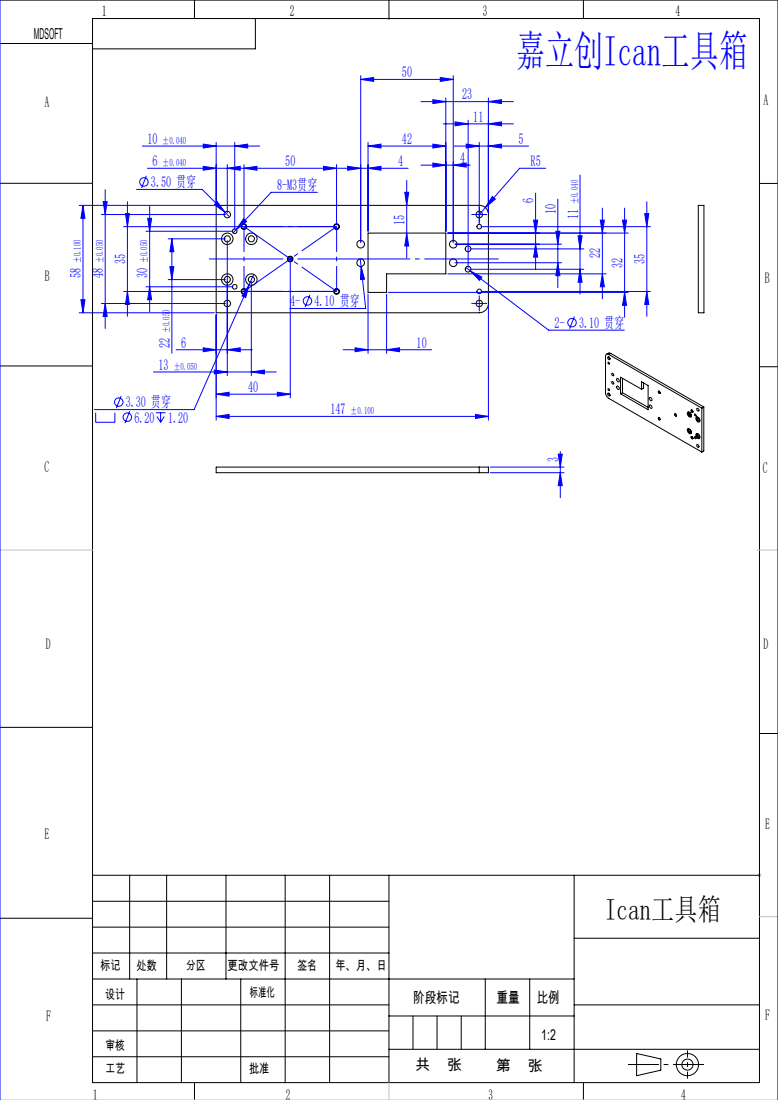
[picture p136: page 1]

标记 | 处数 | 分区 | 更改文件号 | 签名 | 年、月、日
设计 | | | 标准化 | | | 阶段标记 | 重量 | 比例

审核
工艺 | 批准
