lgc-robotics/end_effector_project/番石榴-丘圳中/工程图/主动齿轮.pdf

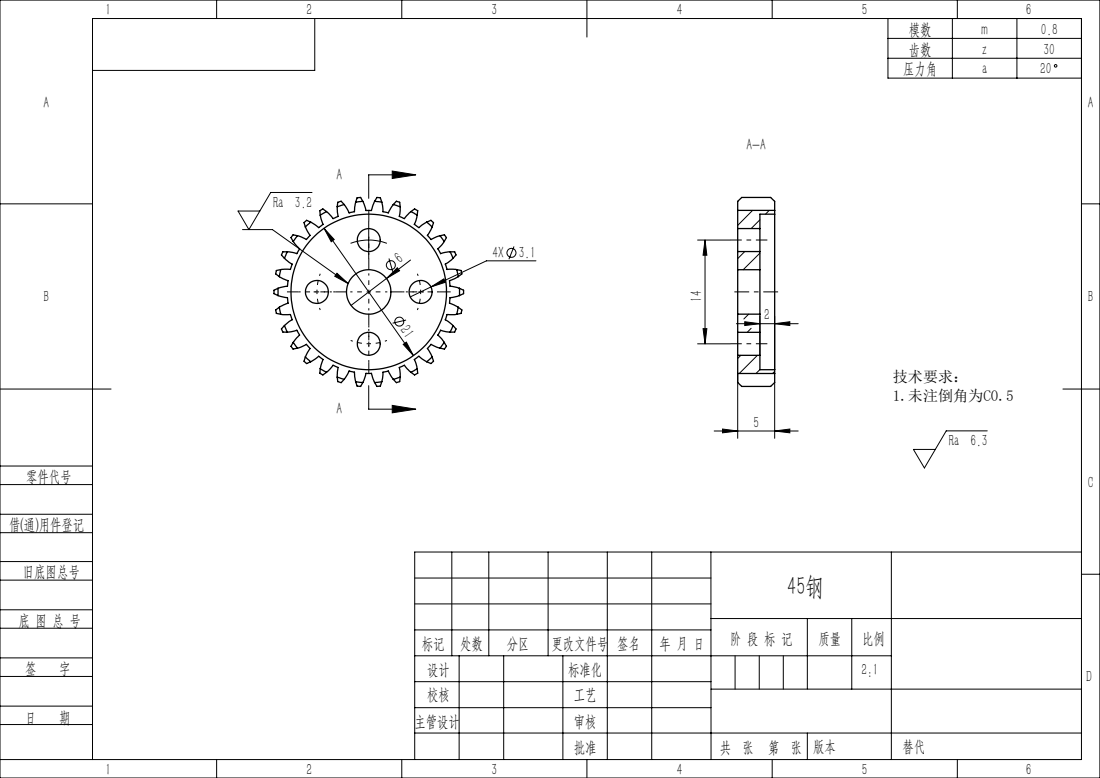
[picture p138: page 1]

模数 | m | 0.8
齿数 | z | 30
压力角 | a | 20

标记 | 处数 | 分区 | 更改文件号 | 签名 | 年 月 日
