lgc-robotics/end_effector_project/番石榴-丘圳中/工程图/从动齿轮.pdf

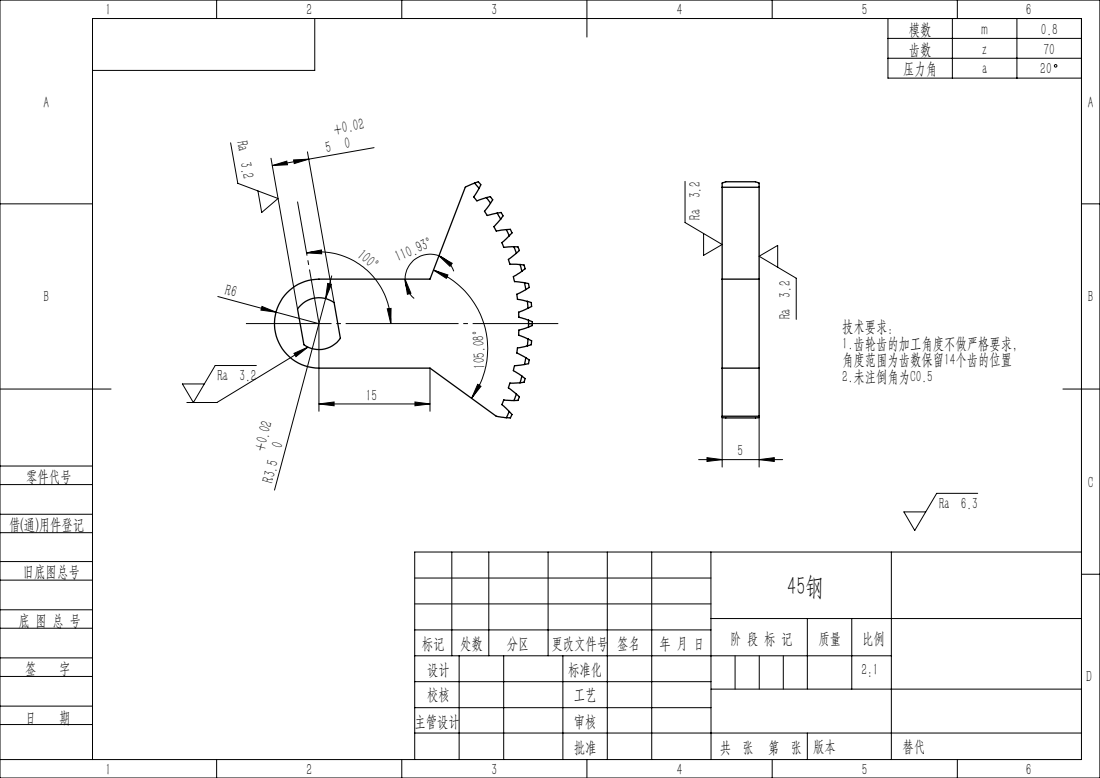
[picture p139: page 1]

模数 | m | 0.8
齿数 | z | 70
压力角 | a | 20

标记 | 处数 | 分区 | 更改文件号 | 签名 | 年 月 日
