lgc-robotics/end_effector_project/番石榴-丘圳中/工程图/动刀.pdf

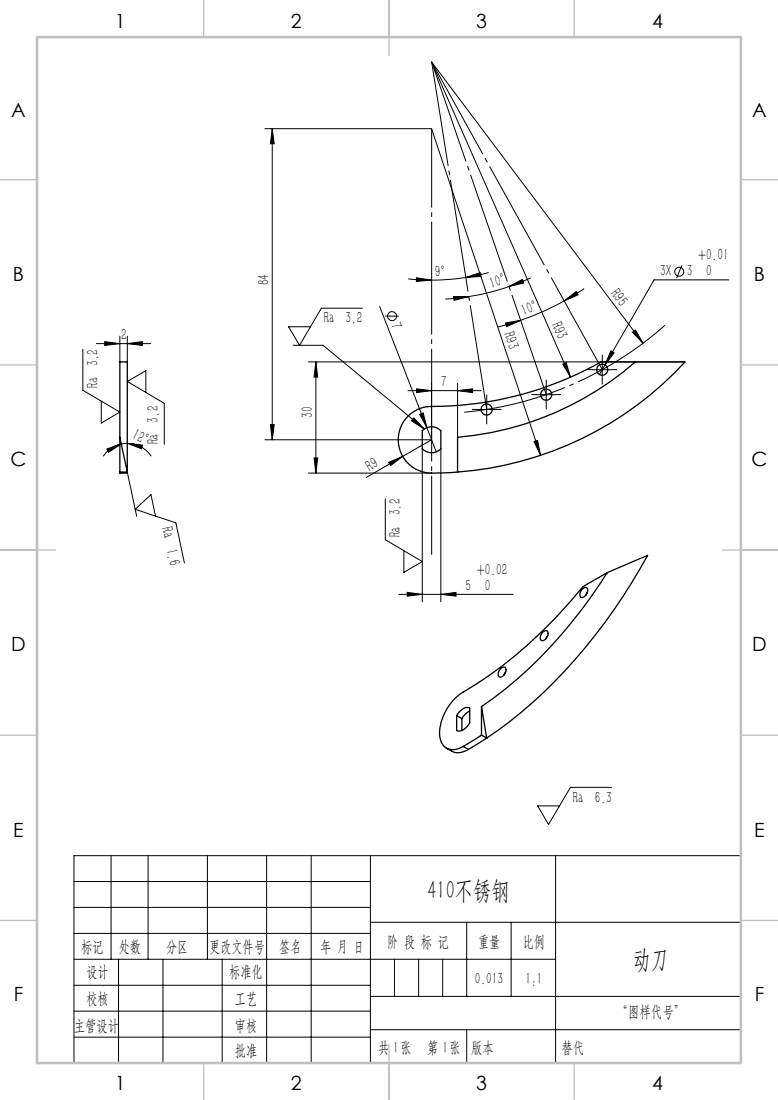
[picture p140: page 1]

410不锈钢

标记 | 处数 | 分区 | 更改文件号 | 签名 | 年 月 日
设计 | | | 标准化 | | | 0.013 | 1:1
校核 | | | 工艺
主管设计 | | | 审核

“图样代号”
