lgc-robotics/end_effector_project/番石榴-丘圳中/工程图/轴.pdf

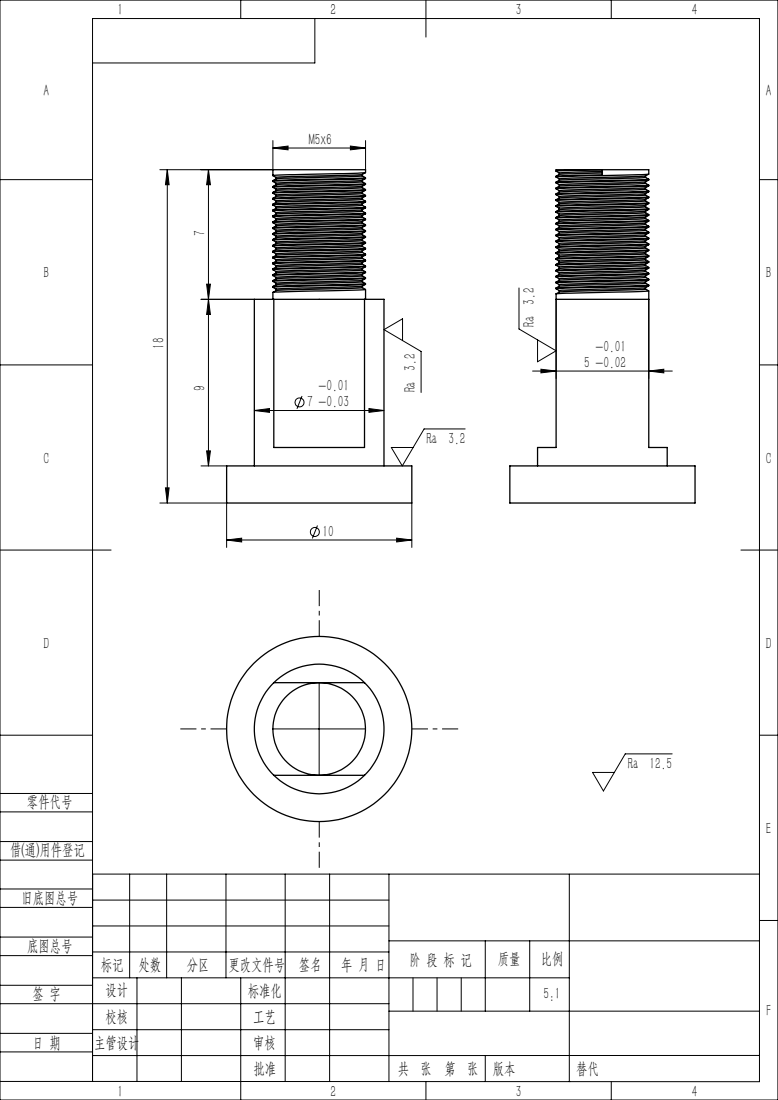
[picture p142: page 1]

标记 | 处数 | 分区 | 更改文件号 | 签名 | 年 月 日
设计 | | | 标准化 | | | | | | 5:1
校核 | | | 工艺
主管设计 | | | 审核
