lgc-robotics/end_effector_project/番石榴-丘圳中/工程图/静刀5.10.pdf

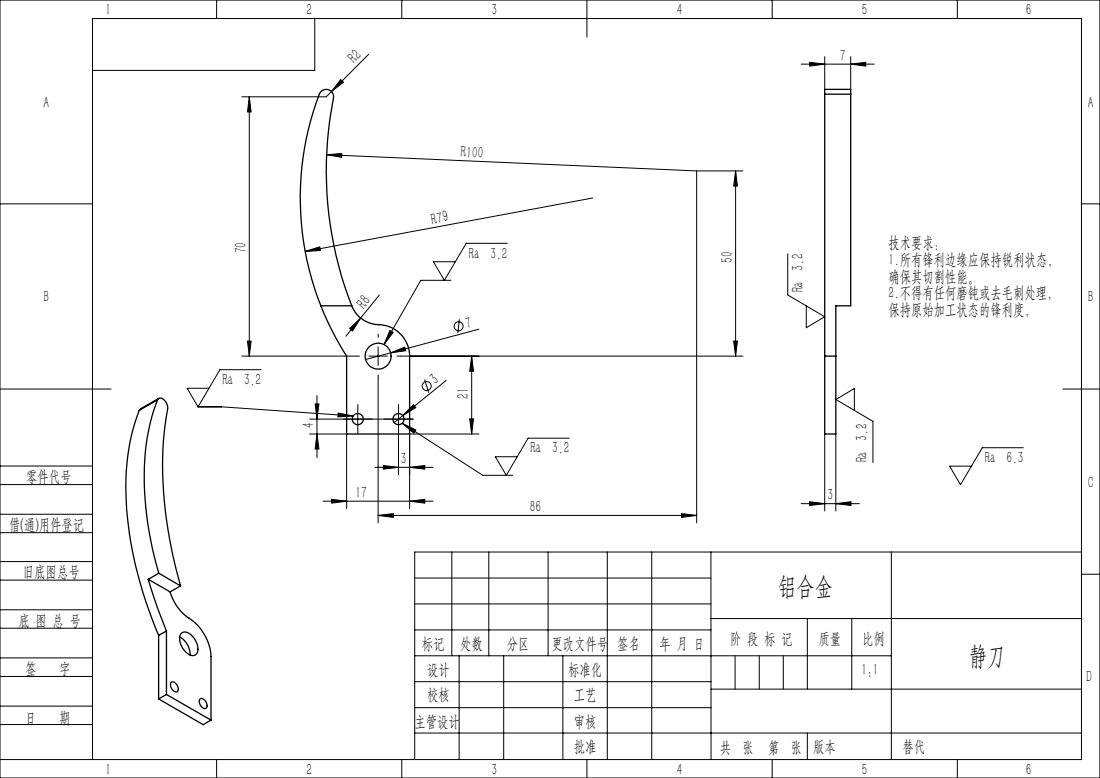
[picture p143: page 1]

铝合金

标记 | 处数 | 分区 | 更改文件号 | 签名 | 年 月 日
