lgc-robotics/end_effector_project/番石榴_傅文平/工程图/刀片.pdf

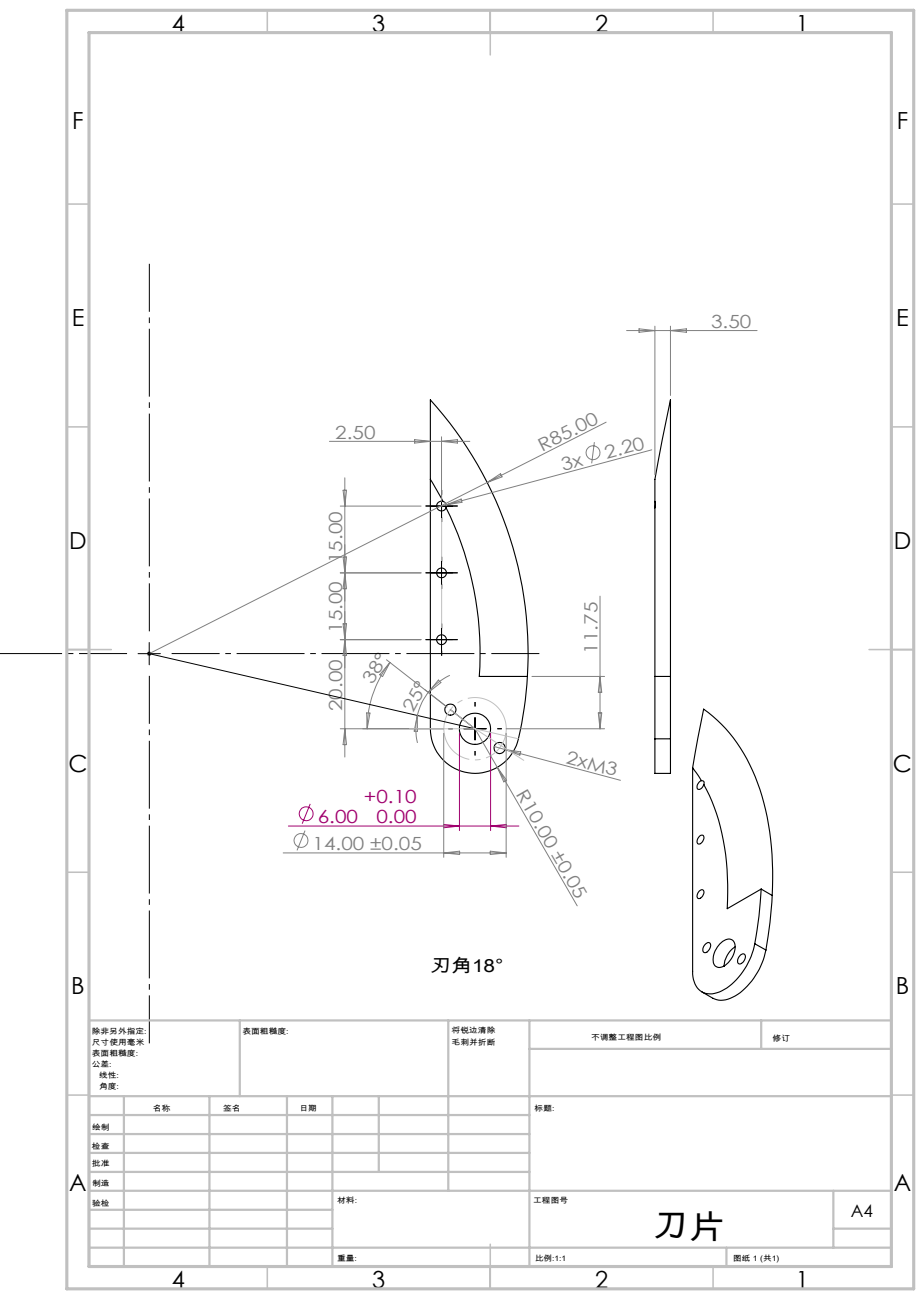
[picture p144: page 1]

绘制
检查
批准
制造
验检 | | | | 材料: | 工程图号 刀片 | A4
