lgc-robotics/end_effector_project/番石榴_傅文平/工程图/底板5.25.pdf

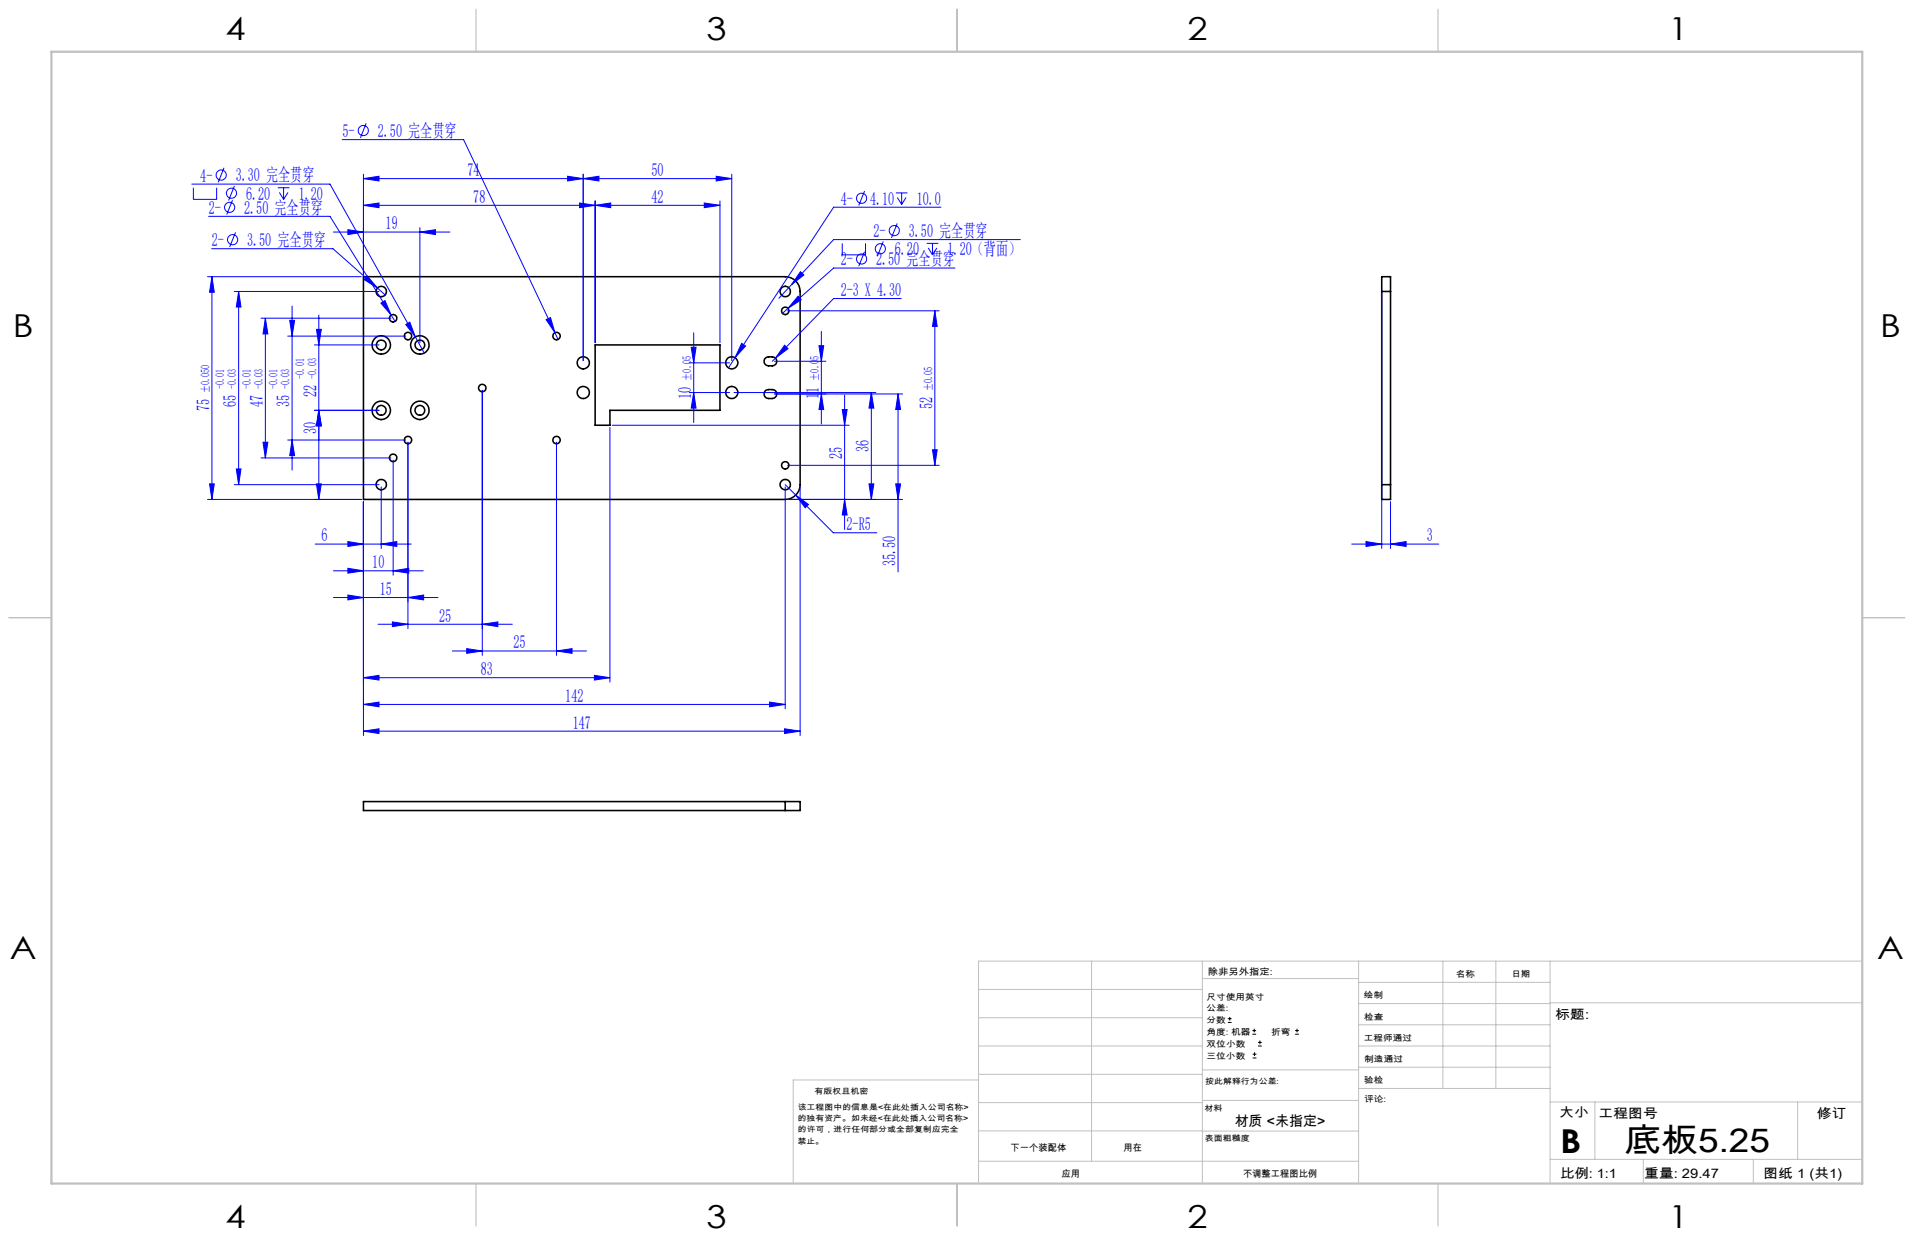
[picture p145: page 1]
3.50 完全贯穿; 2.50 完全贯穿; 3.30 完全贯穿

除非另外指定: | | 名称 | 日期

尺寸使用英寸 公差: 分数 角度: 机器 折弯 双位小数 三位小数 | 绘制

工程师通过
制造通过

按此解释行为公差: | 验检

有版权且机密
该工程图中的信息是<在此处插入公司名称>
的独有资产。如未经<在此处插入公司名称>
的许可，进行任何部分或全部复制应完全

材料 材质 <未指定> | | 大小 B | 工程图号 底板5.25 | 修订

下一个装配体 | 用在 | 表面粗糙度

应用 | 不调整工程图比例 | | 比例: 1:1 | 重量: 29.47 | 图纸 1 (共1)
