lgc-robotics/end_effector_project/番石榴_傅文平/工程图/摇杆.pdf

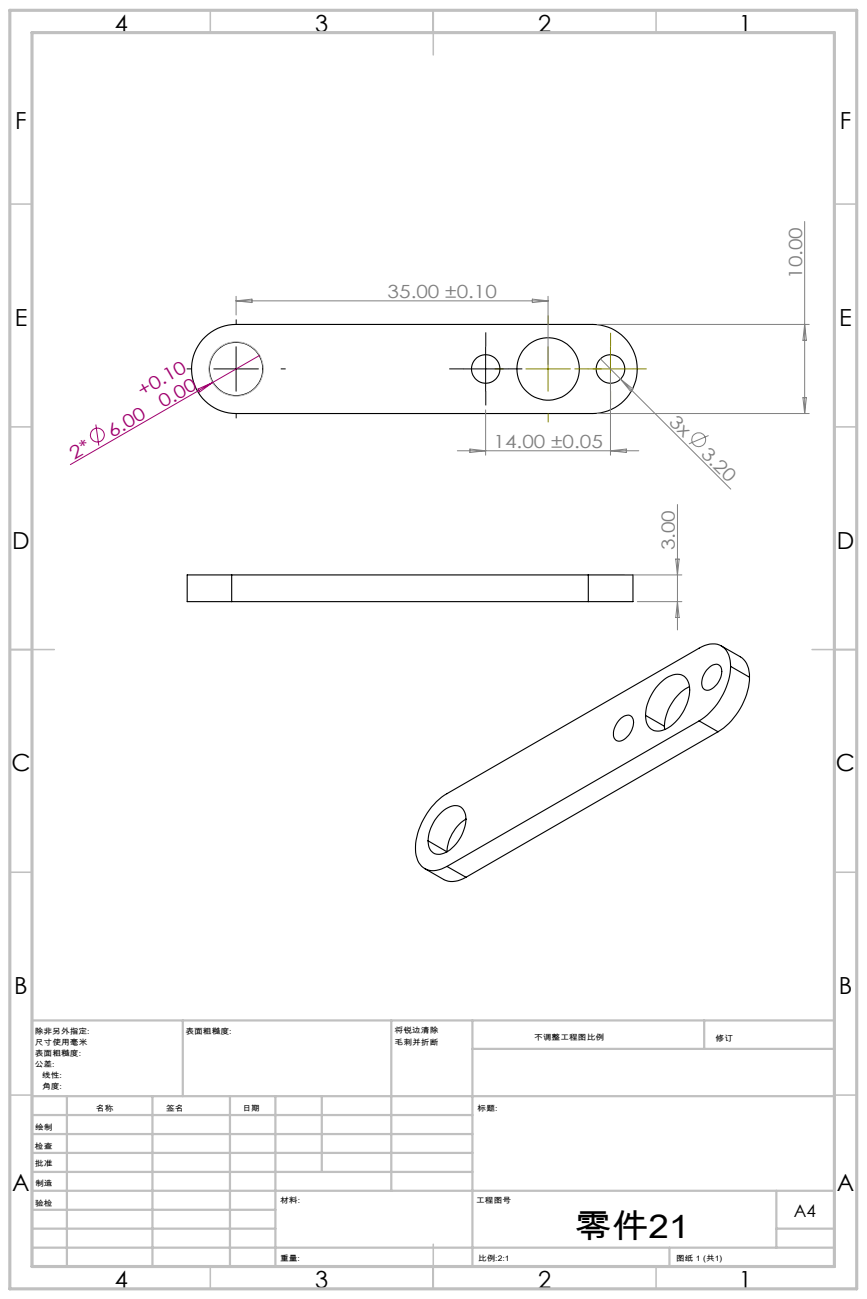
[picture p146: page 1]

绘制
检查
批准
制造
验检 | | | | 材料: | 工程图号 零件21 | A4
