lgc-robotics/end_effector_project/番石榴_傅文平/工程图/静刀.pdf

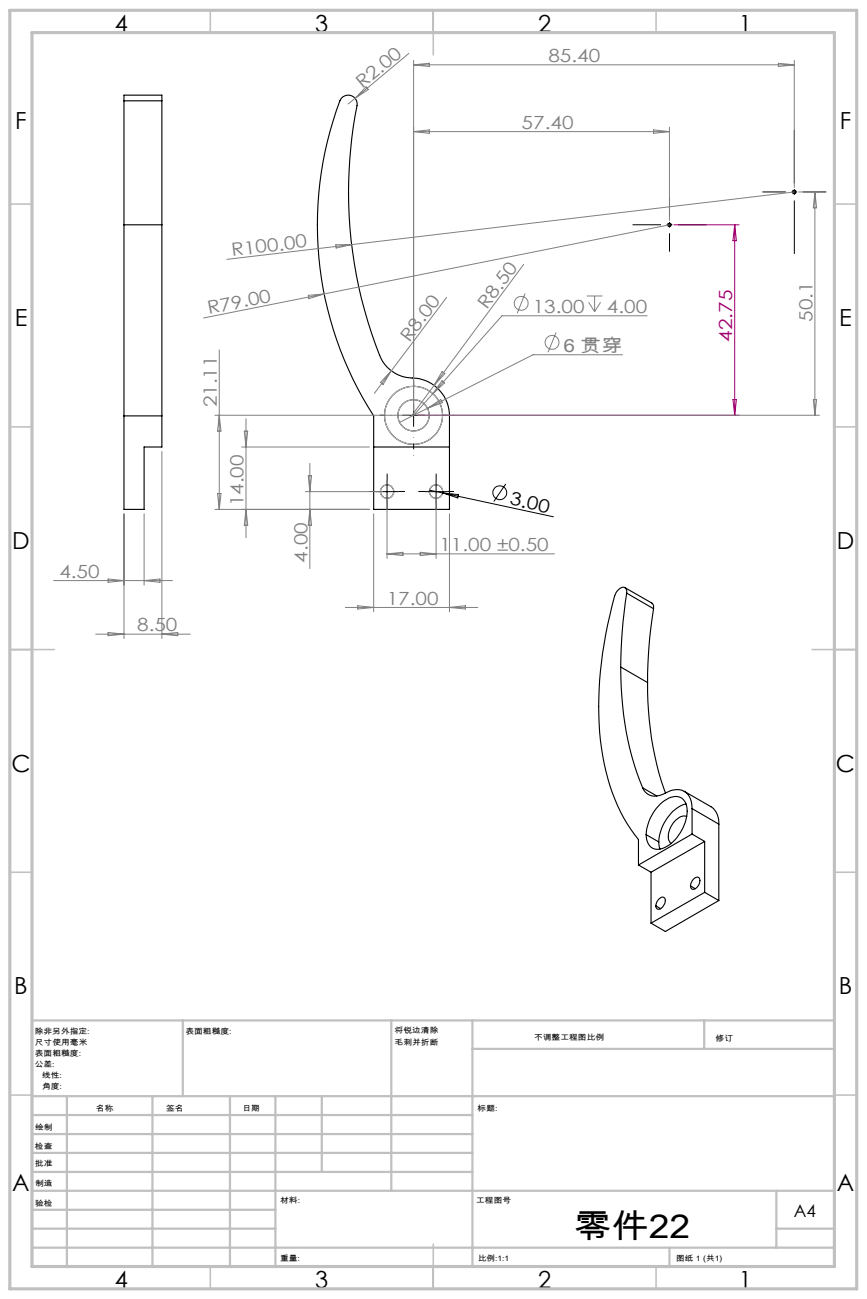
[picture p148: page 1]

绘制
检查
批准
制造
验检 | | | | 材料: | 工程图号 零件22 | A4
