lgc-robotics/end_effector_project/蘑菇-姚上泉/工程图/l型板.pdf

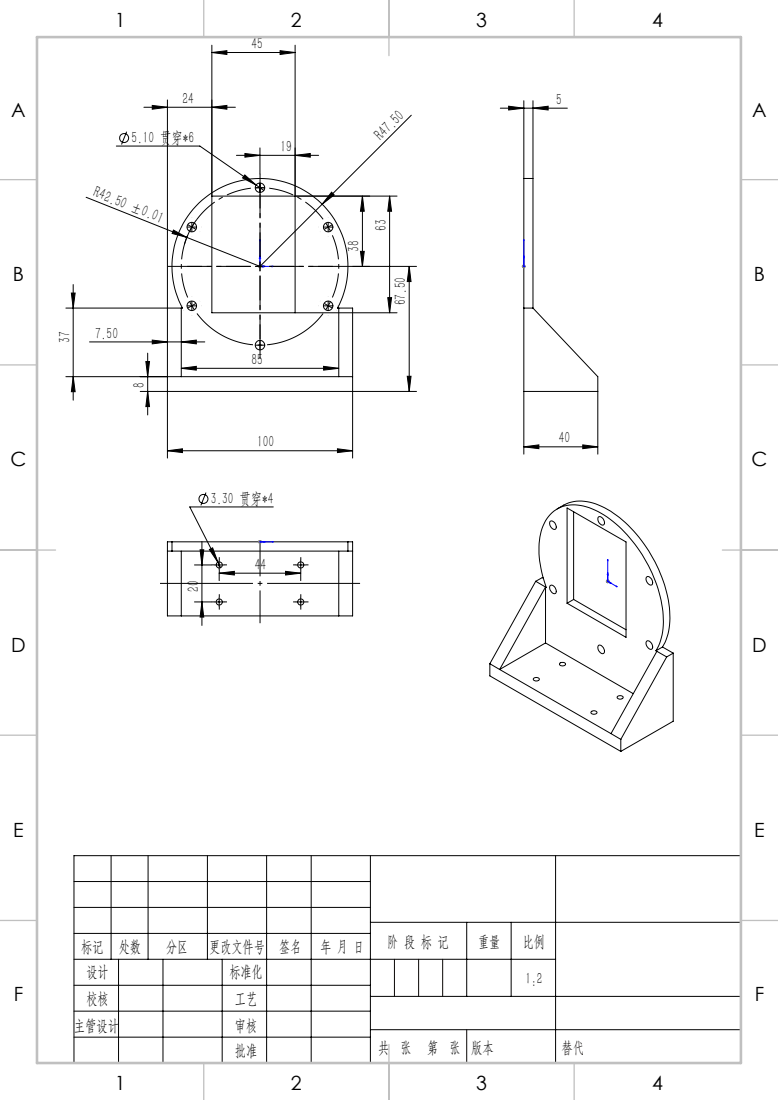
[picture p149: page 1]

标记 | 处数 | 分区 | 更改文件号 | 签名 | 年 月 日
设计 | | | 标准化 | | | 1:2
校核 | | | 工艺
主管设计 | | | 审核
