lgc-robotics/end_effector_project/英红九号-何子健/第二代末端执行器20261014/加工件/转轴.pdf

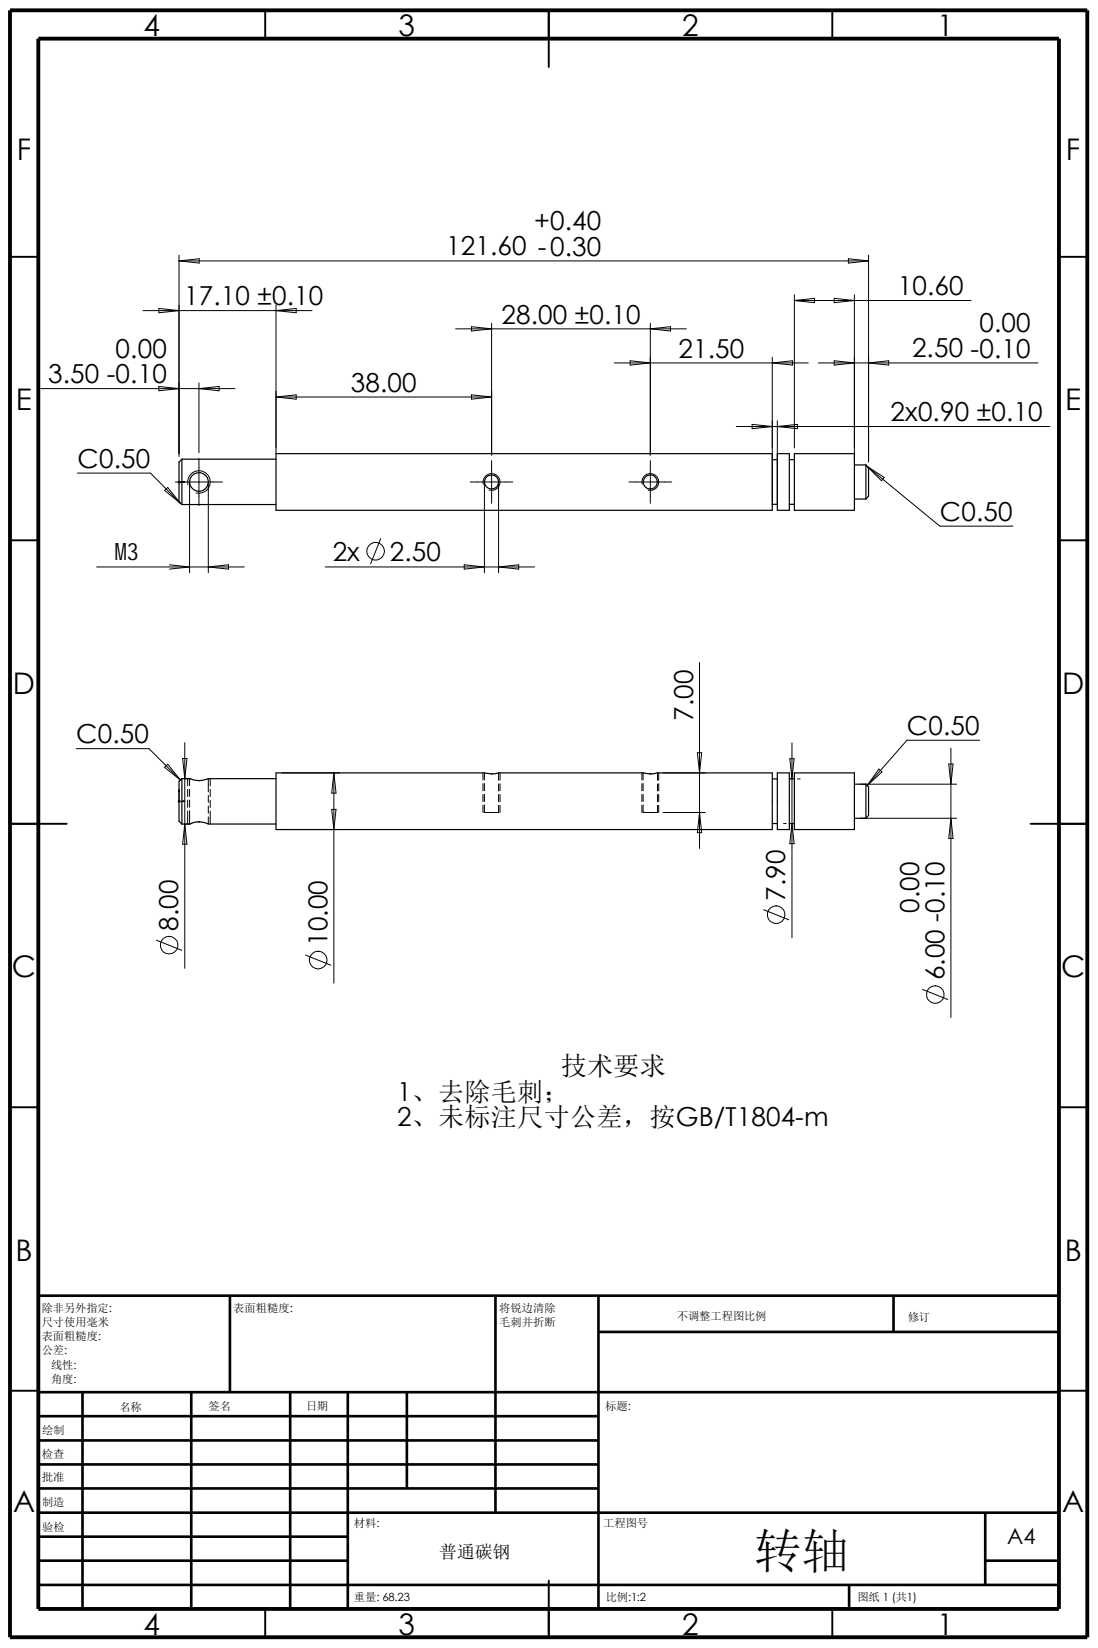
[picture p153: page 1]
表面粗糙度:; 不调整工程图比例; 除非另外指定: 尺寸使用毫米 表面粗糙度: 公差: 线性: 角度:; 将锐边清除 毛刺并折断; 技术要求 1、去除毛刺； 2、未标注尺寸公差，按GB/T1804-m

批准
验检 | | | | 材料: 普通碳钢 | 工程图号 转轴 | A4
