lgc-robotics/end_effector_project/潭江茶-谭键聪/第二代潭江茶/图纸/底板后.pdf

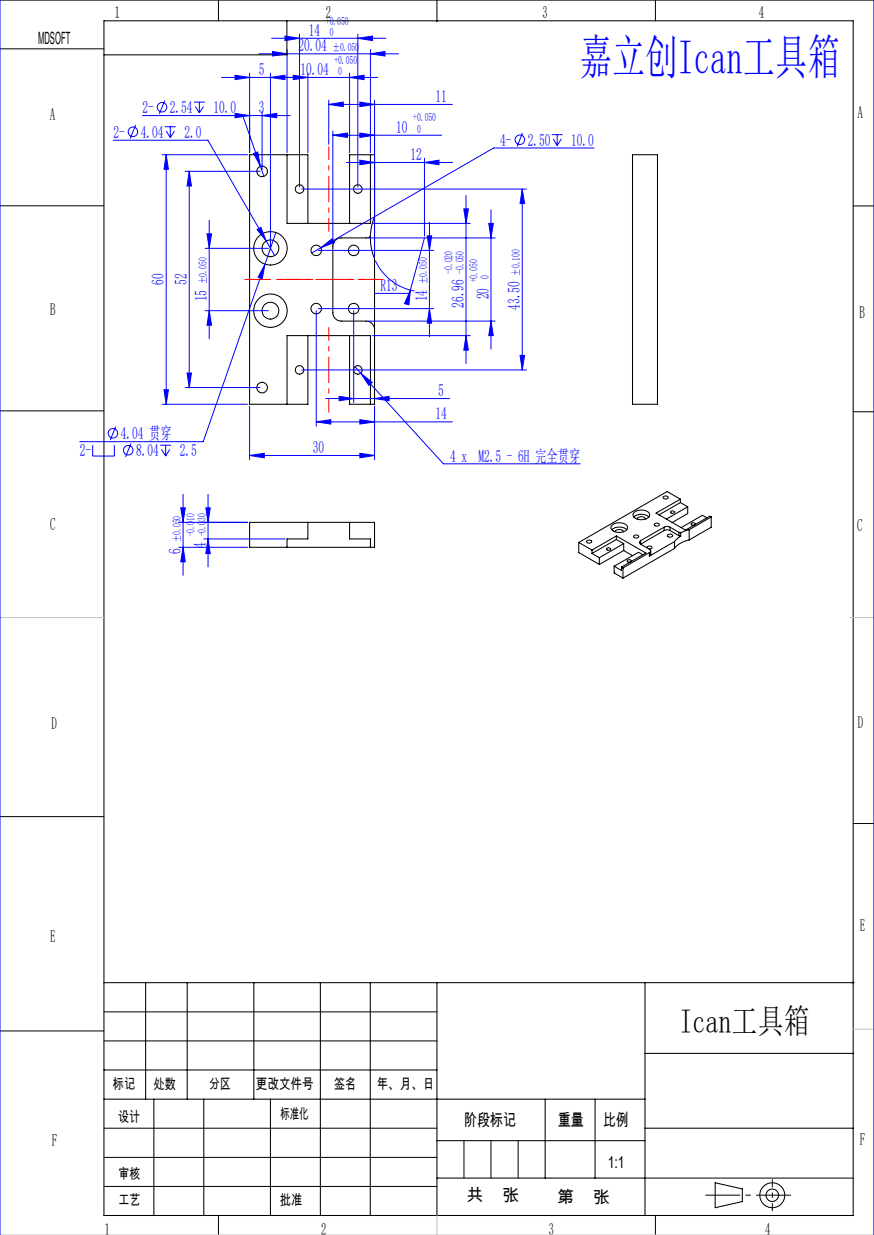
[picture p157: page 1]
4 x M2.5 - 6H 完全贯穿

标记 | 处数 | 分区 | 更改文件号 | 签名 | 年、月、日
设计 | | | 标准化 | | | 阶段标记 | 重量 | 比例

审核
工艺 | 批准
