lgc-robotics/end_effector_project/英红九号-郑晓鑫/工程图/pdf/T型块1.pdf

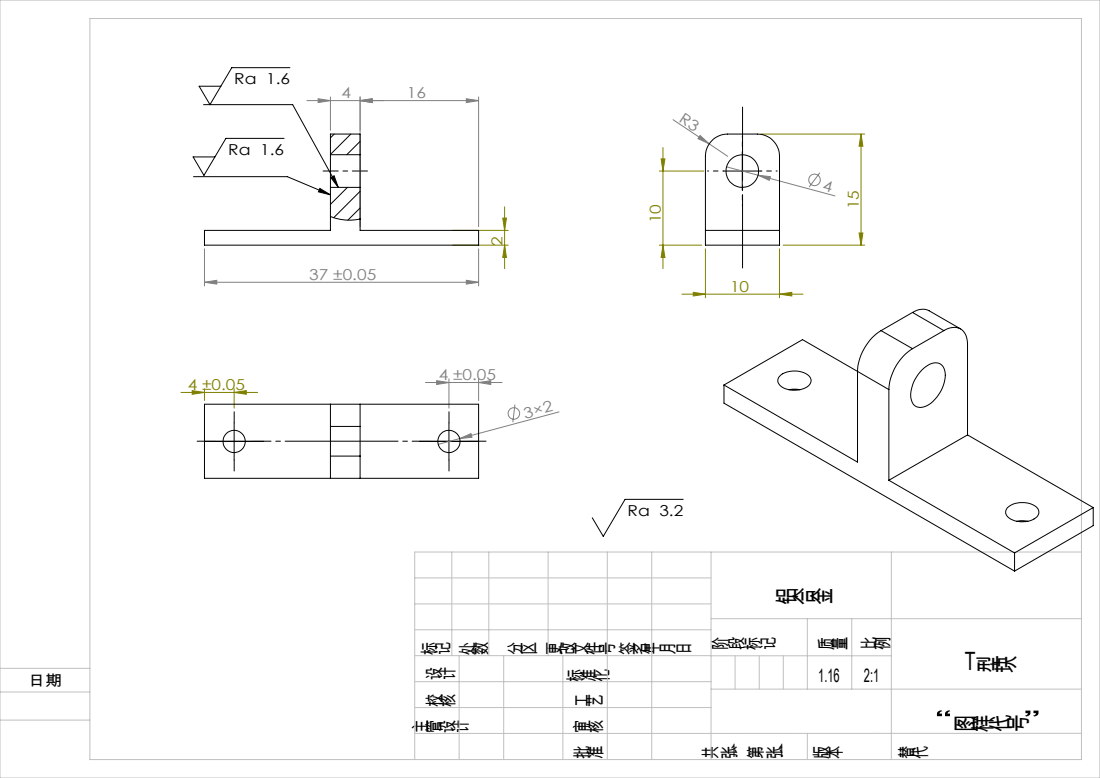
[picture p160: page 1]
