lgc-robotics/end_effector_project/英红九号-郑晓鑫/工程图/pdf/主体轴.pdf

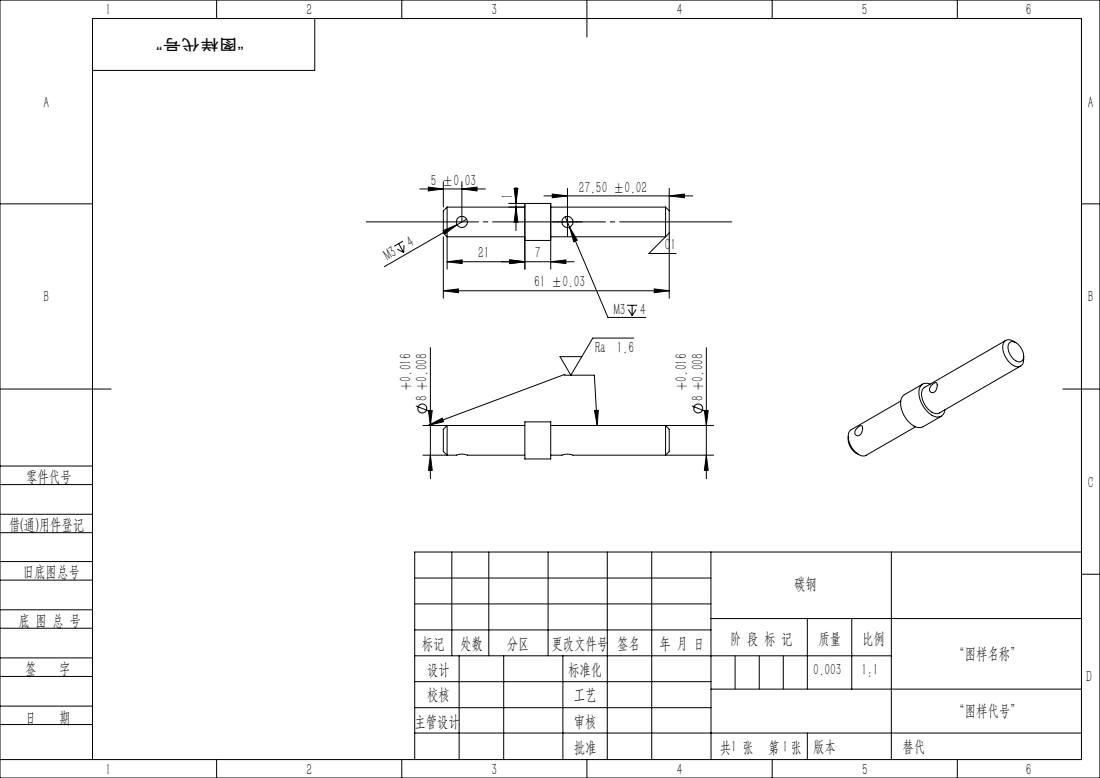
[picture p161: page 1]

阶 段 标 记 | 质量 | 比例 | “图样名称”

标记 | 处数 | 分区 | 更改文件号 | 签名 | 年 月 日

“图样代号”
