lgc-robotics/end_effector_project/英红九号-郑晓鑫/工程图/pdf/刀架盖.pdf

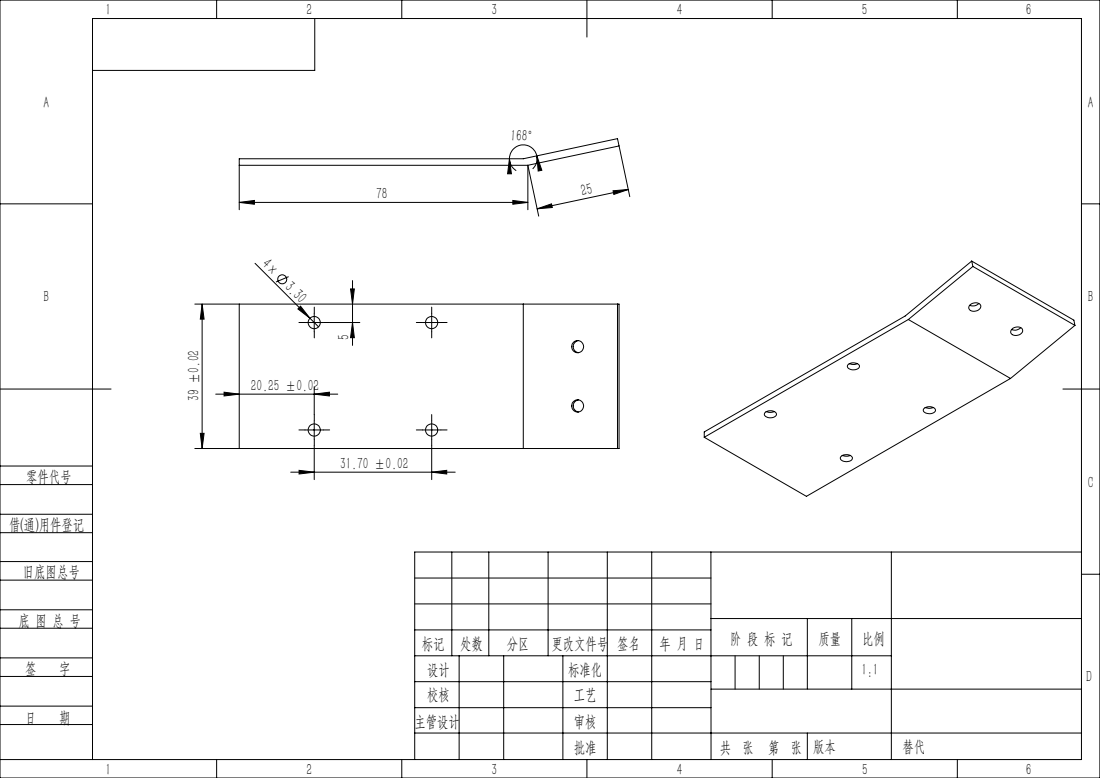
[picture p162: page 1]

标记 | 处数 | 分区 | 更改文件号 | 签名 | 年 月 日
