lgc-robotics/end_effector_project/英红九号-郑晓鑫/工程图/pdf/舵机支架.pdf

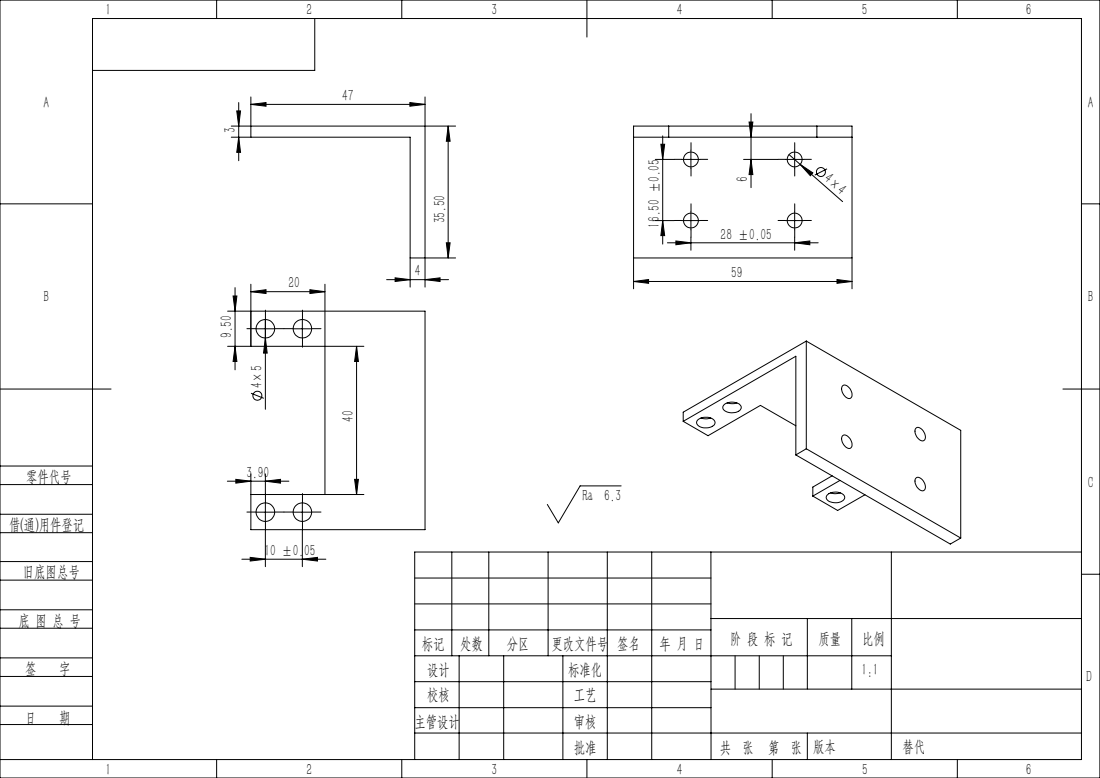
[picture p163: page 1]

标记 | 处数 | 分区 | 更改文件号 | 签名 | 年 月 日
