lgc-robotics/end_effector_project/潭江茶-谭键聪/第一代谭江茶/加工件/工程图/pdf/上盖1后.pdf

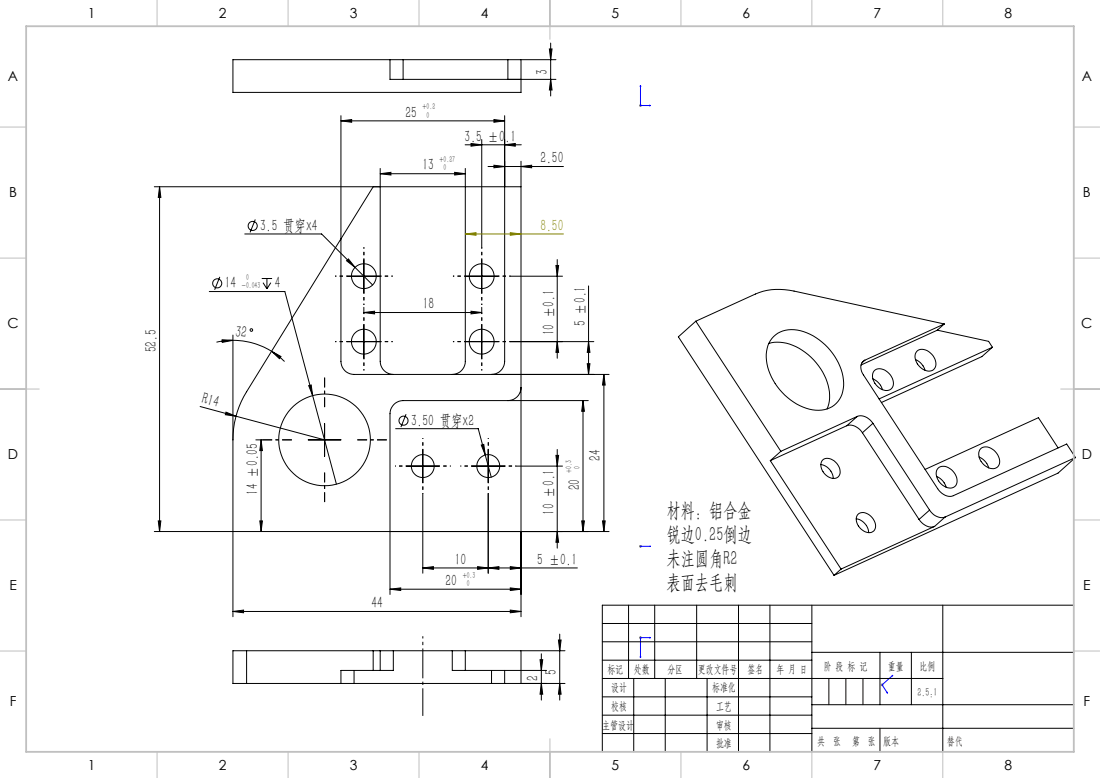
[picture p166: page 1]
3.50 贯穿x2; 3.5 贯穿x4

标记 | 处数 | 分区 | 更改文件号 | 签名 | 年 月 日
设计 | | | 标准化 | | | 2.5:1
校核 | | | 工艺
主管设计 | | | 审核
