lgc-robotics/end_effector_project/潭江茶-谭键聪/第一代谭江茶/加工件/工程图/pdf/上盖2前.pdf

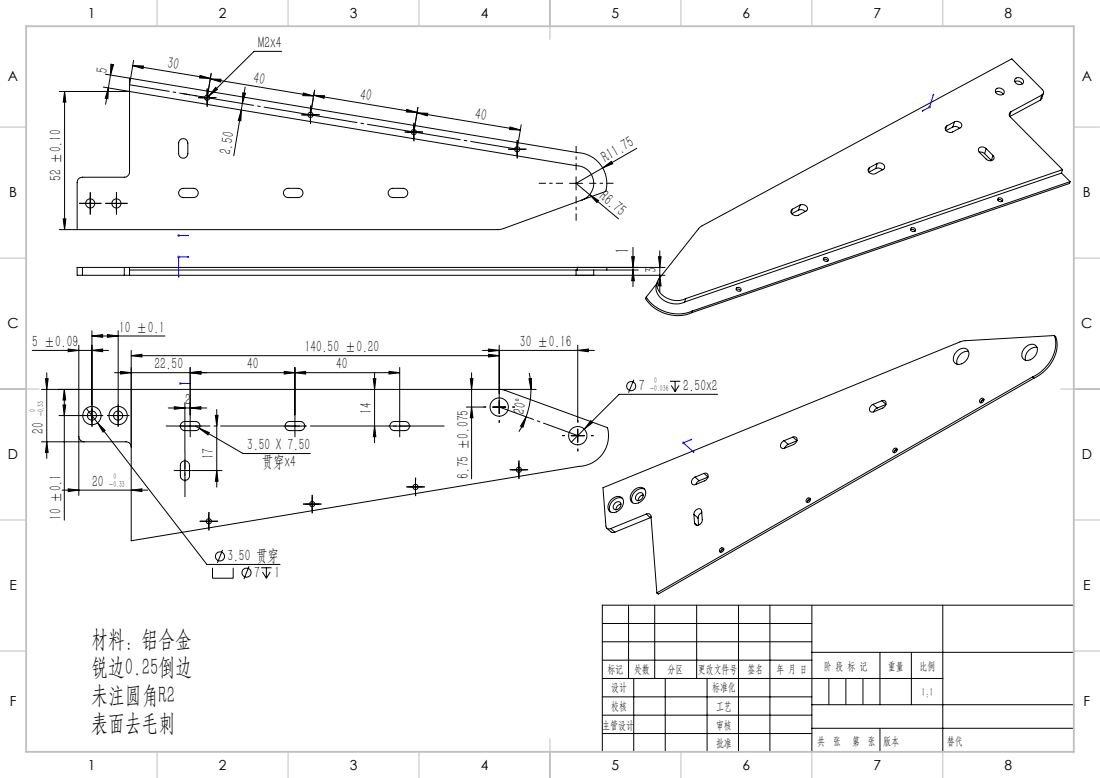
[picture p167: page 1]

标记 | 处数 | 分区 | 更改文件号 | 签名 | 年 月 日
设计 | | | 标准化 | | | 1:1
校核 | | | 工艺
主管设计 | | | 审核
