lgc-robotics/end_effector_project/潭江茶-谭键聪/第一代谭江茶/加工件/工程图/pdf/底座后.pdf

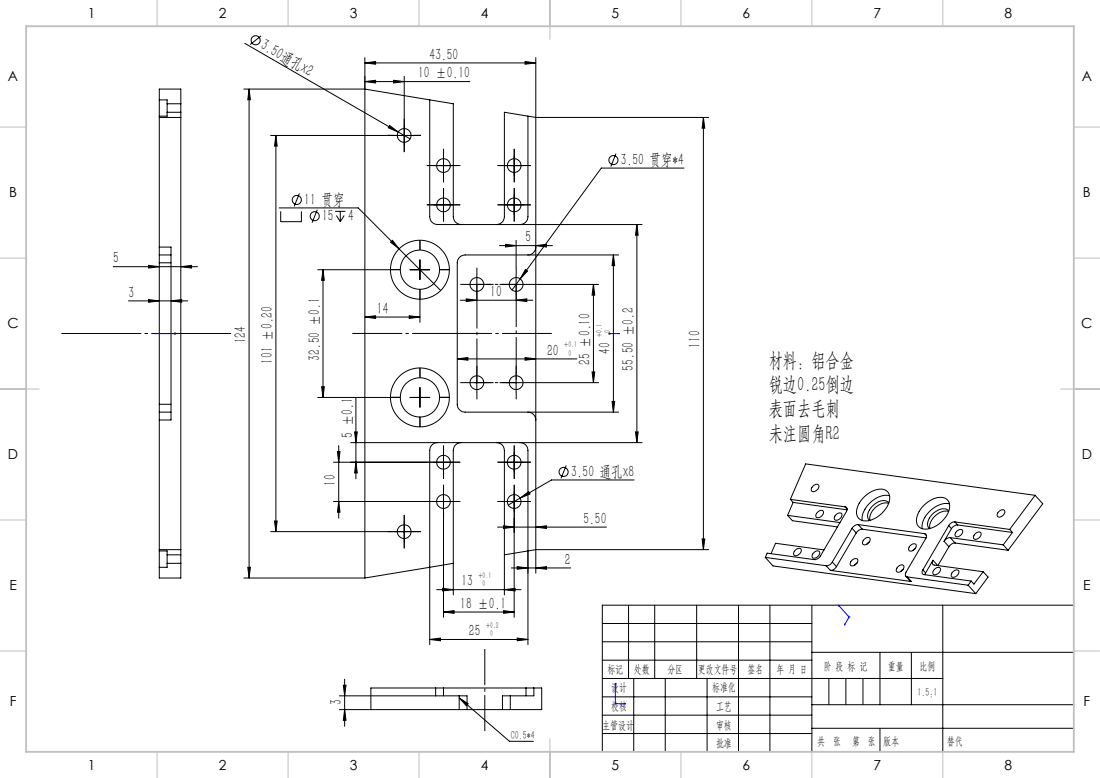
[picture p174: page 1]
32.50 ±0.1 3.50通孔x2; 3.50 通孔x8

标记 | 处数 | 分区 | 更改文件号 | 签名 | 年 月 日
设计 | | | | 标准化 | | 1.5:1

主管设计 | | | | 审核
